LarsLangenbach/halloween-animatronic/output/manual/s5_06_complete.png

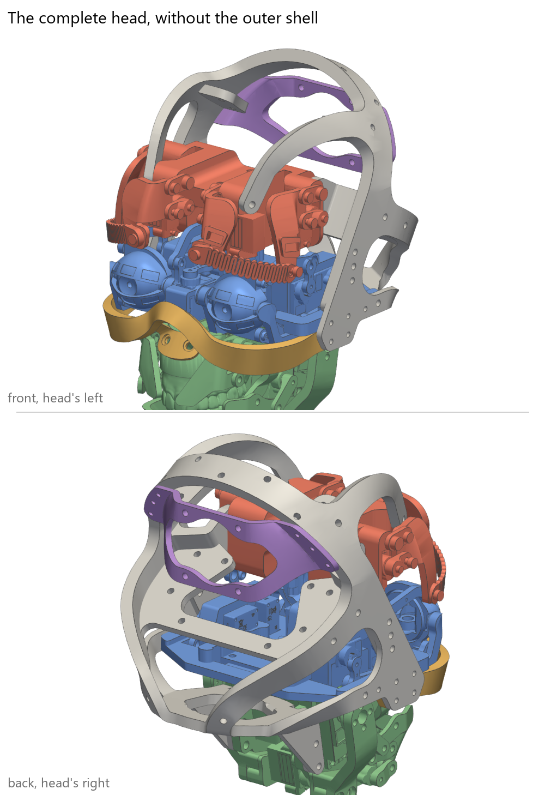
output/manual/s5_06_complete.png
