LarsLangenbach/halloween-animatronic/output/manual/s3_08_lower_teeth.png

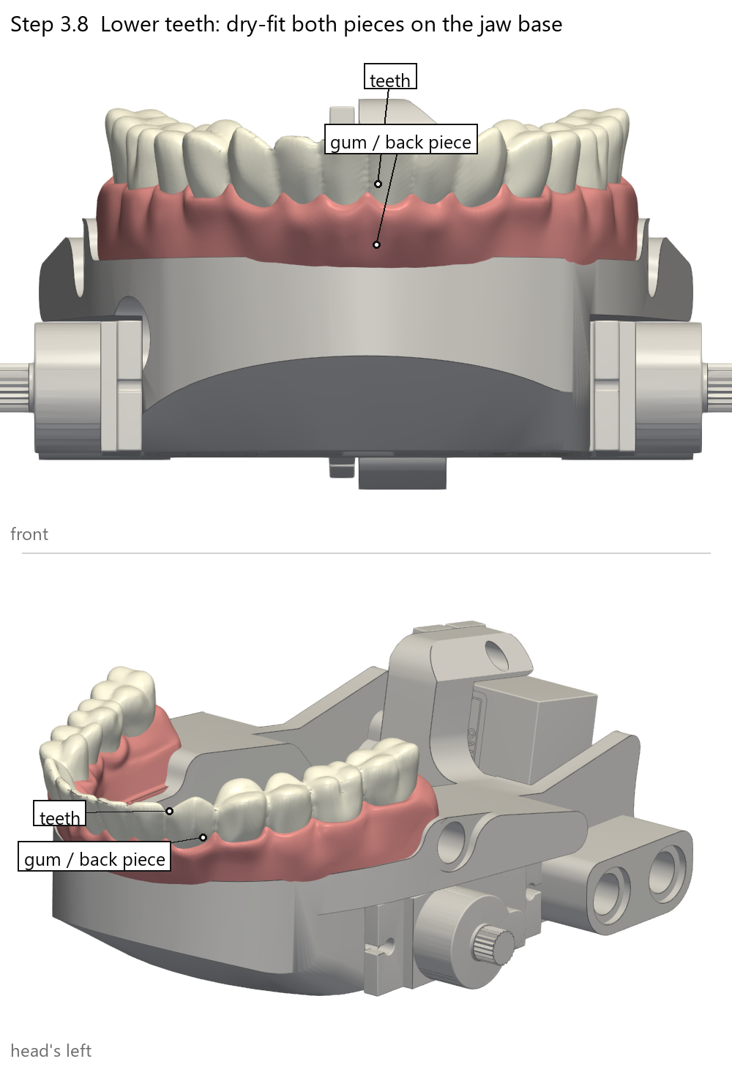
output/manual/s3_08_lower_teeth.png
