LarsLangenbach/halloween-animatronic/process_images/README.md

# Process images

The picture record of the build, oldest first. One folder per snapshot, made with `python cad/snapshot.py <label> --note "..."` after a check.
The build log ([docs/BUILD_LOG.md](../docs/BUILD_LOG.md)) links here.

- **2026-10-15_01_M1-layout-1.0x-life-size**: M1 first fit test at true life size (1.0x, average head): the eye and mouth mechanisms crash into each other (17 mm) and stick out of the skull. Re-rendered with the final check tools. ([layout.png](2026-10-15_01_M1-layout-1.0x-life-size/layout.png), 8 file(s))
- **2026-10-15_02_M1-layout-1.2x-average-head**: M1 at 1.2x with an average head shape: everything fits except the EyeMech side plates, which poke 7 mm out through the temples (see the front section). ([layout.png](2026-10-15_02_M1-layout-1.2x-average-head/layout.png), 8 file(s))
- **2026-10-15_03_M1-layout-1.2x-boxy-temples**: M1 at 1.2x with boxy, flat-sided temples: everything fits, but only 2.5 mm between the eye and mouth mechanisms, too little for any skull between them. ([layout.png](2026-10-15_03_M1-layout-1.2x-boxy-temples/layout.png), 8 file(s))
- **2026-10-15_04_M1-layout-1.2x-A2-approved**: M1 approved layout (D4 = A2): 1.2x, boxy temples, mouth 3 mm lower. 5.5 mm between the mechanisms, everything inside the head. Also the calibration coupon print check. ([layout.png](2026-10-15_04_M1-layout-1.2x-A2-approved/layout.png), 9 file(s))
- **2026-10-15_05_M1-motion-and-space**: M1 motion check: jaw opens cleanly to 35 deg (25 needed; lips open 12 to 41 mm), lids and eyes sweep clear, brow bays (purple) reserved above the eyes, cable channel (yellow) down the back of a thickened neck. Layout re-checked with the thicker neck. ([sweep.png](2026-10-15_05_M1-motion-and-space/sweep.png), 17 file(s))
- **2026-10-15_06_M1-motion-review-tongue-clash**: M1 motion after the fresh-eyes review: the check now catches a real clash: the tongue's back corner cuts up to ~2 mm into a fixed mouth servo between about 3 and 25 deg of jaw opening. Everything else on the jaw is clean to 35 deg; the servo horns now turn with the jaw; the jaw-link section shows the link turning on its bore. ([sweep.png](2026-10-15_06_M1-motion-review-tongue-clash/sweep.png), 17 file(s))
- **2026-10-15_07_M1-complete**: M1 complete: both Cogley mechanisms fit the 1.2x head at rest and through every motion (eye and lid ranges now from Cogley's firmware). The tongue/servo contact is accepted on the team's bench experience (D12). Brow bays and the cable channel are reserved. ([sweep.png](2026-10-15_07_M1-complete/sweep.png), 17 file(s))
- **2026-10-15_08_M2-brow-mechanism-v1**: M2 eyebrow v1: concept study (a whole-brow plate lifts off the skin, two snap pads on one skewed pivot track it within 0.9/1.6 mm, inner end rises 10.9 vs outer 7.6) and the first brow CAD: carrier, bracket, MG90S, 2:1 pushrod drive. Clears the EyeMech and lids through the full travel; first fully clean check (0 warnings). ([brow.png](2026-10-15_08_M2-brow-mechanism-v1/brow.png), 28 file(s))
- **2026-10-15_09_M2-brow-v1.1-stops-and-rig**: M2 eyebrow v1.1 after review: ball-stud room in the pushrod drive, hub sized to a stock M3 shoulder screw, flange inserts, adjustable hard stops on the double-arm horn (clear inside the travel, engage just past it), and the bench rig (a printed forehead fragment with a pad window and skin-clamp inserts). Check PASS, 0 warnings. ([brow.png](2026-10-15_09_M2-brow-v1.1-stops-and-rig/brow.png), 28 file(s))
- **2026-10-15_10_M3-start-true-offset-envelopes**: Accuracy fix before the skull: the skin and skull envelopes are now true offsets of the face (the first version made the skin as thin as 1.4 mm where the head leans). Every check re-run on them: layout, motion and eyebrows all still pass, the brow pivot moved about 1 mm, PASS with 0 warnings. ([brow.png](2026-10-15_10_M3-start-true-offset-envelopes/brow.png), 30 file(s))
- **2026-10-15_11_M3-skull-v0**: M3 skull v0: the printed skull the skin sits on: a 2.4 mm wall on true-offset envelopes, eye+brow and mouth openings cut square to the wall (no slivers), four printable pieces plus a shelf between the eyes and the mouth, and plates the brow brackets bolt up into. Nothing touches it at rest or in motion; PASS, 0 warnings. No joints, mounts, access panel or neck interface yet. ([skull.png](2026-10-15_11_M3-skull-v0/skull.png), 36 file(s))
- **2026-10-15_12_M3-skull-joints**: M3 skull with joints: 24 screwed tabs along the four seams (inserts in tabs behind the wall, countersunk screws flush under the skin), placed automatically clear of every mechanism, sweep, opening, the shelf and the brow plates. PASS, 0 warnings. ([skull.png](2026-10-15_12_M3-skull-joints/skull.png), 36 file(s))
- **2026-10-16_13_M3-eyemech-cradle**: M3: the EyeMech's cradle on the shelf (pads under its feet, a rear stop for eye-depth shims) and a retaining strap over the back of its base plate; shelf and strap bolt to ledges on the skull. PASS, 0 warnings. ([skull.png](2026-10-16_13_M3-eyemech-cradle/skull.png), 36 file(s))
- **2026-10-16_14_M3-neck-and-access-panel**: M3-neck-and-access-panel ([skull.png](2026-10-16_14_M3-neck-and-access-panel/skull.png), 38 file(s))
- **2026-10-16_15_M5-sculpt-base-and-service**: Sculpt base v1 (whole head, skull + 3 mm, eye sockets, grooves, base plate); service paths for the back, EyeMech and brows ([sculpt.png](2026-10-16_15_M5-sculpt-base-and-service/sculpt.png), 49 file(s))
- **2026-10-16_16_D14-cogley-head-fit**: Cogley's Robot Head a2.0.33 imported and fitted inside our head, eyes on ours ([studies_cogley_fit.png](2026-10-16_16_D14-cogley-head-fit/studies_cogley_fit.png), 57 file(s))
- **2026-10-16_17_cogley-brow-bar**: Cogley's flexible brow bar (Part 11): a pleated TPU strip, why PLA won't do ([studies_cogley_brow_bar.png](2026-10-16_17_cogley-brow-bar/studies_cogley_brow_bar.png), 58 file(s))
- **2026-10-16_18_cogley-complete-head**: Cogley's complete head with his outer shell: the new base for the face (D17) ([studies_cogley_complete.png](2026-10-16_18_cogley-complete-head/studies_cogley_complete.png), 63 file(s))
- **2026-10-16_19_cogley-eye-mount**: How the eye mechanism mounts in Cogley's frame: on the mouth's top plate, 2 screws per side through the frame into the base plate's ends, cheek bone underneath ([studies_cogley_eye_mount.png](2026-10-16_19_cogley-eye-mount/studies_cogley_eye_mount.png), 70 file(s))
- **2026-10-16_20_sculpt-base-v2**: Sculpt base v2 on Cogley's head: the 3 print files, assembled and exploded ([sculpt_files.png](2026-10-16_20_sculpt-base-v2/sculpt_files.png), 76 file(s))
- **2026-10-16_21_face-mask**: Face mask (D19): a man's face shell on the mechanism, clear of Cogley's head ([sculpt_face_mask.png](2026-10-16_21_face-mask/sculpt_face_mask.png), 88 file(s))
- **2026-10-16_22_face-mask-v2**: Face mask v2: closed eyes, natural nose and mouth, smooth edge, up onto the skull ([sculpt_face_mask.png](2026-10-16_22_face-mask-v2/sculpt_face_mask.png), 88 file(s))
- **2026-10-16_23_face-mask-v3**: Face mask v3: smooth, closed eyes, ears, mouth on Cogley's lip plates ([sculpt_face_mask.png](2026-10-16_23_face-mask-v3/sculpt_face_mask.png), 88 file(s))
- **2026-10-16_24_face-mask-v4**: Face mask v4: open eyes on the eye axes, MakeHuman lips on Cogley's lip plates ([sculpt_face_mask.png](2026-10-16_24_face-mask-v4/sculpt_face_mask.png), 88 file(s))
- **2026-10-16_25_face-mask-v5**: Face mask v5: MakeHuman's own eyes (with eyeballs) and lips, placed on the mechanism ([sculpt_face_mask.png](2026-10-16_25_face-mask-v5/sculpt_face_mask.png), 88 file(s))
- **2026-10-16_26_face-mask-v6**: Face mask v6: eyes exactly on the eye axes, real MakeHuman lips with a clean closed line, inside never crosses the skin ([skull.png](2026-10-16_26_face-mask-v6/skull.png), 62 file(s))
- **2026-10-16_27_face-mask-v7**: Face mask v7: flat lips with parting line and lip outlines; iris rings inside the eyes ([skull.png](2026-10-16_27_face-mask-v7/skull.png), 68 file(s))
- **2026-10-16_28_face-mask-v7b**: Face mask v7b: mouth area completely flat from under the nose to above the chin, with the lip lines ([skull.png](2026-10-16_28_face-mask-v7b/skull.png), 68 file(s))
- **2026-10-16_29_face-mask-v8**: Face mask v8: 2 mm shell; eyes and mouth flat with marks, nose low as a guide ([skull.png](2026-10-16_29_face-mask-v8/skull.png), 76 file(s))
- **2026-10-16_30_face-mask-v9**: Face mask v9: almond eyelids back, eye openings flat (no eyeball, no target) ([skull.png](2026-10-16_30_face-mask-v9/skull.png), 83 file(s))
- **2026-10-17_31_lips-on-printed-mask**: Where the lips really sit on the printed v9 mask: 71.2 mm below the eye line, about 6 mm above the printed groove ([views.png](2026-10-17_31_lips-on-printed-mask/views.png), 11 file(s))
- **2026-10-17_32_mask-on-cogley-head**: The printed mask (v9) see-through on Cogley's whole head, with eye centres and the true lip line ([views.png](2026-10-17_32_mask-on-cogley-head/views.png), 12 file(s))
- **2026-10-20_33_mold-base**: Mold base for the plaster mold: the clay-covered mask face up in a printed collar (ledge, lip, flared skirt), posts, flange with keys, walls; 4 pieces. Red = where a one-piece mold would lock (fill with clay or use side pieces) ([mold.png](2026-10-20_33_mold-base/mold.png), 53 file(s))
- **2026-10-20_34_mold-base-removable-walls**: Mold base v2: the walls are 4 separate L corners clipped together at ears, standing outside a rib on the plate; they come off outward before the plaster is lifted; 8 pry pockets ([mold.png](2026-10-20_34_mold-base-removable-walls/mold.png), 53 file(s))
- **2026-10-20_35_mold-pry-wedges**: Mold base v3: 8 loose pry wedges in gaps in the rib against the walls; pulled out with an M3 screw once the walls are off, they leave slots under the flange for a screwdriver ([mold.png](2026-10-20_35_mold-pry-wedges/mold.png), 54 file(s))
- **2026-10-22_36_assembly-manual**: Assembly manual pictures for Cogley's Robot Head a2.0.33: inserts per part, EyeMech servo map, mouth, brows and mounting steps, one image per step ([s3_12_mouth_servo_map.png](2026-10-22_36_assembly-manual/s3_12_mouth_servo_map.png), 28 file(s))
- **2026-10-25_37_assembly-manual-eyes-inserts**: Assembly manual: the EyeMech built step by step (2.2-2.13, from his e3.1 model), the 28 M3 inserts in the mouth and brow linkage parts (step 1.6), and the lip, corner, tongue and brow steps redrawn with them ([s2_13_eye_servo_map.png](2026-10-25_37_assembly-manual-eyes-inserts/s2_13_eye_servo_map.png), 20 file(s))
- **2026-10-25_38_eyemech-servo-joints**: How the two eye servos drive the eyes: horn screwed to the shaft, a peg turning in the horn's far hole (up/down: arch lever; left/right: part B) ([studies_eye_joint_left_right.png](2026-10-25_38_eyemech-servo-joints/studies_eye_joint_left_right.png), 2 file(s))
- **2026-10-28_39_enclosure-concept**: Enclosure concept: a printed D 340 canister round the head, base drum and top cap in quadrants, a rolled 1 mm clear sheet in slits, a 120-degree opaque back column; the real head drawn inside to scale ([studies_enclosure_concept.png](2026-10-28_39_enclosure-concept/studies_enclosure_concept.png), 2 file(s))
- **2026-10-28_40_enclosure-concept-camera**: Enclosure concept with the camera: in the top cap's front band, lens behind a D 8 hole among the vents, 10 deg down; cable round the cap ring and down the back column ([studies_enclosure_concept.png](2026-10-28_40_enclosure-concept-camera/studies_enclosure_concept.png), 2 file(s))
- **2026-10-28_41_enclosure-concept-no-lights**: Enclosure concept without lights: the LED ring is dropped, the camera stays in the cap's front band ([studies_enclosure_concept.png](2026-10-28_41_enclosure-concept-no-lights/studies_enclosure_concept.png), 2 file(s))
- **2026-10-28_42_enclosure-concept-webcam**: Enclosure concept with the Logitech 1080p webcam in a cradle against the cap's front wall, lens behind a D 12 hole, 10 deg down; USB lead down the column and out of the base ([studies_enclosure_concept.png](2026-10-28_42_enclosure-concept-webcam/studies_enclosure_concept.png), 2 file(s))
- **2026-10-28_43_enclosure-concept-power-box**: Enclosure concept, sizes fixed: D 340 x 638, 1 mm PETG sheet, the power box (bank, trigger, buck, fuses) and two boards on the floor tray, a back hatch for the bank and the leads to the laptop, the Logitech webcam in the cap ([studies_enclosure_concept.png](2026-10-28_43_enclosure-concept-power-box/studies_enclosure_concept.png), 2 file(s))
- **2026-10-28_44_enclosure-concept-speaker**: Enclosure concept with the speaker back in the base: a Dayton ND65-4 2.5 in driver in a sealed chamber behind the front slots, its 5 V amp beside it; power box, two boards, back hatch, webcam in the cap ([studies_enclosure_concept.png](2026-10-28_44_enclosure-concept-speaker/studies_enclosure_concept.png), 2 file(s))
- **2026-10-28_45_enclosure-concept-usb-speaker**: Enclosure concept: the speaker is a ready-made Anker PowerConf S330 USB speakerphone puck flat on the tray behind the front slots (no soldering); power box, two boards, back hatch, webcam in the cap ([studies_enclosure_concept.png](2026-10-28_45_enclosure-concept-usb-speaker/studies_enclosure_concept.png), 2 file(s))
- **2026-10-28_46_enclosure-concept-cheap-speakers**: Enclosure concept: the speakers are a cheap Amazon Basics USB-powered pair (3.5 mm aux), one each side behind the base's front slots; power box, two boards, back hatch, webcam in the cap ([studies_enclosure_concept.png](2026-10-28_46_enclosure-concept-cheap-speakers/studies_enclosure_concept.png), 2 file(s))
- **2026-10-28_47_enclosure-concept-sony-xb12**: Enclosure concept: the speaker is the human's Sony SRS-XB12 on its side by the back hatch (aux from the laptop); power box, two boards, webcam in the cap ([studies_enclosure_concept.png](2026-10-28_47_enclosure-concept-sony-xb12/studies_enclosure_concept.png), 2 file(s))
- **2026-10-28_48_enclosure-concept-front-grille**: Enclosure concept: the Sony SRS-XB12 moves to the front of the base, driver end at a snap-out grille panel in the front wall (also the access to its buttons) ([studies_enclosure_concept.png](2026-10-28_48_enclosure-concept-front-grille/studies_enclosure_concept.png), 2 file(s))
- **2026-10-28_49_enclosure-concept-neck-spine**: Enclosure concept with the proposed neck (Q17): a D 100 column to z 70 under the jaw's swing, then a 30 x 80 spine behind the jaw up into the frame's nape ribs; the jaw at rest and open drawn for clearance ([studies_enclosure_concept.png](2026-10-28_49_enclosure-concept-neck-spine/studies_enclosure_concept.png), 2 file(s))
- **2026-10-29_50_enclosure-v0**: Enclosure and neck modelled (M8 v0): 31 prints, the canister round the head, the neck spine behind the jaw; check PASS, the reviewer's five findings fixed ([enclosure.png](2026-10-29_50_enclosure-v0/enclosure.png), 65 file(s))
- **2026-10-29_51_enclosure-v1**: Enclosure v1 for a one-day build: eleven thin prints plus two PETG sheets; check PASS; studies_neck_mount.png shows how the head attaches (frame, spine, foot, pedestal, tray, every screw) ([enclosure.png](2026-10-29_51_enclosure-v1/enclosure.png), 72 file(s))
- **2026-10-29_52_lids-plate**: Just the eyelids: Cogley's 4 lid sets (size B file) on one plate in his print-in-place pose ([plates_cogley_lids_plate.png](2026-10-29_52_lids-plate/plates_cogley_lids_plate.png), 1 file(s))
- **2026-10-29_53_lids-keyed**: Keyed lids (D27): Cogley's lids perforated with counterbored radial holes so the brushed silicone rivets through; close-ups and the 4-set plate ([plates_cogley_lids_keyed.png](2026-10-29_53_lids-keyed/plates_cogley_lids_keyed.png), 2 file(s))
- **2026-10-29_54_lids-keyed-5mm**: Keyed lids (D27) at the 5.0 pitch after review: 21-24 holes per lid, 0.97 mm ribs between counterbores ([plates_cogley_lids_keyed.png](2026-10-29_54_lids-keyed-5mm/plates_cogley_lids_keyed.png), 2 file(s))
- **2026-10-29_52_neck-clamp**: Neck v2 (D30): the neck clamps Cogley's nape ring between a saddle, a collar in its hexagonal hole and two plates with 4 x M4; nothing drilled in his parts ([studies_neck_mount.png](2026-10-29_52_neck-clamp/studies_neck_mount.png), 72 file(s))
- **2026-10-29_53_band-printed**: The base's band printed in two halves instead of PETG (D31): pointed openings, the leads' notch, seam walls; band_print_check.png shows the halves on the bed ([enclosure.png](2026-10-29_53_band-printed/enclosure.png), 66 file(s))
- **2026-10-29_54_band-nut-slots**: Printed band after review: nut slots for the panels' upper screws, the tie under B's notch; band_print_check.png and band_nut_boss.png added ([enclosure.png](2026-10-29_54_band-nut-slots/enclosure.png), 66 file(s))
- **2026-10-30_55_enclosure-manual**: Enclosure build manual pictures, one per step: neck inserts, the head's test fit, the pedestal's hand-cut lead door and glue spots, rings, band, nut slots, panels, the bay, the clamp plates, deck, window, cap ([s6_03_complete.png](2026-10-30_55_enclosure-manual/s6_03_complete.png), 18 file(s))
- **2026-10-30_59_body-twin**: Frank's body twin (perform/, D32): the CAD head moving with the servo stream, here simulated: a surprised face (jaw part-open, lids wide, eyes up, brows raised), at rest, and from the side ([studies_twin_surprised.png](2026-10-30_59_body-twin/studies_twin_surprised.png), 3 file(s))
