LarsLangenbach/halloween-animatronic/process_images/2026-10-28_39_enclosure-concept/studies_enclosure_concept.md

# Enclosure concept numbers

- Axis: x 0, y -70 (the neck's axis, SCULPT_NECK).
- Head about the axis: front r 119, back r 117, sides r 103; crown z 351.
- Sheet D 300 inside: clear 31 at the face, 33 at the back, 47 at the ears.
- Sheet blank: 630 long x 458 tall, 1 thick (240 deg of the circle).
- Rings D 340 outside, 4 quadrants each (a quadrant's box is 170 x 170, the bed is 256).
- Base 118 tall (bay 96 clear inside), window 440, cap 80; overall 638.
- Back column: 120 deg arc, 10 thick, 2 wide x 2 tall pieces (each 170 chord x 220 tall).
- Pedestal D 130 to 110, 40 tall, under the neck (Q17) with 4 x M4 on a 50 square and a D 25 bore.
