LarsLangenbach/halloween-animatronic/process_images/2026-10-28_43_enclosure-concept-power-box/studies_enclosure_concept.md

# Enclosure concept numbers

- Axis: x 0, y -70 (the neck's axis, SCULPT_NECK).
- Head about the axis: front r 119, back r 117, sides r 103; crown z 351.
- Sheet D 300 inside: clear 31 at the face, 33 at the back, 47 at the ears.
- Sheet: 1 mm clear PETG, blank 630 long x 458 tall (240 deg of the circle).
- Rings D 340 outside, 4 quadrants each (a quadrant's box is 170 x 170, the bed is 256).
- Base 118 tall (bay 96 clear inside), window 440, cap 80; overall 638.
- Back column: 120 deg arc, 10 thick, 2 wide x 2 tall pieces (each 170 chord x 220 tall).
- Pedestal D 130 to 110, 40 tall, under the neck (Q17) with 4 x M4 on a 50 square and a D 25 bore.
- Camera: Logitech 1080p webcam (94 x 29 x 24, 78 deg) in a cradle against the cap's front wall at z 430, lens behind a D 12 hole among the vents, 10 deg down; its 1.5 m USB lead runs round the cap ring and down the back column to the base. Its two mics hear through the vent slots beside the lens, so the base needs no mic.
- Base bay: the power bank 161 x 55 x 50, the buck 85 x 60 x 28 with the trigger, fuses, WAGOs and capacitor, and 2 boards 95 x 65 x 20, all on the floor tray; a back hatch under the column's foot for the bank and the leads out. The laptop and the speaker stay outside.
