LarsLangenbach/halloween-animatronic/process_images/2026-10-15_08_M2-brow-mechanism-v1/studies_brow_concepts.md

# M2 brow concept study

Left brow, head scale 1.2. Brow line z 238.4 (26.0 above the eye line). Carrier face 1.5 behind the skin's inner surface. Travel at mid-brow (x 37): +10.0 / -5.0 along the skin. Limits: push <= 1.0, pull <= 3.0, inner/outer rise 1.5 +- 0.1 (D5).

## A: one plate across the whole brow, axis along x (reference)

| r behind the brow | worst push | worst pull | inner / outer rise |
|---|---|---|---|
| 20 | 1.8 | 6.9 | 9.9 / 6.1 |
| 30 | 1.1 | 4.7 | 10.0 / 7.4 |
| 40 | 0.8 | 3.6 | 10.0 / 8.0 |
| 50 | 0.6 | 2.9 | 9.9 / 8.4 |
| 70 | 0.4 | 2.2 | 9.9 / 8.8 |

A rigid plate 46 mm wide can't follow the face as it curves back toward the temple: it either digs into the skin or lifts off by several mm. Hence the two-pad carrier.

## P: two snap pads (|x| 22 and 52, 10 mm square) on one axis

Searched 2431 pivots (r 15..75, offset along the face -20..20, skew -24..24 deg); 3 meet every limit with the pivot inside the brow bay. Best ones:

| r | offset | skew deg | pivot (y, z above eyes) | push | pull | inner / outer rise |
|---|---|---|---|---|---|---|
| 45 | +4 | +12 | (-22.1, 21.2) | 0.90 | 1.62 | 10.9 / 7.6 |
| 45 | +4 | +15 | (-22.1, 21.2) | 0.91 | 1.65 | 11.1 / 7.4 |
| 45 | +4 | +18 | (-22.1, 21.2) | 0.92 | 1.67 | 11.3 / 7.1 |

**Pick: r 45, offset +4, skew +12 deg.** Pivot at x 27.1, y -22.1, z 233.6 (eye line + 21.2), 46.3 behind the carrier face; axis (0.978, 0.208, 0). Pads move 0.90 toward / 1.62 away from the skin; inner pad rises 10.9, outer 7.6 at full raise. Servo rotation for full travel: +12 / -6 deg (approx.).
