LarsLangenbach/halloween-animatronic/process_images/2026-10-29_52_neck-clamp/enclosure.md

# Enclosure check

- Head about the axis: widest r 118.8 at (2, 49, 98); 19.4 inside the sheet (D 276). Crown z 351.3, 88.7 under the cap.
- Sheet: 478 tall, z -40..438; blank 891 x 477 mm (a full tube, 20 overlap, 1 play in height).
- Band: 110 tall, z -140..-30; blank 928 x 109 mm (a full tube, 20 overlap, 1 play in height).

## The neck and its clamp against Cogley's head (at rest)

- neck: no overlap with his parts; 0.08 mm from the frame's nape ring (modelled gap 0.1: it sits on the ring)
- neck_clamp_L: no overlap with his parts; 0.12 mm from the frame's nape ring (modelled gap 0.1: it sits on the ring)
- neck_clamp_R: no overlap with his parts; 0.12 mm from the frame's nape ring (modelled gap 0.1: it sits on the ring)
- The clamp: the collar's top stays 0.9 under the plates, so four M4 x 12 pull the plates down onto the ring and the ring onto the saddle
- Screw (+18, -5): 35 mm clear over its head for the hex key (rear plate off)
- Screw (-18, -5): 35 mm clear over its head for the hex key (rear plate off)
- Screw (+13, -14): 30 mm clear over its head for the hex key (rear plate off)
- Screw (-13, -14): 30 mm clear over its head for the hex key (rear plate off)

## The jaw swept against the neck and its clamp plates

| angle | gap to the neck |
|---|---|
| 0 | 26.1 |
| 5 | 24.2 |
| 10 | 21.0 |
| 15 | 17.2 |
| 20 | 13.3 |
| 25 | 9.6 |
| 30 | 6.0 |
| 35 | 2.5 |

## What lives in the base and the cap

- bank: z -141..-91, out to r 134
- board_1: z -91..-71, out to r 149
- board_2: z -91..-71, out to r 149
- buck: z -141..-113, out to r 126
- speaker: z -140..-67, out to r 130
- webcam: z 410..439, y 33..57

## Pieces on the bed (in the print pose)

| part | x | y | z |
|---|---|---|---|
| enc_cap_F | 249 | 249 | 41 |
| enc_cap_B | 249 | 249 | 41 |
| enc_top_F | 246 | 246 | 12 |
| enc_top_B | 246 | 246 | 12 |
| enc_bottom_F | 246 | 246 | 12 |
| enc_bottom_B | 246 | 246 | 12 |
| enc_tray | 250 | 250 | 52 |
| enc_pedestal | 90 | 90 | 142 |
| enc_grille | 126 | 96 | 16 |
| enc_hatch | 126 | 96 | 16 |
| neck | 100 | 122 | 183 |
| neck_clamp_L | 34 | 64 | 5 |
| neck_clamp_R | 34 | 64 | 5 |

## Result

- note: the jaw clears the neck through 35 deg

Render: enclosure.png
