LarsLangenbach/halloween-animatronic/output/plates/cogley_lids_keyed.md

# Keyed lids (D27)

Cogley's four lid sets from `eyemech_e3.2_MG90s_B_cogley.3mf`, each lid perforated for the brushed silicone skin: Ø2.2 radial through-holes with a Ø3.4 × 0.7 counterbore flush with the inner face, 5.0 mm apart, only through plain 1.6 mm wall with 1.1 mm kept round each counterbore. Built by `cad/lid_keyed.py`. Result: **PASS**

| set | holes | STEP fit median / max | nearest holes | wall between counterbores | removed mm³ |
|---|---|---|---|---|---|
| LidTR (object 26) | 23 | 0.006 / 0.044 | 4.37 | 0.97 | 252 |
| LidBR (object 30) | 21 | 0.008 / 0.055 | 4.38 | 0.98 | 225 |
| LidTR (object 34) | 21 | 0.003 / 0.041 | 4.38 | 0.98 | 225 |
| LidBR (object 38) | 24 | 0.003 / 0.052 | 4.37 | 0.97 | 270 |

Plate: `cogley_lids_keyed_plate.stl` (preview `cogley_lids_keyed_plate.png`); close-ups `cogley_lids_keyed.png`.
