LarsLangenbach/halloween-animatronic/process_images/2026-10-29_51_enclosure-v1/enclosure.md

# Enclosure check

- Head about the axis: widest r 118.8 at (2, 49, 98); 19.4 inside the sheet (D 276). Crown z 351.3, 88.7 under the cap.
- Sheet: 478 tall, z -40..438; blank 891 x 477 mm (a full tube, 20 overlap, 1 play in height).
- Band: 110 tall, z -140..-30; blank 928 x 109 mm (a full tube, 20 overlap, 1 play in height).

## The neck against Cogley's head (at rest)

- No overlap with any of his parts; the spine's top sits under the frame's nape members
- Gap spine top to the frame: 1.5 mm (0 = touching or inside)

## The jaw swept against the neck

| angle | gap to the neck |
|---|---|
| 0 | 26.1 |
| 5 | 24.2 |
| 10 | 21.0 |
| 15 | 17.2 |
| 20 | 13.3 |
| 25 | 9.6 |
| 30 | 6.0 |
| 35 | 2.5 |

## What lives in the base and the cap

- bank: z -141..-91, out to r 134
- board_1: z -91..-71, out to r 149
- board_2: z -91..-71, out to r 149
- buck: z -141..-113, out to r 126
- speaker: z -140..-67, out to r 130
- webcam: z 410..439, y 33..57

## Pieces on the bed (in the print pose)

| part | x | y | z |
|---|---|---|---|
| enc_cap_F | 249 | 249 | 41 |
| enc_cap_B | 249 | 249 | 41 |
| enc_top_F | 246 | 246 | 12 |
| enc_top_B | 246 | 246 | 12 |
| enc_bottom_F | 246 | 246 | 12 |
| enc_bottom_B | 246 | 246 | 12 |
| enc_tray | 250 | 250 | 52 |
| enc_pedestal | 90 | 90 | 142 |
| enc_grille | 96 | 16 | 126 |
| enc_hatch | 96 | 16 | 126 |
| neck | 100 | 105 | 170 |

## Result

- note: the jaw clears the neck through 35 deg

Render: enclosure.png
