LarsLangenbach/halloween-animatronic/process_images/2026-10-29_50_enclosure-v0/enclosure.md

# Enclosure check

- Head about the axis: widest r 118.8 at (2, 49, 98); 31.2 inside the sheet (D 300). Crown z 351.3, 48.7 under the cap.
- Sheet: 458 tall, z -46..412; blank 644 x 458 mm (the arc plus the forks' slots, 0.5 play at each end).

## The neck against Cogley's head (at rest)

- No overlap with any of his parts; the spine's top sits under the frame's nape members
- Gap spine top to the frame: 1.5 mm (0 = touching or inside)

## The jaw swept against the neck

| angle | gap to the neck |
|---|---|
| 0 | 26.1 |
| 5 | 24.2 |
| 10 | 21.0 |
| 15 | 17.1 |
| 20 | 13.3 |
| 25 | 9.6 |
| 30 | 6.0 |
| 35 | 2.5 |

## What lives in the base and the cap

- bank: z -134..-84, out to r 125
- board_1: z -134..-114, out to r 130
- board_2: z -134..-114, out to r 130
- buck: z -134..-106, out to r 59
- speaker: z -133..-59, out to r 152
- webcam: z 418..447, y 64..88

## Pieces on the bed

| part | x | y | z |
|---|---|---|---|
| enc_base_F | 240 | 89 | 98 |
| enc_base_L | 89 | 240 | 98 |
| enc_base_B | 240 | 89 | 98 |
| enc_base_R | 89 | 240 | 98 |
| enc_ring_1 | 170 | 170 | 12 |
| enc_ring_2 | 170 | 170 | 12 |
| enc_ring_3 | 170 | 170 | 12 |
| enc_ring_4 | 170 | 170 | 12 |
| enc_tray | 250 | 250 | 52 |
| enc_deck | 239 | 239 | 8 |
| enc_pedestal | 130 | 130 | 40 |
| enc_grille | 126 | 15 | 96 |
| enc_hatch | 126 | 15 | 96 |
| enc_column_R_lower | 161 | 97 | 232 |
| enc_column_R_upper | 161 | 97 | 220 |
| enc_column_L_lower | 151 | 99 | 232 |
| enc_column_L_upper | 151 | 99 | 220 |
| enc_capring_1 | 170 | 170 | 16 |
| enc_capring_2 | 170 | 170 | 16 |
| enc_capring_3 | 170 | 170 | 16 |
| enc_capring_4 | 170 | 170 | 16 |
| enc_cap_F | 240 | 71 | 52 |
| enc_cap_L | 71 | 240 | 52 |
| enc_cap_B | 240 | 71 | 52 |
| enc_cap_R | 71 | 240 | 52 |
| enc_captop_1 | 170 | 170 | 12 |
| enc_captop_2 | 170 | 170 | 12 |
| enc_captop_3 | 170 | 170 | 12 |
| enc_captop_4 | 170 | 170 | 12 |
| enc_lid | 239 | 239 | 8 |
| neck | 100 | 105 | 170 |

## Result

- note: the jaw clears the neck through 35 deg

Render: enclosure.png
