LarsLangenbach/halloween-animatronic/process_images/2026-10-29_52_neck-clamp/sculpt.md

# Sculpt base check

- his parts coming through the base: 0; 18 open meshes checked by distance only
- thinnest skin over his parts (to the base's surface): 2.58 mm (Hex socket head cap screw M3x0.50 x 10 4 at [87.0, -62.0, 238.0]); want >= 2.1
- eye left: sphere at [37.5, 0.0, 212.4], his eyeball at [37.5, 0.0, 212.4] (0.00 off)
- eye right: sphere at [-37.5, 0.0, 212.4], his eyeball at [-37.5, 0.0, 212.4] (0.00 off)
- sculpt_upper: 181.6 x 226.1 x 165.3 mm, 4167 cm3
- sculpt_lower: 169.0 x 210.3 x 146.0 mm, 2108 cm3
- sculpt_plate: 159.0 x 174.4 x 8.0 mm, 172 cm3

Renders: sculpt.png

## Issues

none
