LarsLangenbach/halloween-animatronic/process_images/2026-10-16_25_face-mask-v5/studies_cogley_fit.md

# Cogley head a2.0.33 in our head (study, D14)

His eye centres on ours: (+-37.5, 0, 212.4). Margins in mm, positive = inside. Robot outer shell left out (our shell replaces it).

| group | parts | worst vs skull inside | worst vs skull outside | worst part |
|---|---|---|---|---|
| frame | 1 | -3.2 | -0.8 | SkullFrame 0 at [77.0, -40.0, 180.0] |
| extras | 2 | -8.2 | -5.8 | CheekBone 0 at [0.0, 30.0, 202.0] |
| eyes | 35 | -0.5 | 1.9 | LidTR 1 at [-45.0, 17.0, 207.0] |
| mouth | 44 | -3.5 | -1.1 | UpperLeftLip 0 at [-8.0, 25.0, 150.0] |
| brows | 17 | -7.6 | -5.2 | Part 14 0 at [-22.0, 28.0, 253.0] |
| hardware | 88 | -5.1 | -2.7 | Hex socket head cap screw M3x0.50 x 10 0 at [86.0, -61.0, 217.0] |

Parts standing outside the skull's inside (negative margins):

-   -8.2  extras   CheekBone 0 at [0.0, 30.0, 202.0]
-   -7.6  brows    Part 14 0 at [-22.0, 28.0, 253.0]
-   -7.6  brows    Part 11 0 at [22.0, 28.0, 253.0]
-   -5.5  brows    Part 12 0 at [-28.0, 24.0, 259.0]
-   -5.1  hardware Hex socket head cap screw M3x0.50 x 10 0 at [86.0, -61.0, 217.0]
-   -5.1  hardware Hex socket head cap screw M3x0.50 x 10 3 at [-86.0, -61.0, 217.0]
-   -4.8  hardware Hex socket head cap screw M3x0.50 x 8 7 at [80.0, -40.0, 183.0]
-   -4.8  hardware Hex socket head cap screw M3x0.50 x 8 1 at [-80.0, -40.0, 183.0]
-   -4.5  hardware Hex socket head cap screw M3x0.50 x 10 1 at [-87.0, -63.0, 226.0]
-   -4.5  hardware Hex socket head cap screw M3x0.50 x 10 2 at [87.0, -63.0, 226.0]
-   -3.5  mouth    UpperLeftLip 0 at [-8.0, 25.0, 150.0]
-   -3.5  mouth    Part 34 0 at [8.0, 25.0, 150.0]
-   -3.3  hardware Hex socket head cap screw M3x0.50 x 10 4 at [87.0, -64.0, 235.0]
-   -3.3  hardware Hex socket head cap screw M3x0.50 x 10 5 at [-87.0, -64.0, 235.0]
-   -3.2  frame    SkullFrame 0 at [77.0, -40.0, 180.0]
-   -3.1  brows    Part 8 0 at [20.0, 23.0, 256.0]
-   -3.0  hardware Hex socket head cap screw M3x0.50 x 8 2 at [-80.0, -58.0, 183.0]
-   -3.0  hardware Hex socket head cap screw M3x0.50 x 8 4 at [80.0, -58.0, 183.0]
-   -2.5  hardware Hex socket head cap screw M3x0.50 x 8 3 at [-80.0, -40.0, 195.0]
-   -2.5  hardware Hex socket head cap screw M3x0.50 x 8 5 at [80.0, -40.0, 195.0]
-   -0.7  hardware Hex socket head cap screw M3x0.50 x 8 0 at [80.0, -57.0, 195.0]
-   -0.7  hardware Hex socket head cap screw M3x0.50 x 8 6 at [-80.0, -57.0, 195.0]
-   -0.5  eyes     LidTR 1 at [-45.0, 17.0, 207.0]
-   -0.5  eyes     LidTR 0 at [45.0, 17.0, 207.0]

His mouth (TopBase) against ours: [0.0, 1.3, 13.4] mm (x, y, z). His EyeMech base plate sits 0.2 mm above his TopBase's top.

Renders: cogley_fit.png
