LarsLangenbach/halloween-animatronic/process_images/2026-10-16_19_cogley-eye-mount/sculpt.md

# Sculpt base check

- skull outside the base: at most 0.00 mm (skull_front_upper at [20.5, 23.399999618530273, 201.8000030517578])
- eye left: sphere at [37.5, 0.0, 212.4], EyeMech eyeball at [37.5, -0.0, 212.4] (0.00 off)
- eye right: sphere at [-37.5, 0.0, 212.4], EyeMech eyeball at [-37.5, -0.0, 212.4] (0.00 off)
- sculpt_upper: 183.3 x 247.9 x 168.4 mm, 5088 cm3
- sculpt_lower: 167.8 x 215.7 x 186.0 mm, 3219 cm3
- sculpt_plate: 190.0 x 174.4 x 8.0 mm, 205 cm3

Renders: sculpt.png

## Issues

none
