LarsLangenbach/halloween-animatronic/process_images/2026-10-16_20_sculpt-base-v2/layout.md

# M1 layout fit table

Margins in mm: + = inside the allowed envelope, - = sticking out; the part named is the worst one.
Envelopes: eyes and lids inside the outer skin; lip plates inside the skin's inner surface;
jaw and frame inside the skull's inner surface. Eye <-> mouth: closest approach, - = overlap.

| scale | head W x L x H | eye <-> mouth closest | eyemech eyes | eyemech lids | eyemech frame | mouth lips | mouth surfaces | mouth jaw | mouth frame |
|---|---|---|---|---|---|---|---|---|---|
| 1.00 | 156 x 210 x 297 | -9.8 (SnapEyemech_v20 / TopBase overlap 935 mm3) | +3.0 (Component74) | +0.8 (LidTR) | -11.4 (SnapEyemech_v20, 7 out) | +1.4 (Part_37) | +9.6 (Part_1) | -9.2 (Part_33, 2 out) | -4.3 (M3_Shoulder, 19 out) |
| 1.10 | 172 x 231 x 327 | -2.9 (SnapEyemech_v20 / TopBase overlap 24 mm3) | +6.6 (Component74) | +5.0 (LidTR) | -5.0 (SnapEyemech_v20, 5 out) | +2.3 (UpperLeftLip) | +9.6 (Part_1) | -2.5 (Part_33, 2 out) | -1.7 (M3_Shoulder, 4 out) |
| 1.20 | 187 x 252 x 356 | +5.5 (Base / TopBase) | +10.0 (Component74) | +8.5 (LidTR) | +1.2 (SnapEyemech_v20) | +2.4 (UpperLeftLip) | +9.6 (Part_1) | +3.2 (Part_33) | +0.7 (Part_29) |
| 1.30 | 203 x 273 x 386 | +12.5 (Base / TopBase) | +13.2 (Component74) | +11.6 (LidTR) | +6.5 (Base) | +2.5 (Part_34) | +9.7 (Part_1) | +8.2 (JawLink) | +2.1 (Part_29) |

## Parts outside their envelope at scale 1.2

none

Renders: layout.png (and layout_1..6.png)
