LarsLangenbach/halloween-animatronic/process_images/2026-10-16_24_face-mask-v4/brow.md

# M2 eyebrow mechanism check

Head scale 1.2. Carrier travel -6.9..+13.8 deg (+-3 overtravel checked), mid-brow -5.0/+10.0 mm. Gaps in mm, overlaps in mm3.

## At rest

| part | closest EyeMech part | inside skull | notes |
|---|---|---|---|
| bracket_L | 4.1 | +9.2 |  |
| servo_L | 16.2 | +5.5 |  |
| carrier_L | 6.6 | +1.2 |  |
| bracket_R | 3.9 | +9.4 |  |
| servo_R | 16.2 | +5.8 |  |
| carrier_R | 6.4 | +1.1 |  |

## Through the travel

| carrier deg | servo deg | transmission deg | carrier gap to EyeMech | to lid/eye sweep | to own bracket | to own servo | horn / pushrod gap | pad push / pull |
|---|---|---|---|---|---|---|---|---|
| -9.9 (over) | -20.1 | 81 | 6.4 | 4.2 | 2.8 | 19.5 | 1.3 | +0.02 / 1.52 |
| -6.6 | -13.2 | 84 | 6.5 | 4.7 | 2.8 | 19.5 | 1.3 | +0.07 / 1.00 |
| -3.2 | -6.5 | 87 | 6.4 | 4.7 | 2.8 | 19.6 | 1.3 | +0.06 / 0.47 |
| +0.1 | +0.2 | 90 | 6.4 | 4.7 | 2.8 | 19.6 | 1.5 | +0.02 / 0.00 |
| +3.4 | +6.9 | 86 | 6.3 | 4.7 | 2.8 | 19.5 | 1.3 | +0.42 / 0.15 |
| +6.8 | +13.7 | 83 | 6.0 | 4.7 | 2.8 | 19.1 | 1.2 | +0.71 / 0.49 |
| +10.1 | +20.6 | 79 | 5.5 | 4.7 | 2.8 | 18.7 | 1.2 | +0.86 / 0.99 |
| +13.5 | +27.8 | 76 | 5.0 | 4.7 | 2.8 | 18.2 | 1.4 | +0.85 / 1.65 |
| +16.8 (over) | +35.4 | 71 | 4.5 | 4.7 | 2.8 | 17.4 | 1.2 | +0.70 / 2.44 |

Hard stops (set 0.5 past each end): the horn stays >= 0.29 from them inside the travel; the lower stop engages within 3 deg past the travel; the raise stop engages within 3 deg past the travel.
Bench rig: the moving parts stay >= 1.4 from it over the travel; the bracket overlaps it by -0.0 mm3 (its flange sits on the rig's ceiling).

Servo turns -13.9..+28.5 deg for the full brow travel (2:1 four-bar); worst transmission angle 76 deg (90 is ideal). Pads move 0.86 toward / 1.65 away from the skin.

Left and right carriers are 33.7 apart at rest.

Renders: brow.png (and brow_1..6.png)

## Issues

none
