LarsLangenbach/halloween-animatronic/research_notes/Face engine plan research/servo_limits_and_power.md

# Servo limits and power: protecting the head while getting the most out of it

2026-10-30. A companion to `animation_state_machines.md`. It covers how to find each servo's real limits, where those limits get enforced so nothing can overstep them, and how to stay inside the power budget without making Frank timid. Power figures come from the Head Power Wiring page (claude.ai, 2026-10-26); servo figures come from `docs/BOM.md` and the two board programs.

## The short version

- **Three things can get hurt.**
  - The servos: one pushing against a stop draws its stall current non-stop, heats up and strips or burns out.
  - The printed parts and the skin: a servo is stronger than a lid hinge.
  - The power chain: too many servos starting at once pulls the bus voltage down. The power bank can cut out and servos go weak or twitch.
- **Measure, don't guess.** One session with the bench supply (it shows current and can limit it), the slider windows and a phone in slow motion gives every servo's real end stops, its useful range, its speed under the skin and its holding current. Those numbers go into one file.
- **Enforce the numbers in four places**, so one bug can't break anything:
  1. printed stops;
  2. the board programs: hard caps per servo that no laptop command can get past, plus a speed limit;
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
