LarsLangenbach/halloween-animatronic/output/plates/plates_preview_2.png

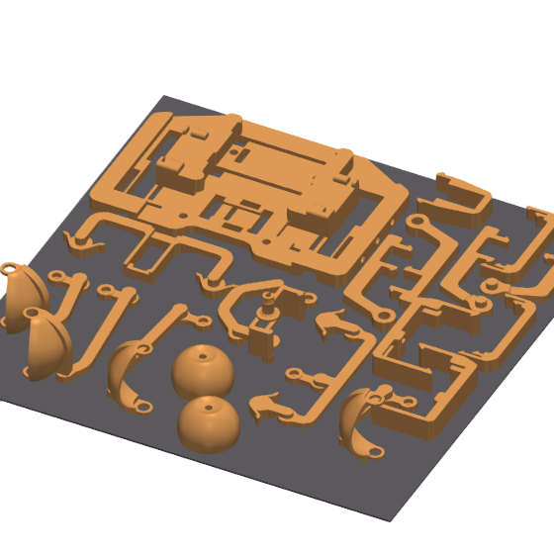
output/plates/plates_preview_2.png
