LarsLangenbach/halloween-animatronic/docs/BOM.md

# Bill of materials

Bought parts and hardware for what is designed so far. Status: `[have]` on hand, `[buy]` to order, `[confirm]` to check what you have. The quantities cover one head. Sizes marked ASSUMPTION are in `cad/params.py`; caliper what you buy and update them.

## Electronics and actuators

| Item | Qty | For | Status | Notes |
|---|---|---|---|---|
| MG90S micro servo (metal gear), with its horns | 19 + 2 spare | mouth 9 (incl. tongue), EyeMech 6, Cogley's brows 4 (D15) | [buy] | Genuine TowerPro: see *SG90 or MG90S* below for spotting fakes. Caliper one when they arrive (`MG90_*` in params.py came from Adafruit's MG90D model, 31.3 tab span; TowerPro says 32.1). |
| SG90 micro servo (plastic gear) | 3 | bench tests only | [have] | Not for the head: see below. |
| M3 heat-set insert (M3 × 4) + M3 × 8 socket head screw | 4 + 4 | the eye mechanism's base plate to Cogley's skull frame, 2 per side (ASSEMBLY.md) | [confirm] | The plate's end holes are Ø4–4.5 × 6 deep. Check the insert against them first. |
| TPU filament, about 95A | 1 spool (the bars take a few grams) | Cogley's flexible brow bars (Part 11, Part 14) | [buy] | Not PLA (PLAN Q18). On the P2S, feed it from the external spool, not the AMS, and use Bambu's TPU 95A preset. |
| MG996R servo | 2 | jaw | [confirm] | |
| Will Cogley mouth PCB (Raspberry Pi Pico, 12 servo outputs GP4–GP15, XT60 power in) | 2 | #1: the mouth (jaw 2, lips 8, tongue; 11 of 12 outputs). #2: the eyes (6) and the brows (4) (10 of 12) | [confirm: 2 on hand?] | Cogley runs the eyes and the brows on two separate Eyes/Brow/Neck boards. One mouth board can do both, with one combined program (PLAN D18). |

### SG90 or MG90S

They are not the same servo with a different shaft. Both have the same footprint and about the same spline (Ø4.9). The differences are inside and below the tabs:

| | SG90 | MG90S |
|---|---|---|
| Gears | plastic (POM) | metal (aluminium) |
| Output shaft | plastic, the horn screw self-taps into it | metal, tapped for a machine screw |
| Bearing | bushing | ball bearing |
| Body (L × W) | 22.7 × 12.2 | 22.8 × 12.2–12.4 |
| Tab to tab | 32.3 | 32.1–32.5 |
| Bottom to tab underside | 15.9–17 | 18.5 (about 1.5 deeper) |
| Bottom to spline top | 30.3–30.7 | 32.5 |
| Stall torque, 4.8 V | 1.8 kg·cm | 1.8 kg·cm (2.2 at 6 V) |
| Speed, 4.8 V | 0.10–0.12 s/60° | 0.10 s/60° |
| Stall current (measured) | 360 mA | 700 mA |
| Weight | 9 g | 13.4 g |

**What this means for the head:**
- The rated torque is the same. The difference is durability: the skin loads the gears all the time, and the mouth and brows run into hard stops. Plastic gears strip under that; metal gears don't. Use MG90S everywhere in the head.
- The 3 SG90s are fine for bench tests, but 3 is far short of the 19 the head needs.
- **Horns don't swap reliably.** Sources split between 20 and 21 teeth for both servos, and the horn screws differ. The printed ε3.2 eye set has horns for the MG90S.
- **Pockets:** an MG90S pocket takes an SG90 in plan, but the SG90 sits about 1.5 mm higher. An SG90 pocket is too shallow for an MG90S unless its bottom is open. Cogley's own head runs its eyes on SG90s with its own eye parts. Our printed set is the MG90S version.
- **Power:** an MG90S stalls at about twice the current of an SG90. Size the supply for it; Cogley uses 5 V 10 A.

**Fakes.** "MG90S" units with plastic gears are sold openly. Warning signs:
- a price under about US$4.50
- photos that hide the label
- a weight near 9 g instead of 13.4 g
- no tapped metal shaft
- a copper-coloured washer under the shaft

Weigh one and check the shaft before installing a batch.

Sources: TowerPro's SG90 and MG90S pages, Aus Electronics' measured SG90 drawing (TA0132), servodatabase.com, Electronicos Caldas' MG90S sheet, ProtoSupplies (measured currents), newscrewdriver.com (horn fit), vorpalrobotics.com (spotting clones). Collected 2026-10-16; the URLs are in the build log.

## Eyebrow mechanism (M2), both brows

| Item | Qty | Where | Status | Notes |
|---|---|---|---|---|
| M3 shoulder screw, ISO 7379, Ø4 × 10 shoulder | 2 | the carrier's pivot | [buy] | DATASHEET size. The head is assumed Ø8 × 4: caliper it (`SHOULDER_HEAD`). |
| M3 heat-set insert, short (M3 × 4) | 6 | bracket cheek 1 + flange 2, per brow | [confirm] | Hole Ø4.0 until the coupon says otherwise |
| M3 × 8 socket head screw | 4 | bracket flange to the skull (or the bench rig), from above | [confirm] | |
| M3 × 8 set screw (grub screw) | 4 | hard stops, 2 per brow | [buy] | Self-tapped into the printed ledge; set with a 1.5 mm hex key from above |
| M2 ball link | 4 | pushrods, 2 per brow | [buy] | RC-car type; ball about 3.5 above its mounting face (`BALL_STUD_H`, ASSUMPTION) |
| M2 threaded rod | 2 × ~20 mm | pushrods | [buy] | Ball-to-ball length 30; the links' thread sets the brow's neutral position |
| M2 × 6 self-tapping screw | 4 | servo tabs | [have] | Supplied with the MG90S |

## Bench rig (M2)

| Item | Qty | Notes |
|---|---|---|
| M3 heat-set insert (M3 × 4) | 6 | Clamp-strip holes above and below the window, for the skin sample (M4) |
| M3 × 8 socket head screw | 2 | Bracket flange to the rig's ceiling |

## Skull (M3, v0 joints)

| Item | Qty | Notes |
|---|---|---|
| M3 × 8 countersunk screw (ISO 10642) | 23 | seam joints, from outside; heads flush under the skin |
| M3 heat-set insert (M3 × 4) | 23 + 6 + 6 + 4 | seam tabs (installed from the tab's outer face before assembly), 4 shelf ledges, 2 strap ledges, 6 in the neck plate's collar, 4 in the access panel's lip |
| M3 × 8 socket head screw | 6 | shelf to its 4 ledges, strap to its 2 ledges |
| M3 × 6 countersunk screw (ISO 10642) | 6 + 4 | neck plate (6, through the wall into its collar) and access panel (4); an M3 × 8 would bottom out in their insert holes |
| M4 bolt | 4 | neck plate to the stand, on a 50 mm square. Length set by the stand (ASSUMPTION) |

## Sculpt base (M5)

| Item | Qty | Notes |
|---|---|---|
| Ø6 × 24 dowel (wood or steel) | 4 | joins the two head pieces at the split, glued |
| M4 heat-set insert (M4 × 8) | 4 | in the neck's underside. Hole Ø5.6 is an ASSUMPTION: check it against the inserts you have |
| M4 × 12 socket head screw | 4 | plate to the neck, from below (heads in counterbores). Not longer: an M4 × 16 bottoms out in the insert holes before the plate is clamped |
| Wood screw, Ø4–4.5 | 4 | plate to a board or turntable |
| Sulfur-free oil-based clay | as needed | e.g. Monster Clay. Sulfur stops platinum-cure silicone from curing (Q15) |
| PLA | about 0.8 kg | upper ~410 g, lower ~310 g, plate ~95 g (estimate) |

## Plaster mold of the clay face (M5, mold base)

How to use them: [PLASTER_MOLD.md](PLASTER_MOLD.md).

| Item | Qty | Notes |
|---|---|---|
| Ultracal 30 (or Hydrocal; plaster of Paris at a pinch) | 10 kg | the shell takes about 3 L mixed, about 4 kg of Ultracal; the rest covers waste and a spare batch. Mix 38 water : 100 plaster by weight |
| Burlap (jute hessian) | about 1 m² | cut into 5 × 15 cm strips and 10 × 10 cm squares before mixing |
| Release for the printed base | 1 tub or bottle | petroleum jelly thinned with mineral oil, Murphy's oil soap, or paste wax |
| Hot glue sticks | a few | seal the base's seams from below and outside |
| M3 × 20 bolts and nuts, or zip ties (or 4 medium binder clips, one per joint) | 8 | hold the four wall corners together at their ears, two per joint |
| M3 screw, any length over 10 mm | 1 | turned into each pry wedge's end to pull it out |
| Brass shim stock (or drink-can aluminium) | about 30 pieces of 2 × 4 cm | only for the three-piece mold |
| Dust mask, nitrile gloves, flexible buckets, chip brushes, kitchen scale | | Ultracal contains crystalline silica: mask on while mixing |
| PLA | about 1 kg | the 4 base pieces and 4 wall corners (about 1.8 L of model in all; trust the slicer) |

## Silicone skin (M4 pads, M6 face cast)

The skin silicone is **Smooth-On Dragon Skin FX-Pro** (PLAN D21, chosen 2026-10-15), brushed on in layers. Clay: Monster Clay. How to get the mold ready: [PLASTER_MOLD.md](PLASTER_MOLD.md), *Getting the mold ready for the silicone*.

| Item | Qty | Status | Notes |
|---|---|---|---|
| Smooth-On Dragon Skin FX-Pro (Trial, 2 lb) | 1 or 2 units [confirm] | [have] | Shore 2A platinum silicone. Mix 1A:1B by weight or volume; pot life 12 min, demold 40 min at 23 °C; keep it at or above 18 °C (65 °F) while it cures. [confirm] there is enough for the snap pads and a face cast or two. |
| Smooth-On Ease Release 200 spray | 1 can | [have] | The release Smooth-On recommends for this silicone; goes on after the sealer. |
| Mold sealer: acrylic spray (e.g. Krylon Crystal Clear), or petroleum jelly thinned with mineral spirits, or Smooth-On SuperSeal | 1 | [buy] | Seals the plaster mold. Only on a fully dry mold. **Not shellac**: Smooth-On says its alcohol makes silicone bond to the mold. The two Bulls Eye shellac cans ordered (Amazon 10/22, Home Depot 10/24) are not for the mold. |
| Smooth-On THI-VEX | 1 oz | [buy] ordered | Thickens it for brush-on layers that stay put on the mold's walls. |
| Smooth-On Silc Pig pigments | 1 set | [buy] ordered | Colour mixed into the silicone. |
| Smooth-On Slacker | optional | [buy] if needed | Makes the cured skin softer and more flesh-like; only if the bench tests show the servos struggling (PLAN R11). Use the same mix for the M4 pads. |
| Smooth-On Sil-Poxy | 0.5 oz | [buy] in cart | Bonds cured silicone to cured silicone (re-attaching a pad). |
| Sulfur-free clay; no latex | | | Sulfur clay and latex both stop platinum silicone from curing. |

## Skin attachment (M4, not designed yet)

| Item | Qty | Notes |
|---|---|---|
| 7 mm sew-on snap, both halves | 4 for the brows (+ the lips, M4) | Which product (Q8)? Caliper both halves before M4 starts. |

## Enclosure (M8, v1 of 2026-10-29; PLAN D23–D26, D30, D31)

The power box and the boards in the base are in the Head Power Wiring doc (claude.ai, 2026-10-26); this lists what the enclosure adds.

| Item | Qty | Status | Notes |
|---|---|---|---|
| Clear PETG sheet, 1 mm (0.040 in), 1000 × 500 mm | 1 | [buy] | the window (892 × 477, a full tube, the back see-through). Not acrylic: it cracks at this bend. The base's band is printed now (D31), so the second sheet is gone. |
| Black spray paint for plastic | 1 can | [optional] | the printed band, only if it is not printed in black or dark grey |
| M3 × 8 socket head screws + M3 nuts | 28 + 30 | [buy] | band to the bottom rims 4 (the rims' holes at the front and back are behind the openings), band seams 4, ring seam walls 4, cap seam 4, panels 8 (all with nuts; nuts also for the six below); the bottom rings' ears 4 (self-tapping into the tray's bosses, no nut). The pedestal's four flange screws are not used: they sit under its solid top plate, out of reach (2026-10-30); it is glued instead |
| Hot glue or super glue gel | a little | [confirm] | the pedestal's foot to the tray's four radial ribs (ASSEMBLY step 5); or weld it with the soldering iron and a piece of PLA filament |
| 3 mm hex driver, 150 mm shaft (or a 3 mm bit on an extension) | 1 | [confirm] | the neck's four M4 × 12 up through the pedestal's top plate, 138 mm in from its open end |
| M3 × 6 socket head screws | 6 | [buy] | band to the deck's rims, nuts inside. An M3 × 8 there reaches right through the window sheet's place (tip at r 137.9, the sheet at 138.2–139.2) |
| 2.5 mm L hex key | 1 | [confirm] | the band's seam screws: the band's inside is 33 mm from them, too close for a straight driver |
| M4 heat-set insert (M4 × 8) + M4 × 12 socket head bolt | 8 + 8 | [confirm] | 4 in the neck's foot (to the pedestal's top plate) and 4 in the top of the neck's collar (the two clamp plates onto Cogley's frame, D30). The same insert and bolt for both, set with the soldering iron in printed holes; nothing is drilled. Not longer than 12: an M4 × 16 bottoms out in the collar's holes |
| Sony SRS-XB12 | 1 | [have] | in its saddles at the front, aux from the laptop, charged from the bank's USB-A port |
| Logitech 1080p webcam | 1 | [have] | taped under the cap's top, looking out through the window |
| Rubber feet, 20 mm | 4 | [buy] | under the tray |
| Clear tape, foam tape | | [confirm] | the window's overlap; board 1 on the bank; the webcam |
| Standoffs, 25 mm (M3 or nylon) | 4 | [confirm] | board 2 over board 1 (side by side on the bank, their back corners would poke through the band). ASSUMPTION until the boards are measured |
| PLA | about 1.2 kg | [confirm] | 15 prints, about 1010 cm³ of model with thin walls (the band halves about 100 g each): trust the slicer |
