LarsLangenbach/halloween-animatronic/Halloween_Animatronic_Budget.xlsx

Sheet: Budget
Halloween Animatronic — budget
Halloween 2026 build. Totals update from the Purchases tab.
Budget cap ($) |  | ← enter your total budget
Spent: ordered + arrived ($) | $323.66
Still to buy, priced so far ($) | $91.53
Projected total ($) | $415.19
Left in budget ($)
Rows still missing a price | 24
Items still to buy | 16
By category
Category | Spent ($) | To buy ($) | Total ($) | Unpriced rows
Servos | $0.00 | $0.00 | $0.00 | 2
Electronics | $0.00 | $0.00 | $0.00 | 3
Power | $0.00 | $0.00 | $0.00 | 2
Audio | $0.00 | $0.00 | $0.00 | 2
Hardware | $0.00 | $50.69 | $50.69 | 3
Silicone & skin | $58.53 | $30.98 | $89.51 | 4
Mold-making | $63.91 | $0.00 | $63.91 | 1
Sculpting | $0.00 | $0.00 | $0.00 | 1
Finishing | $129.99 | $0.00 | $129.99 | 3
Enclosure | $0.00 | $0.00 | $0.00 | 1
Tools & workshop | $71.23 | $9.86 | $81.09 | 2
Total | $323.66 | $91.53 | $415.19 | 24
How to use: in Purchases, fill the blue cells (Qty, Unit price, Shipping & tax, Link) and set Status. Example row: Qty 2, Unit price 18.99, Shipping & tax 2.47 → Total 40.45.
Rows marked "To buy" are shaded amber; "Arrived" rows are shaded green. Prices are blank until you send the links.

Sheet: Purchases
Halloween Animatronic — purchases
Blue cells are inputs: fill in Unit price, Shipping & tax and Link for each row. Total is calculated. Add new rows inside the table (above row 80).
Category | Item | Qty | Unit price ($) | Shipping & tax ($) | Total ($) | Status | Arrives | Store | Link | Tracker task | Notes
Silicone & skin | Nylon mesh fabric (black) | 1 |  |  |  | Ordered | Thu Oct 15 | Amazon |  | P2: nylon mesh & fabric | Snap-pad reinforcement.
Electronics | Raspberry Pi Pico | 2 |  |  |  | Ordered | Thu Oct 15 | Amazon |  | P2: two Pico H
Hardware | Screw and nut assortment kit | 1 |  |  |  | Ordered | Thu Oct 15 | Amazon |  | P2: screws, bolts, washers, inserts | Check it covers M2/M3/M4. Shoulder bolts are probably separate.
Tools & workshop | Clamp-arm ring light desk lamp | 1 |  |  |  | Ordered | Thu Oct 15 | Amazon
Hardware | Brass heat-set insert assortment | 1 |  |  |  | Ordered | Thu Oct 15 | Amazon |  | P2: screws, bolts, washers, inserts
Silicone & skin | Nylon webbing strap (black) | 1 |  |  |  | Ordered | Thu Oct 15 | Amazon |  | P2: nylon mesh & fabric | Stronger fabric tab for snap Test B.
Finishing | EOVEA shaggy faux fur fabric (grey) | 1 |  |  |  | Ordered |  | Amazon |  | P11: hair (after Halloween) | Arrival date not in the screenshot.
Electronics | Raspberry Pi Pico board with headers (listing 1) | 1 |  |  |  | Ordered | Sat Oct 17 | Amazon
Electronics | Raspberry Pi Pico board with headers (listing 2) | 1 |  |  |  | Ordered | Sat Oct 17 | Amazon
Finishing | Smooth-On Silc Pig pigment set | 1 |  |  |  | Ordered | Sat Oct 17 | Amazon |  | P2: silicone pigments
Servos | MG90S micro servo pack | 2 |  |  |  | Ordered | Sat Oct 17 | Amazon |  | P2: receive & inspect servos | Qty = 2 packs. Put the pack price in Unit price.
Servos | MG996R servo 4-pack | 1 |  |  |  | Ordered | Sat Oct 17 | Amazon |  | P2: receive & inspect servos
Mold-making | Ultracal 30 gypsum cement | 1 |  |  |  | Ordered | Sat Oct 17 | Amazon |  | P2: gypsum mold material | Needed by Oct 23.
Hardware | 7 mm sew-on snaps | 1 |  |  |  | Ordered |  |  |  | P2/P6: sew-on snaps | Ticked as ordered in the tracker; not in the screenshots.
Silicone & skin | Ecoflex 00-30 (or PlatSil Gel-OO30): NOT BUYING | 1 |  |  |  |  |  |  |  | P2: silicone | Replaced by Dragon Skin FX-Pro (row 30), the project's skin silicone from 10/24 (PLAN D21). Status left blank so it drops out of the totals.
Silicone & skin | Mold release, sealer and silicone thickener | 1 |  |  |  | To buy |  |  |  | P2: thickener, sealer, release | Mostly covered: Ease Release 200 (row 31), Cab-O-Sil (37), THI-VEX (40). Still to buy: a SAFE mold sealer (acrylic spray e.g. Krylon Crystal Clear, or petroleum jelly). Not shellac.
Tools & workshop | Mixing cups, sticks, brushes, scale, gloves | 1 |  |  |  | To buy |  |  |  | P2: mixing & mold tools | Needed Sat Oct 17.
Sculpting | Monster Clay, 6 lb | 1 |  |  |  | Arrived |  |  |  | P2: sculpting clay | Bought Oct 15 (Michaels); price not recorded. The face is sculpted in it.
Power | 20 V to 5–6 V buck converter for servos | 1 |  |  |  | To buy |  |  |  | P13: servo regulator | Order by Oct 17. Size from measured current.
Power | Fuse holder, fuses, barrel input jack, switch, wire | 1 |  |  |  | To buy |  |  |  | P13: input connector, fused distribution | Match the ASUS barrel size.
Finishing | Eyeballs (ready-made, or print and paint) | 2 |  |  |  | To buy |  |  |  | P2: eyeballs | About 32 mm diameter to fit EyeMech.
Enclosure | Clear jar, cloche or acrylic cylinder | 1 |  |  |  | To buy |  |  |  | P14: transparent enclosure | Size once head dimensions are set.
Audio | USB microphone | 1 |  |  |  | To buy |  |  |  | P12: microphone
Audio | Speaker and small amplifier | 1 |  |  |  | To buy |  |  |  | P12: speaker & amp
Mold-making | Rigid Wrap plaster bandage w/ header, 8 in | 1 | $11.51 | $0.81 | $12.32 | Arrived | Wed Oct 21 | Blick (Savannah) |  | P8: mold sections | Receipt 10/21, ticket 610. Price after Blick discount; tax is its share of the $4.28.
Silicone & skin | Smooth-On Dragon Skin FX-Pro | 1 | $35.09 | $2.46 | $37.55 | Arrived | Wed Oct 21 | Blick (Savannah) |  | P2: silicone | Receipt 10/21. THE skin silicone for the project (PLAN D21, 10/24): snap coupons and face casts. Replaces the Ecoflex 00-30 row (19).
Mold-making | Smooth-On Ease Release 200 spray, 12 oz | 1 | $14.39 | $1.01 | $15.40 | Arrived | Wed Oct 21 | Blick (Savannah) |  | P2: thickener, sealer, release | Receipt 10/21.
Tools & workshop | Pro Grade 1 in chip brushes, 24-pack | 1 | $11.99 |  | $11.99 | Ordered | Fri Oct 23 | Amazon |  | P2: mixing & mold tools | Cart price, before tax.
Tools & workshop | Pro Grade 3/8 in acid brushes, 36-count | 1 | $6.49 |  | $6.49 | Ordered | Fri Oct 23 | Amazon |  | P2: mixing & mold tools | Cart price, before tax.
Tools & workshop | MAXUS 500 g x 0.01 g pocket scale | 1 | $8.98 |  | $8.98 | Ordered | Fri Oct 23 | Amazon |  | P2: mixing & mold tools | Cart price, before tax.
Mold-making | Zinsser Bulls Eye shellac spray, 12 oz | 1 | $14.96 |  | $14.96 | Ordered | Sat Oct 24 | Amazon |  | P8: seal mold | DO NOT USE ON THE MOLD: Smooth-On says shellac makes silicone bond (10/24). Delayed to Mon 10/26; cancel or return.
Tools & workshop | 3M Aura 9205+ N95 respirator, 3-pack | 1 | $9.97 |  | $9.97 | Ordered | Fri Oct 23 | Amazon |  | P8: mold sections | For mixing Ultracal (silica). Cart price, before tax.
Silicone & skin | Cab-O-Sil fumed silica thickener, 1 qt | 1 | $12.99 |  | $12.99 | Ordered | Fri Oct 23 | Amazon |  | P2: thickener, sealer, release | Cart price, before tax.
Tools & workshop | MedPride nitrile gloves, medium, 100 | 1 | $9.99 |  | $9.99 | Ordered | Fri Oct 23 | Amazon |  | P2: mixing & mold tools | Cart price, before tax.
Finishing | Master Airbrush Cool Runner II airbrush kit | 1 | $129.99 |  | $129.99 | Ordered | Fri Oct 23 | Amazon |  | P11: skin painting | Cart price, before tax.
Silicone & skin | Smooth-On THI-VEX silicone thickener, 1 oz | 1 | $7.99 |  | $7.99 | Ordered | Mon Oct 26 | Amazon |  | P2: thickener, sealer, release | Cart price, before tax.
Tools & workshop | #11 scalpel handle + 20 blades | 1 | $6.89 |  | $6.89 | Ordered | Fri Oct 23 | Amazon |  | P9: trim flashing | Cart price, before tax.
Hardware | OVERTURE TPU 95A filament, 1.75 mm, 1 kg, black | 1 | $23.99 |  | $23.99 | To buy | Sat Oct 24 | Amazon | https://www.amazon.com/dp/B07VDP2S3P | Brow bars (PLAN Q18) | In Amazon cart Oct 23, not ordered yet. Cart price, before tax. External spool on the P2S, not the AMS.
Hardware | Sew-on snaps 5/7/8 mm, silver brass, 72 sets | 2 | $8.90 |  | $17.80 | To buy | Sun Oct 25 | Amazon | https://www.amazon.com/dp/B0DFX6XR74 | P2/P6: sew-on snaps | In Amazon cart Oct 23, not ordered yet. Cart price, before tax. 7 mm default, 8 mm step-up. Showed Sat with qty 1.
Hardware | Sew-on snaps 10 mm, silver brass, 36 sets | 1 | $8.90 |  | $8.90 | To buy | Sun Oct 25 | Amazon | https://www.amazon.com/dp/B0DFX5GZKF | P2/P6: sew-on snaps | In Amazon cart Oct 23, not ordered yet. Cart price, before tax. Chin and fixed skin points.
Silicone & skin | Mandala Crafts bonded nylon thread, Tex 70, cream | 1 | $10.99 |  | $10.99 | To buy | Sat Oct 24 | Amazon | https://www.amazon.com/dp/B00JU6OO8O | P2: nylon mesh & fabric | In Amazon cart Oct 23, not ordered yet. Cart price, before tax. Sewing snaps to the pads.
Tools & workshop | Etekcity digital luggage scale | 1 | $9.86 |  | $9.86 | To buy | Sun Oct 25 | Amazon | https://www.amazon.com/dp/B082LYC2TN |  | In Amazon cart Oct 23, not ordered yet. Cart price, before tax. Snap pull-off and pad tear-out tests.
Silicone & skin | Smooth-On Sil-Poxy silicone adhesive, 0.5 oz | 1 | $19.99 |  | $19.99 | To buy | Sat Oct 24 | Amazon | https://www.amazon.com/dp/B00NGZHGFI |  | In Amazon cart Oct 23, not ordered yet. Cart price, before tax. Re-bonding a pad to cured skin.
Mold-making | Zinsser Bulls Eye clear shellac spray, 12 oz | 1 | $15.79 | $5.44 | $21.23 | Ordered | Sat Oct 24 | Home Depot (DoorDash) |  | P8: seal mold | DO NOT USE ON THE MOLD: Smooth-On says shellac makes silicone bond (10/24). Return if possible. DoorDash order 10/24 3:27 PM, $38.15 total; shipping & tax is this item's share of $9.77.
Tools & workshop | HDX 9 x 12 ft clear plastic drop cloths, 6-pack | 1 | $12.59 | $4.33 | $16.92 | Ordered | Sat Oct 24 | Home Depot (DoorDash) |  | P2: mixing & mold tools | DoorDash order 10/24 3:27 PM, \$38.15 total. Shipping & tax is this item's share of \$9.77 (delivery \$0.49, service \$5.85, tax \$2.43, tip \$1.00).

Sheet: Lists
Categories | Edit this list to add categories; the Purchases dropdown and Budget table use it.
Servos
Electronics
Power
Audio
Hardware
Silicone & skin
Mold-making
Sculpting
Finishing
Enclosure
Tools & workshop
