LarsLangenbach/halloween-animatronic/(list of files, cad)

Other CAD files:
inputs/reference/mouth/MouthAssembly.step
inputs/reference/head_a2.0.33/printing/reference_assembly.obj
inputs/components/adafruit_1143_micro_servo.step
inputs/reference/eyemech/EyeMech_e3.1.step
inputs/reference/head_a2.0.33/printing/BambuPrintfile.3mf
inputs/reference/makehuman/base.obj
output/plates/neck_plate.stl
output/print/enc_band_F.stl
output/print/tonight/enc_top_B.stl
inputs/reference/head_a2.0.33/printing/AllComponents.stl
output/plates/cogley_lids_keyed_plate.stl
output/print/neck_clamp_L.stl
output/print/tonight/enc_bottom_B.stl
output/plates/cogley_lids_plate.stl
output/print/enc_grille.stl
output/print/tonight/enclosure_small_plate.stl
output/plates/enclosure_small_plate.stl
output/print/neck.stl
output/print/tonight/enc_tray.stl
output/plates/mold_plate_top_L.stl
output/print/neck_clamp_R.stl
output/print/tonight/enc_cap_F.stl
output/plates/cogley_brow_bars_tpu_plate.stl
output/print/enc_hatch.stl
output/print/tonight/enc_top_F.stl
output/plates/eyemech_e3.2_MG90s_B_cogley.3mf
output/print/enc_band_B.stl
output/print/tonight/enc_bottom_F.stl
output/plates/cogley_brow_bar_R.stl
output/print/enc_cap_B.stl
output/print/tonight/enc_cap_B.stl
output/plates/eyemech_e3.2_servo_sizing_plate_cogley.3mf
output/print/enc_top_B.stl
output/plates/eyemech_servo_sizing_plate.stl
output/print/enc_tray.stl
output/plates/mold_plate_chin_L.stl
output/print/enc_pedestal.stl
output/plates/cogley_brow_bar_L.stl
output/print/enc_cap_F.stl
output/plates/mold_plate_chin_R.stl
output/print/enc_bottom_F.stl
output/plates/eyemech_B_horn_parts_plate.stl
output/print/enc_bottom_B.stl
output/plates/cogley_eyeball_smooth.stl
output/print/enc_top_F.stl
output/plates/mold_plate_top_R.stl
output/print/mold_base_chin_R.stl
output/plates/eyemech_e3.2_MG90s_A_cogley.3mf
output/print/mold_wall_chin_R.stl
output/plates/eyemech_e3.2_MG90s_A_plate.stl
output/print/mold_base_top_R.stl
output/plates/eyebrows_plate.stl
output/print/mold_base_top_L.stl
output/print/mold_wall_chin_L.stl
output/print/mold_base_chin_L.stl
output/print/mold_pry_wedge.stl
output/print/mold_wall_top_L.stl
output/print/mold_wall_top_R.stl
output/print/face_mask.stl
output/print/sculpt_upper.stl
output/print/sculpt_plate.stl
output/print/sculpt_lower.stl
output/print/skull_front_upper.stl
output/print/skull_back_lower.stl
output/print/skull_back_upper.stl
output/print/skull_eye_strap.stl
output/print/skull_shelf.stl
output/print/skull_access_panel.stl
output/print/skull_front_lower.stl
output/print/skull_neck_plate.stl
output/print/brow_carrier_L.stl
output/print/brow_carrier_R.stl
output/print/brow_bracket_R.stl
output/print/test_coupon.stl
output/print/brow_bracket_L.stl
output/print/brow_rig.stl
output/stl/brow_bracket_L.stl
output/stl/brow_bracket_R.stl
output/stl/brow_carrier_L.stl
output/stl/brow_carrier_R.stl
output/stl/brow_rig.stl
output/stl/enc_band_B.stl
output/stl/enc_band_F.stl
output/stl/enc_bottom_B.stl
output/stl/enc_bottom_F.stl
output/stl/enc_cap_B.stl
output/stl/enc_cap_F.stl
output/stl/enc_grille.stl
output/stl/enc_hatch.stl
output/stl/enc_pedestal.stl
output/stl/enc_top_B.stl
output/stl/enc_top_F.stl
output/stl/enc_tray.stl
output/stl/face_mask.stl
output/stl/mold_base_chin_L.stl
output/stl/mold_base_chin_R.stl
output/stl/mold_base_top_L.stl
output/stl/mold_base_top_R.stl
output/stl/mold_pry_wedge.stl
output/stl/mold_wall_chin_L.stl
output/stl/mold_wall_chin_R.stl
output/stl/mold_wall_top_L.stl
output/stl/mold_wall_top_R.stl
output/stl/neck.stl
output/stl/neck_clamp_L.stl
output/stl/neck_clamp_R.stl
output/stl/sculpt_lower.stl
output/stl/sculpt_plate.stl
output/stl/sculpt_upper.stl
output/stl/skull_access_panel.stl
output/stl/skull_back_lower.stl
output/stl/skull_back_upper.stl
output/stl/skull_eye_strap.stl
output/stl/skull_front_lower.stl
output/stl/skull_front_upper.stl
output/stl/skull_neck_plate.stl
output/stl/skull_shelf.stl
output/stl/test_coupon.stl
