LarsLangenbach/halloween-animatronic/process_images/2026-10-29_53_band-printed/skull.md

# M3 skull check

Head scale 1.2. Gaps in mm, overlaps in mm3.

## At rest

| piece | closest module part | closest brow part | overlaps |
|---|---|---|---|
| skull_front_upper | 1.2 (eyemech SnapEyemech_v20) | 1.5 (carrier_R) | none |
| skull_front_lower | 1.5 (eyemech Base) | inf () | none |
| skull_back_upper | 1.9 (eyemech SnapEyemech_v20) | 28.5 (bracket_R) | none |
| skull_back_lower | 1.9 (mouth Part_33) | inf () | none |
| skull_shelf | 1.0 (mouth TopBase) | inf () | none |
| skull_eye_strap | 0.4 (eyemech SnapEyemech_v20) | inf () | none |
| skull_neck_plate | inf () | inf () | none |
| skull_access_panel | inf () | inf () | none |

## Moving parts

| sweep | closest skull piece | gap | points inside a piece |
|---|---|---|---|
| jaw 0..25 deg | skull_back_lower | 1.9 | 0 |
| lids | skull_front_upper | 2.5 | 0 |
| eyes | skull_front_upper | 5.8 | 0 |
| brow carriers (with overtravel) | skull_front_upper | 1.4 | 0 |

Renders: skull.png (and skull_1..6.png)

## Issues

none
