LarsLangenbach/halloween-animatronic/output/manual/enclosure/s1_01_lead_door.png

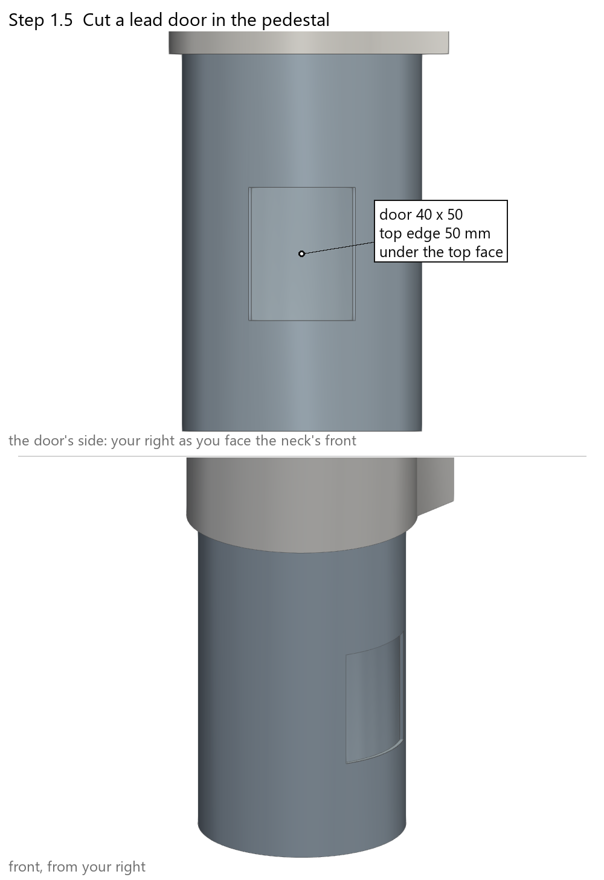
output/manual/enclosure/s1_01_lead_door.png
