LarsLangenbach/halloween-animatronic/output/manual/enclosure/s1_02_foot_inserts.png

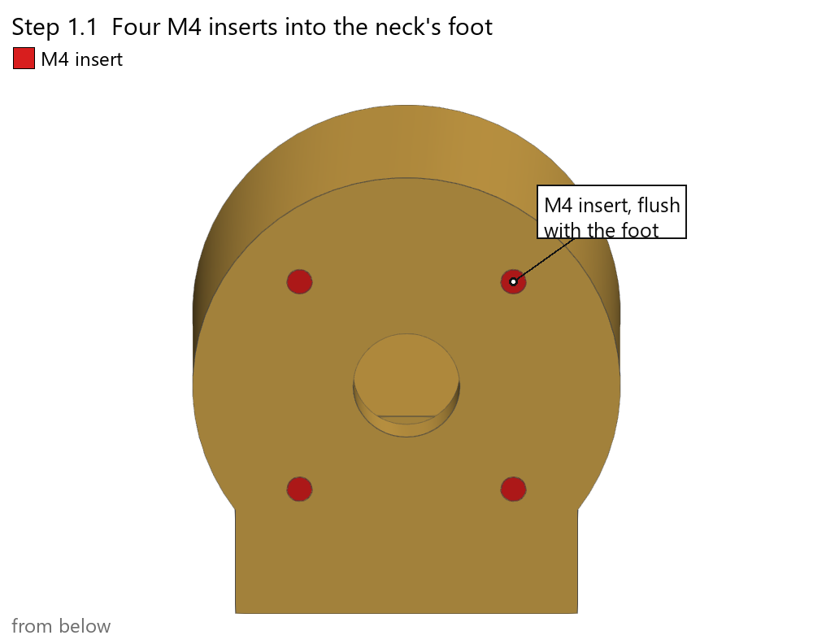
output/manual/enclosure/s1_02_foot_inserts.png
