LarsLangenbach/halloween-animatronic/output/manual/enclosure/s1_03_collar_inserts.png

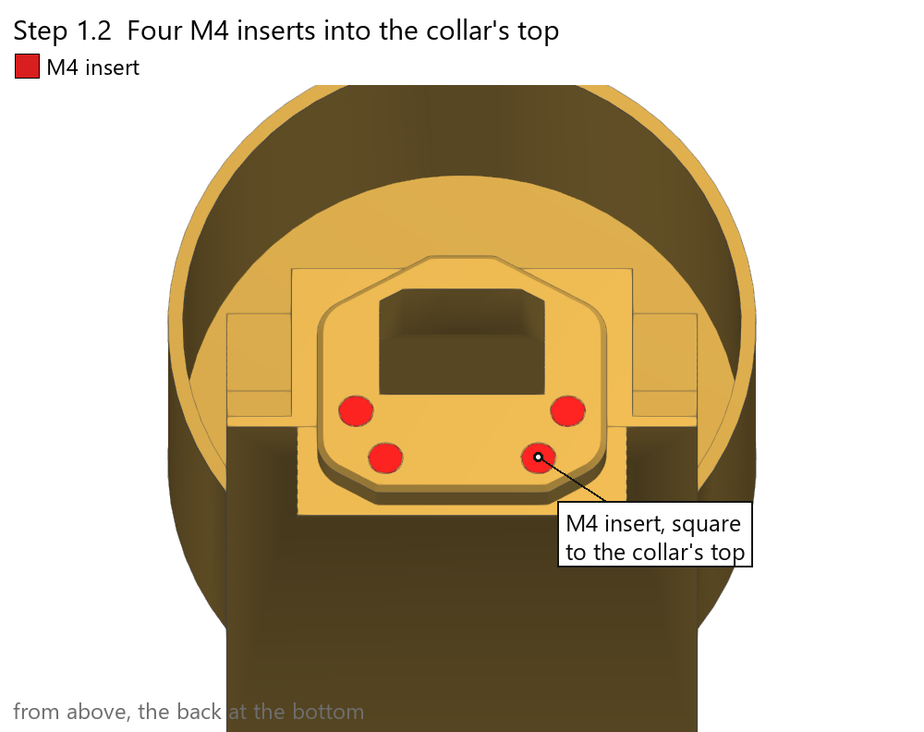
output/manual/enclosure/s1_03_collar_inserts.png
