LarsLangenbach/halloween-animatronic/output/manual/enclosure/s1_04_neck_on_pedestal.png

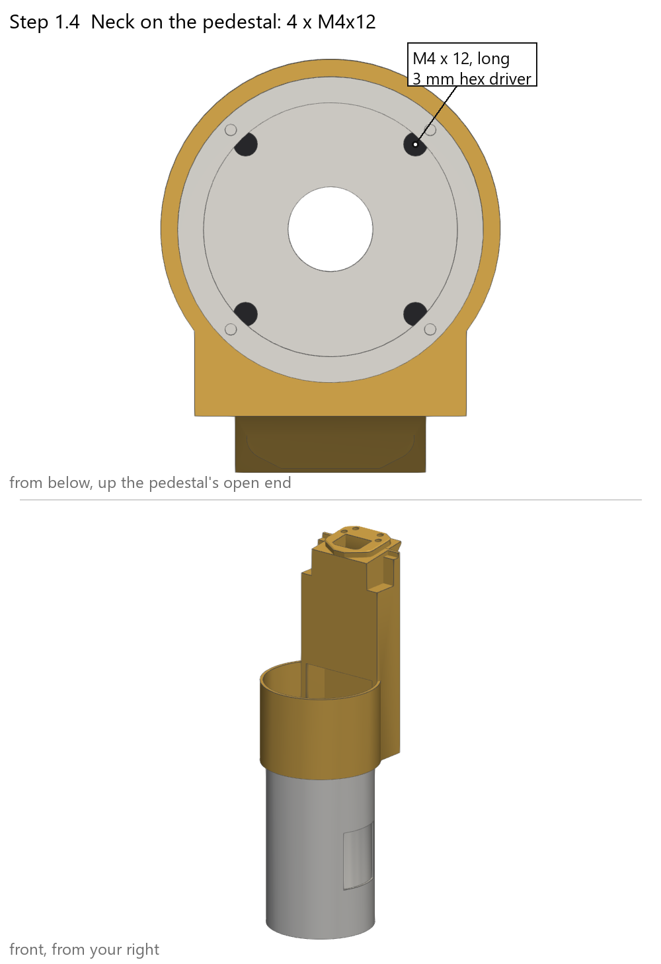
output/manual/enclosure/s1_04_neck_on_pedestal.png
