LarsLangenbach/halloween-animatronic/output/manual/enclosure/s2_01_feet.png

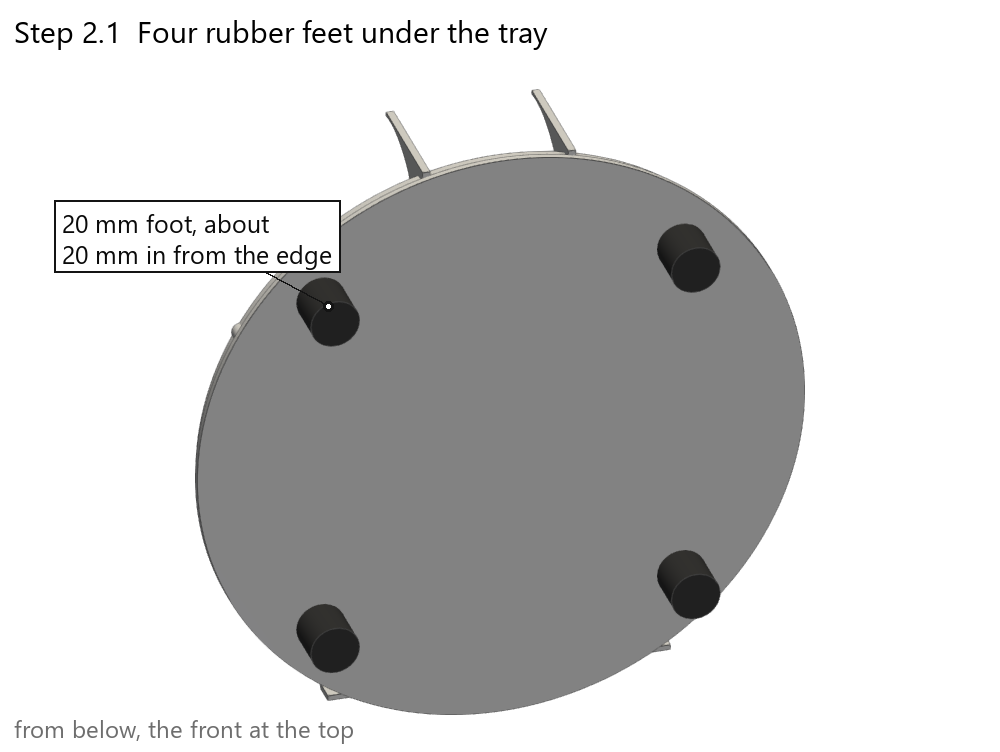
output/manual/enclosure/s2_01_feet.png
