LarsLangenbach/halloween-animatronic/output/manual/enclosure/s2_02_pedestal_on_tray.png

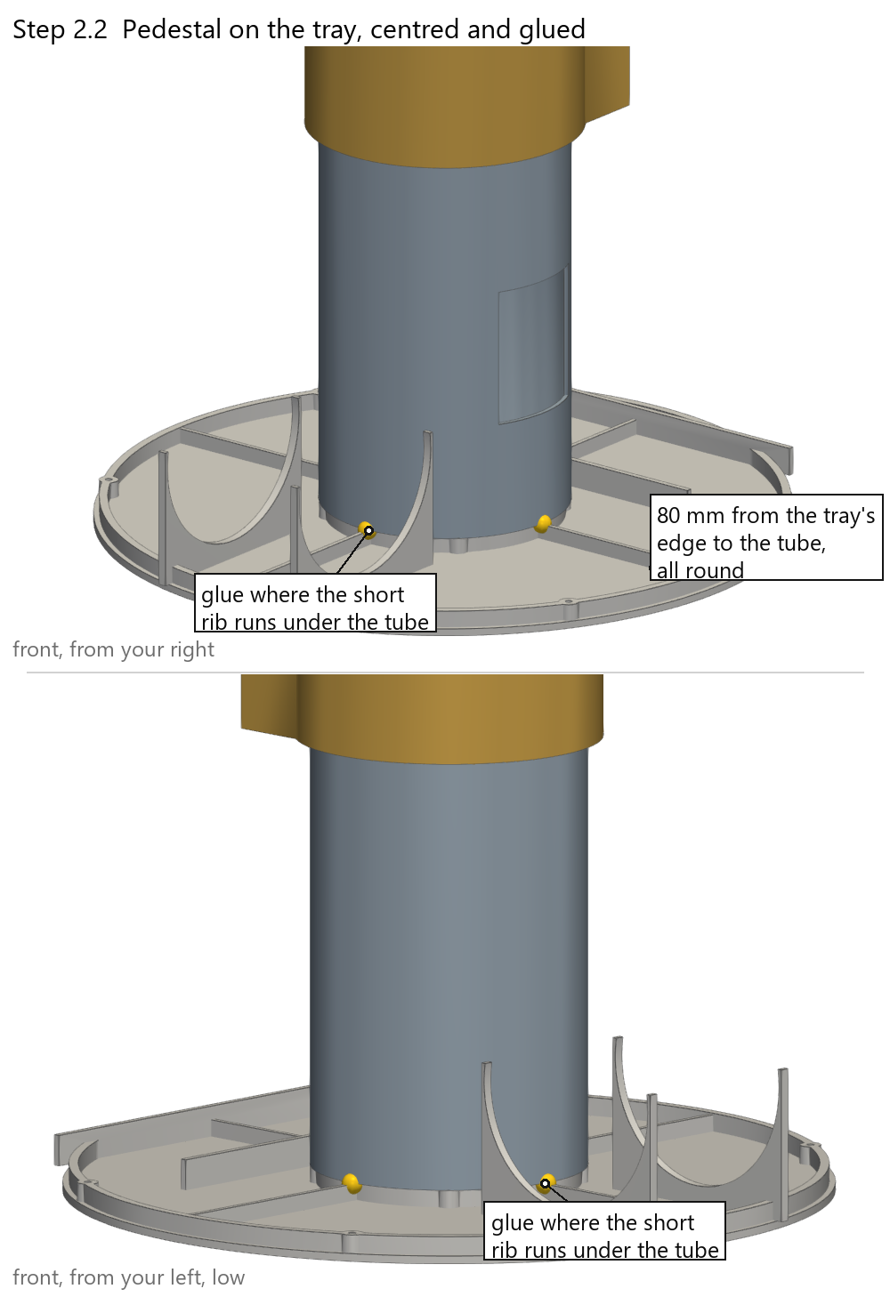
output/manual/enclosure/s2_02_pedestal_on_tray.png
