LarsLangenbach/halloween-animatronic/output/manual/enclosure/s2_03_bottom_rings.png

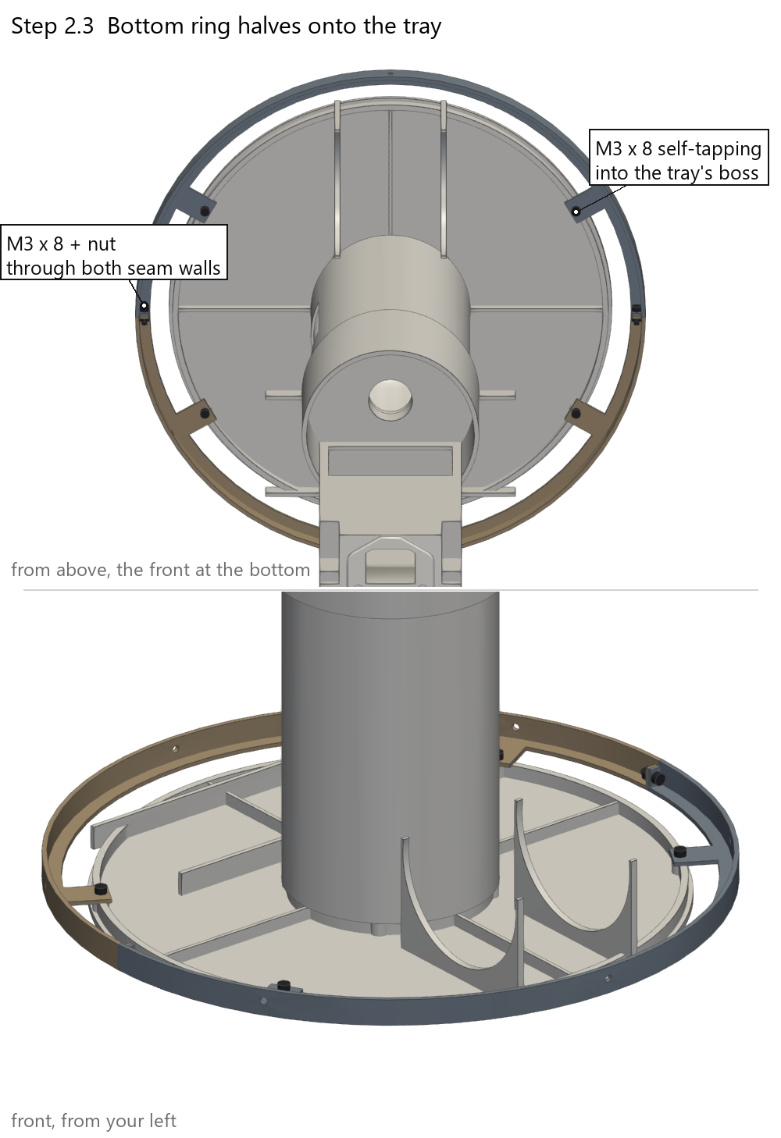
output/manual/enclosure/s2_03_bottom_rings.png
