LarsLangenbach/halloween-animatronic/output/manual/enclosure/s2_04_band.png

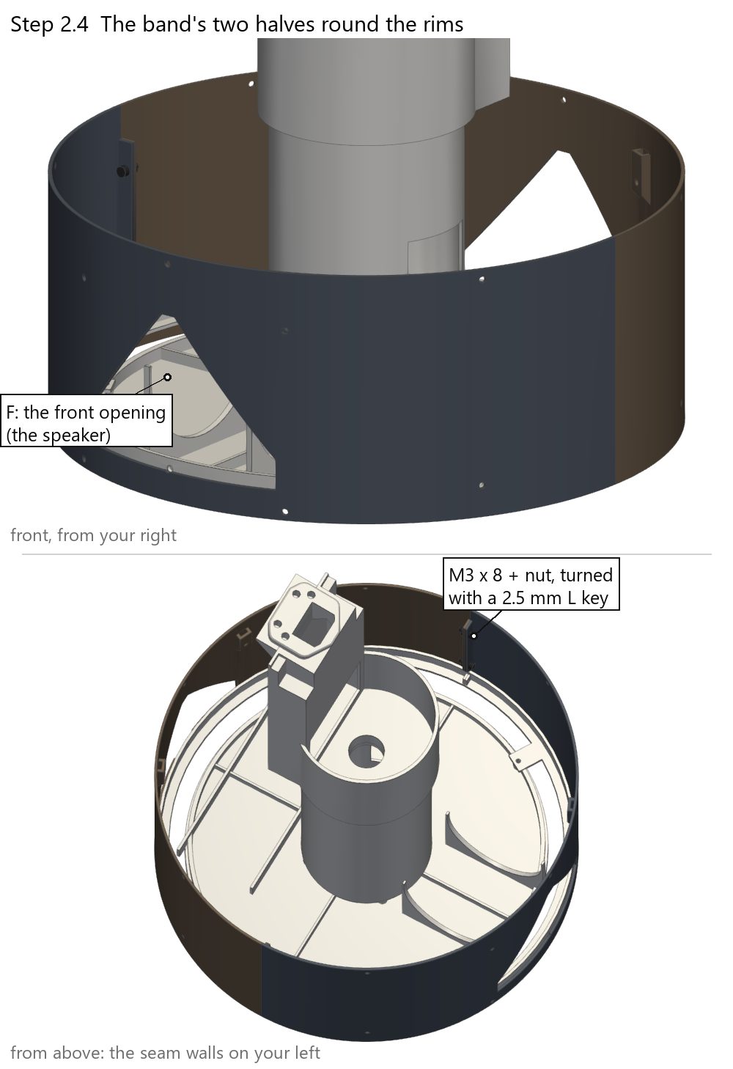
output/manual/enclosure/s2_04_band.png
