LarsLangenbach/halloween-animatronic/output/manual/enclosure/s2_05_band_screws.png

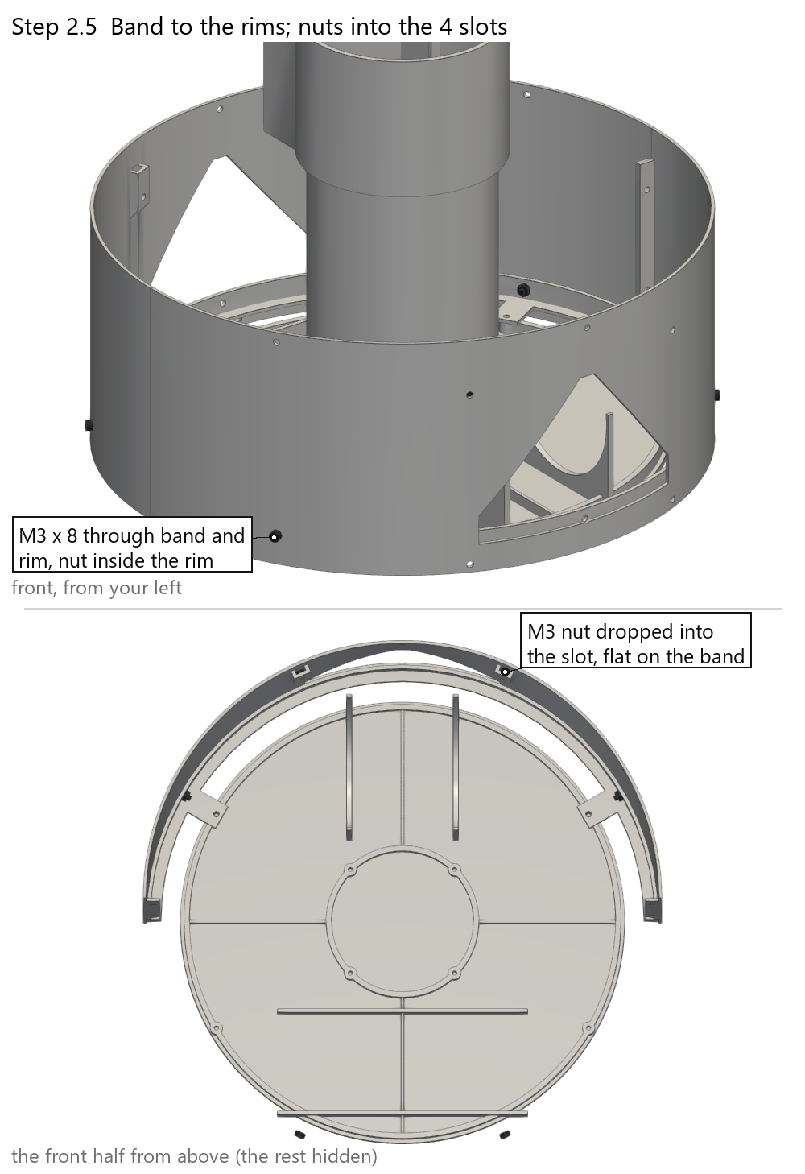
output/manual/enclosure/s2_05_band_screws.png
