LarsLangenbach/halloween-animatronic/output/manual/enclosure/s2_06_grille.png

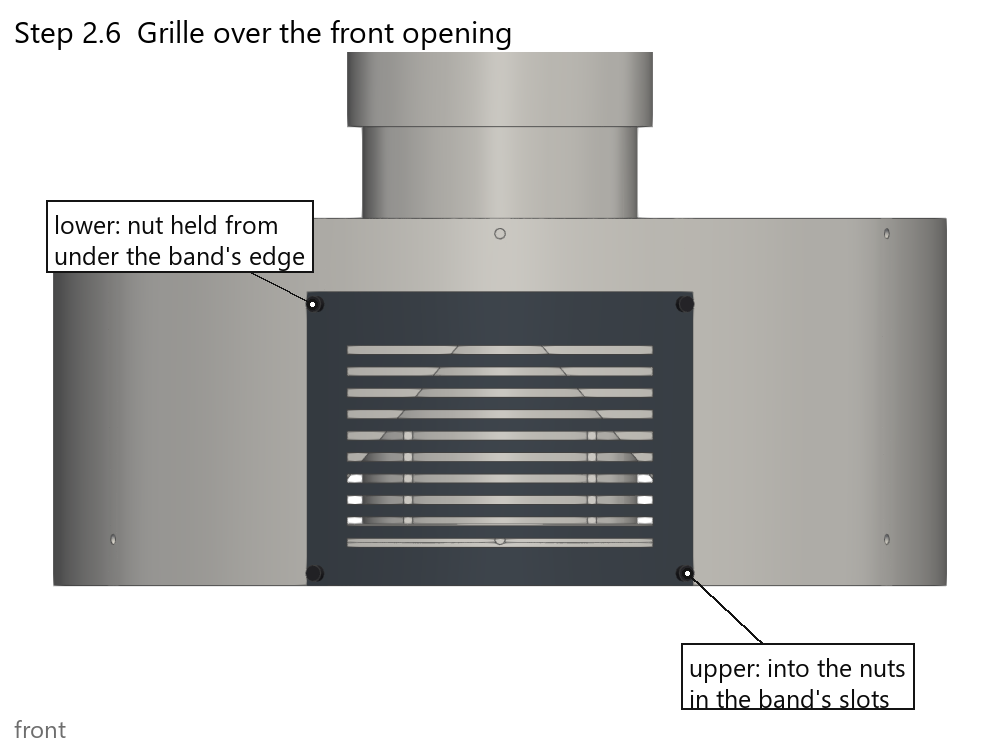
output/manual/enclosure/s2_06_grille.png
