LarsLangenbach/halloween-animatronic/output/manual/enclosure/s3_01_bay.png

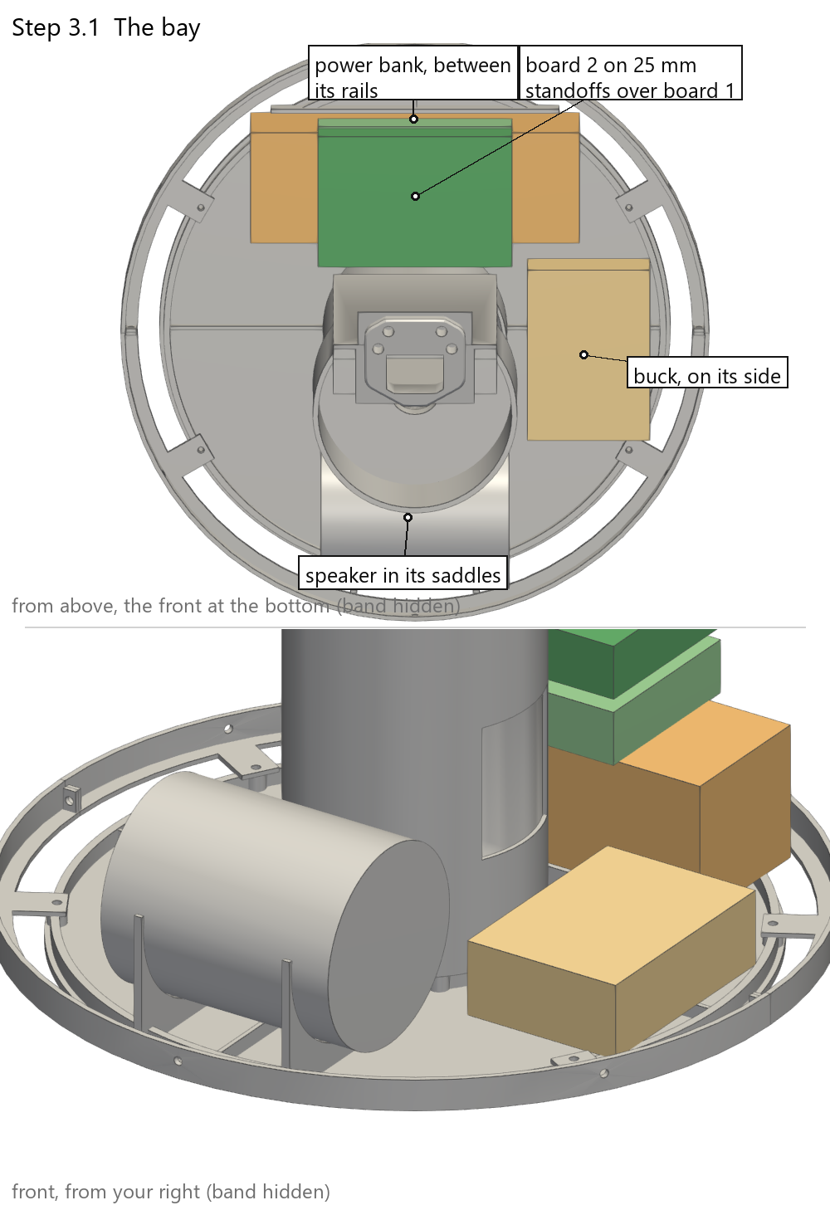
output/manual/enclosure/s3_01_bay.png
