LarsLangenbach/halloween-animatronic/output/manual/enclosure/s4_01_head_on_neck.png

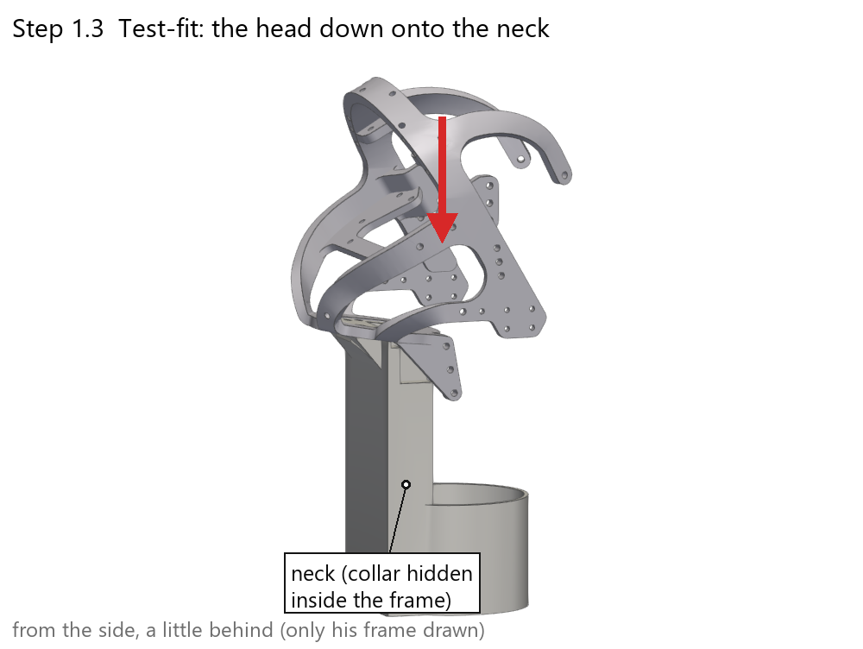
output/manual/enclosure/s4_01_head_on_neck.png
