LarsLangenbach/halloween-animatronic/output/manual/enclosure/s4_02_clamp_plates.png

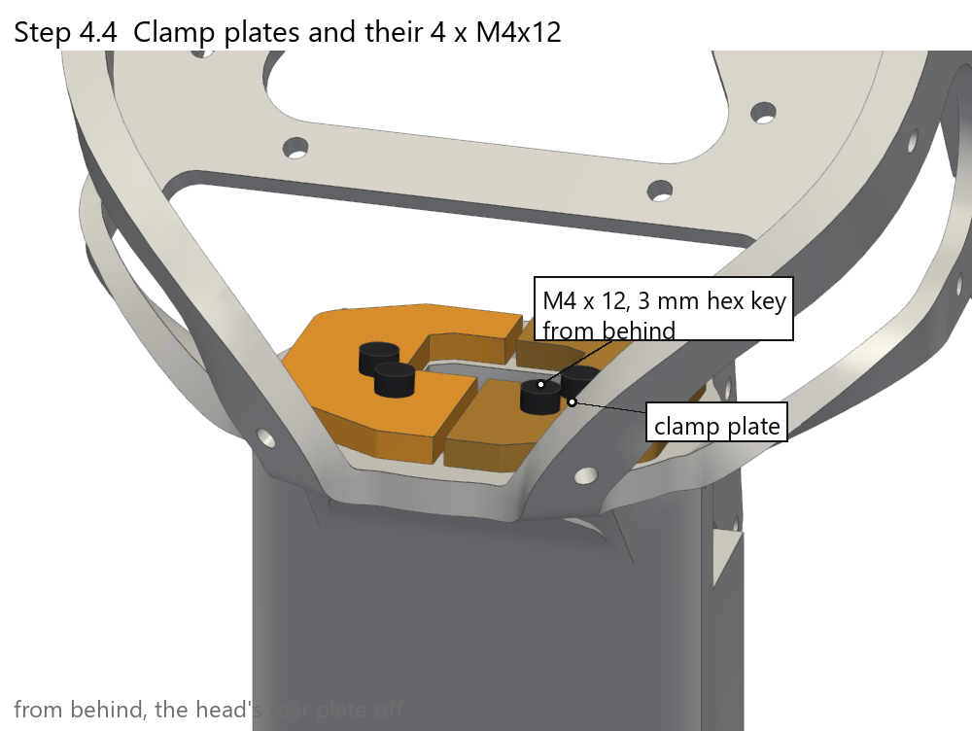
output/manual/enclosure/s4_02_clamp_plates.png
