LarsLangenbach/halloween-animatronic/output/manual/enclosure/s5_01_deck.png

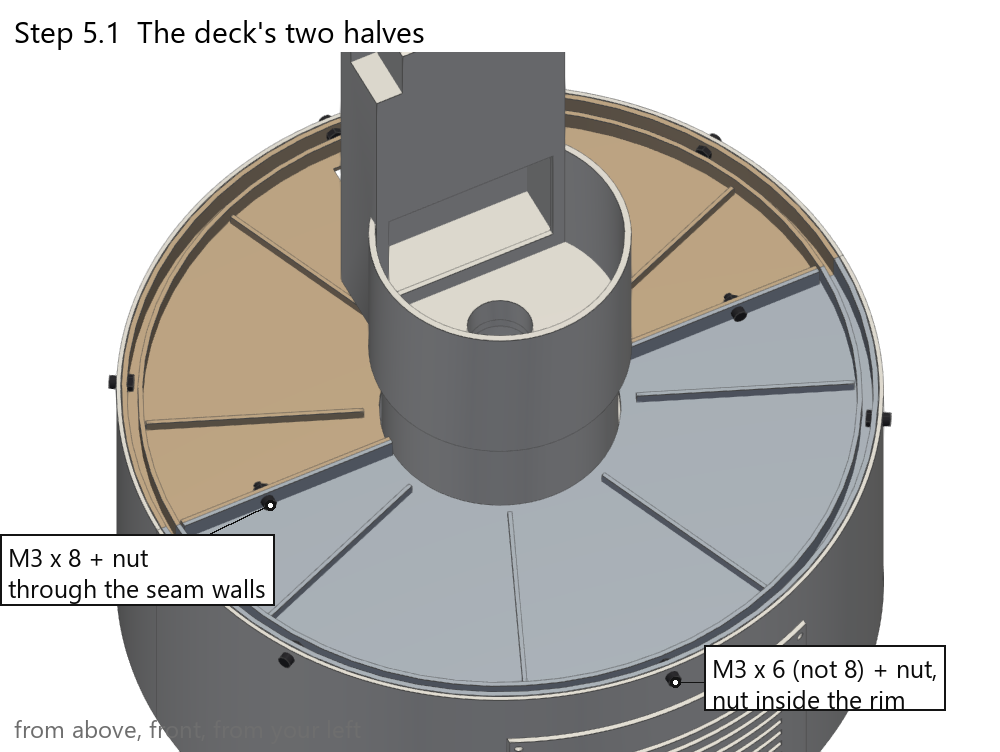
output/manual/enclosure/s5_01_deck.png
