LarsLangenbach/halloween-animatronic/output/manual/enclosure/s6_01_window.png

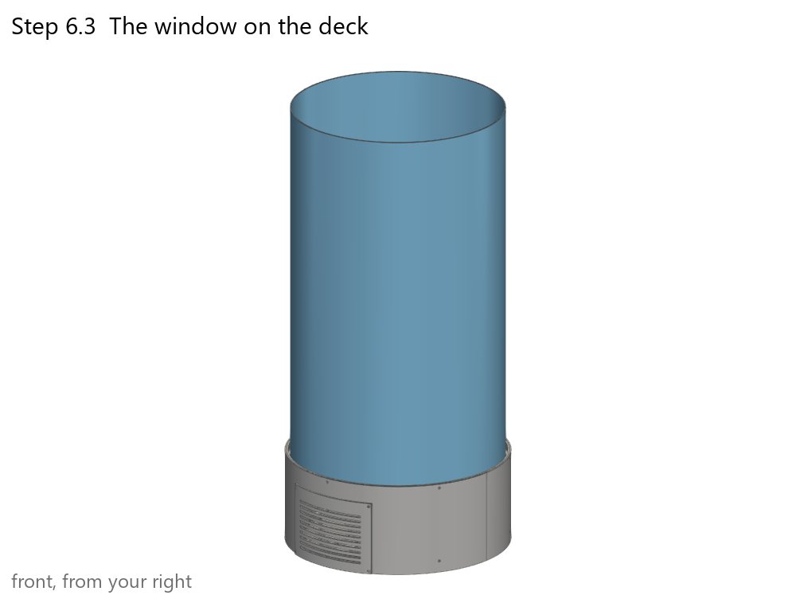
output/manual/enclosure/s6_01_window.png
