LarsLangenbach/halloween-animatronic/output/manual/enclosure/s6_02_cap.png

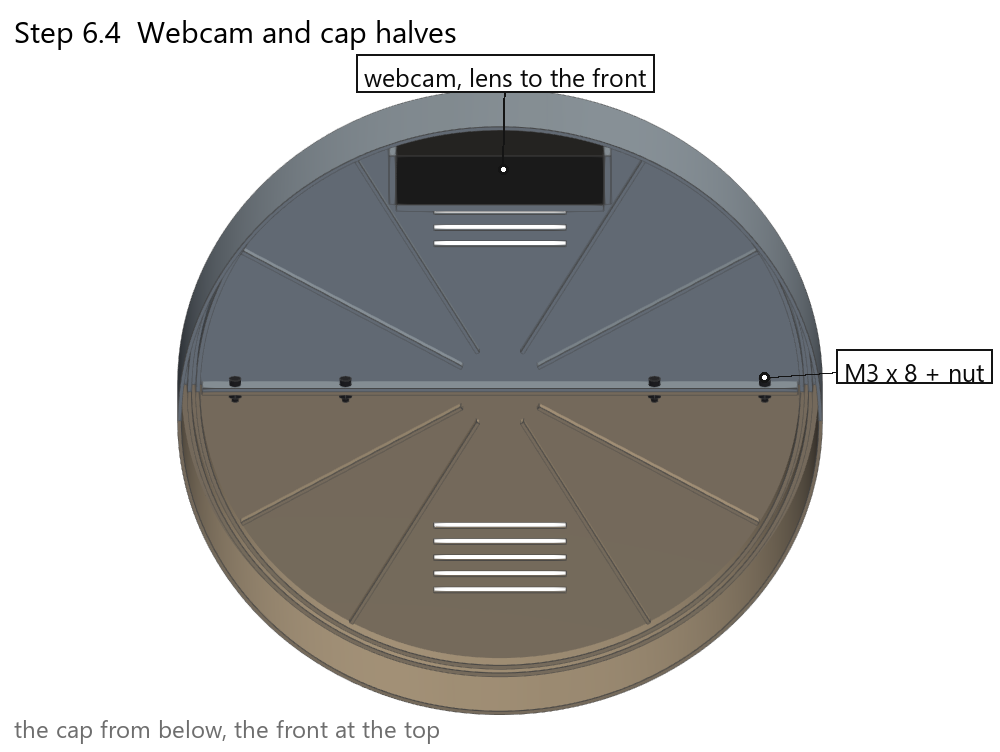
output/manual/enclosure/s6_02_cap.png
