LarsLangenbach/halloween-animatronic/output/manual/enclosure/s6_03_complete.png

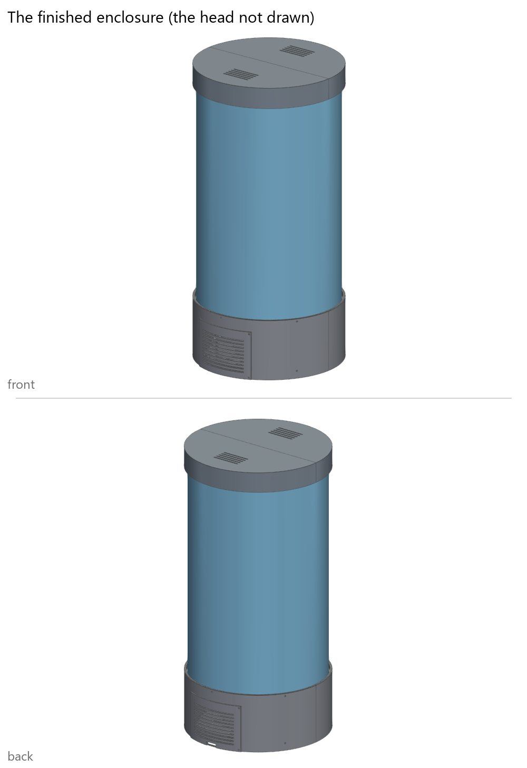
output/manual/enclosure/s6_03_complete.png
