LarsLangenbach/halloween-animatronic/output/manual/s1_01_top_plate.png

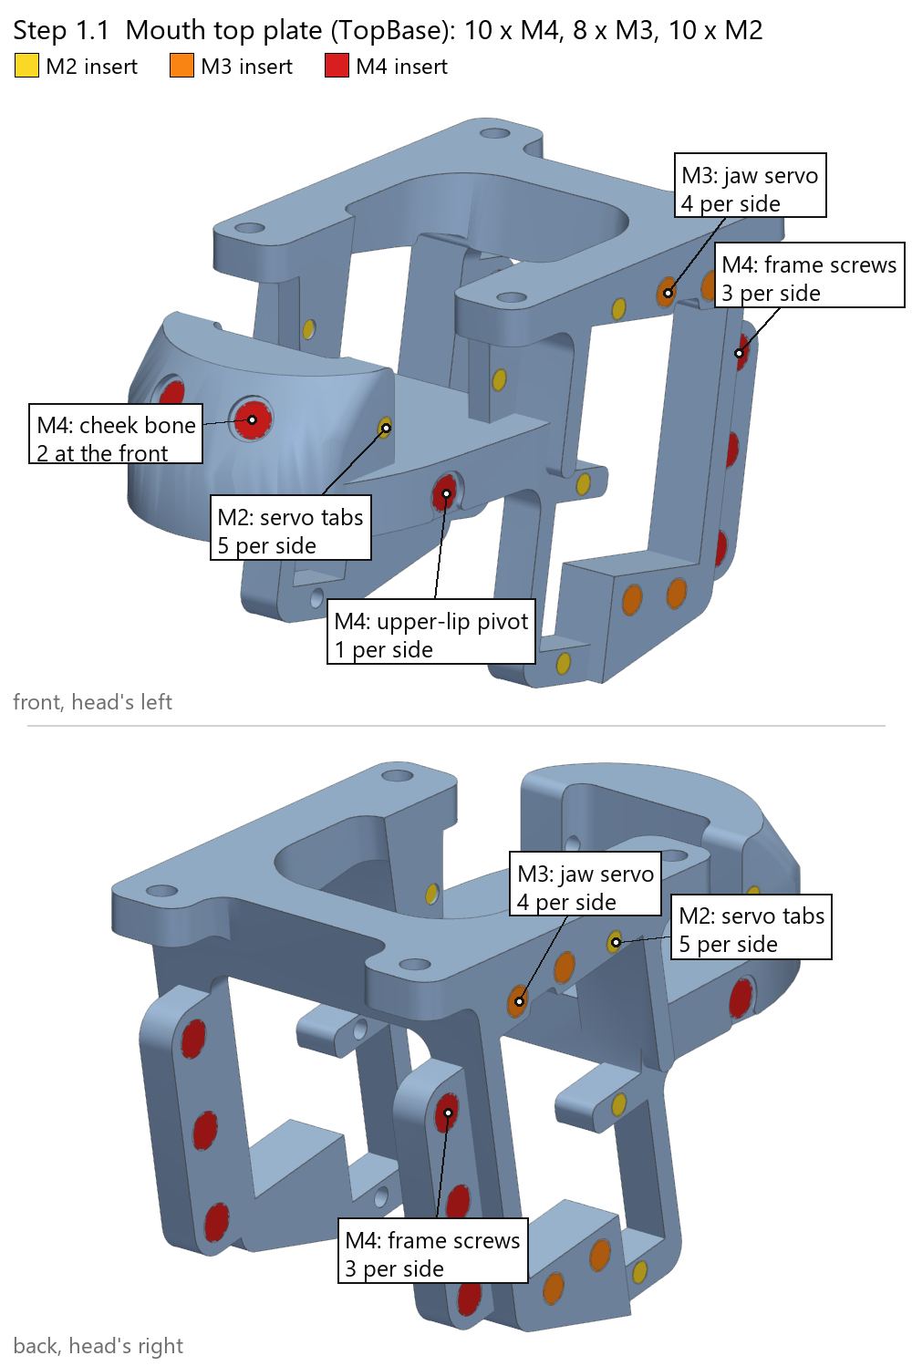
output/manual/s1_01_top_plate.png
