LarsLangenbach/halloween-animatronic/output/manual/s1_02_jaw_base.png

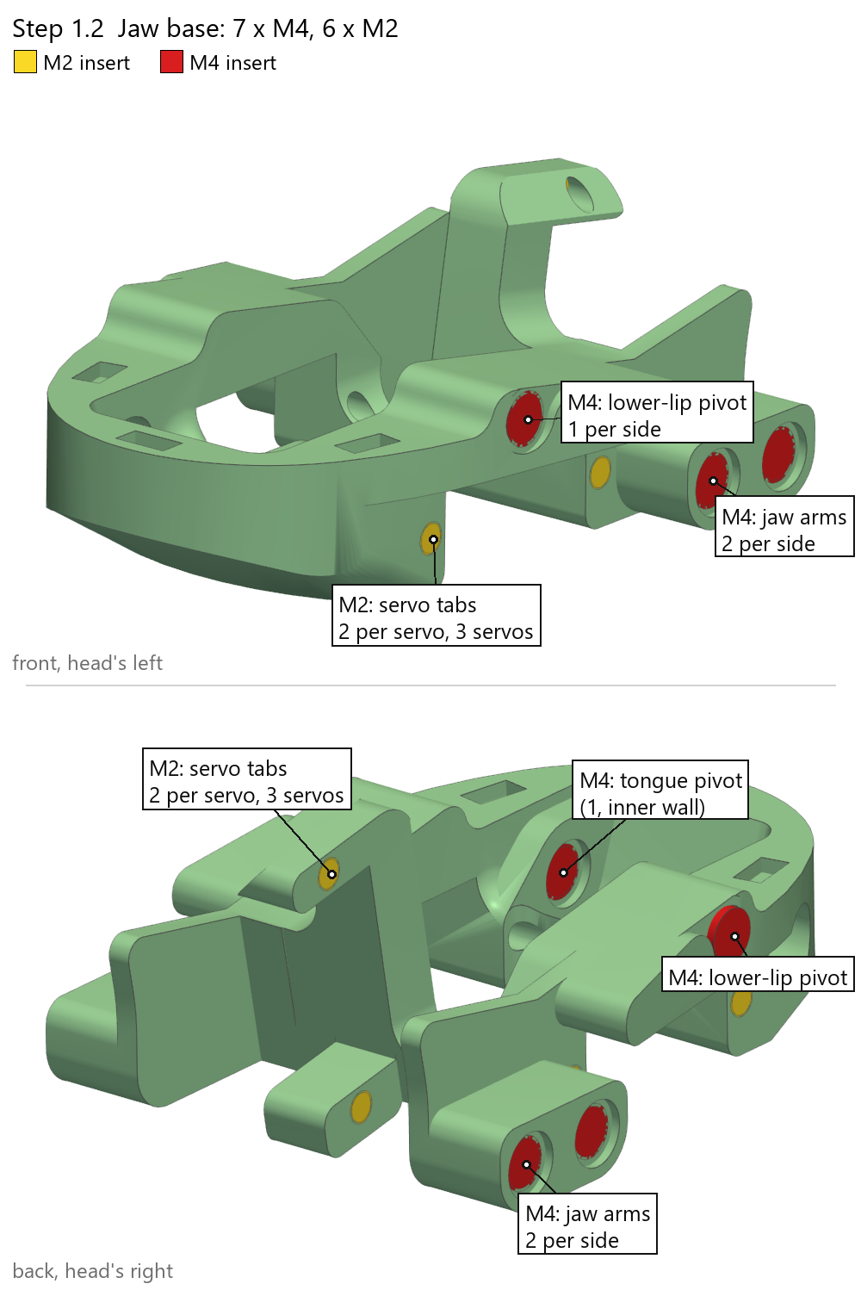
output/manual/s1_02_jaw_base.png
