LarsLangenbach/halloween-animatronic/output/manual/s1_03_cheek_bone.png

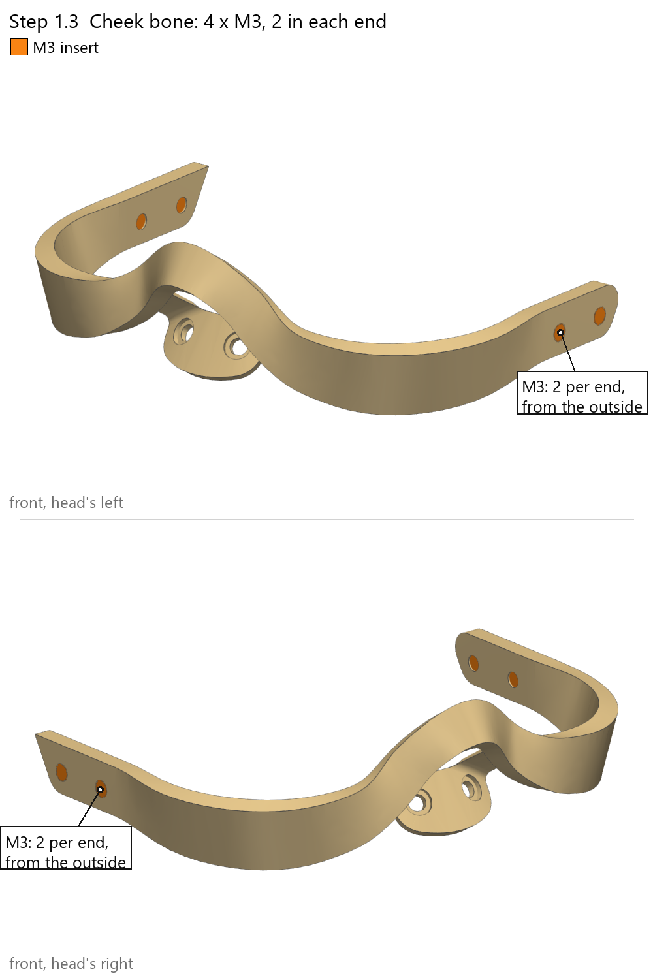
output/manual/s1_03_cheek_bone.png
