LarsLangenbach/halloween-animatronic/output/manual/s1_04_eye_base.png

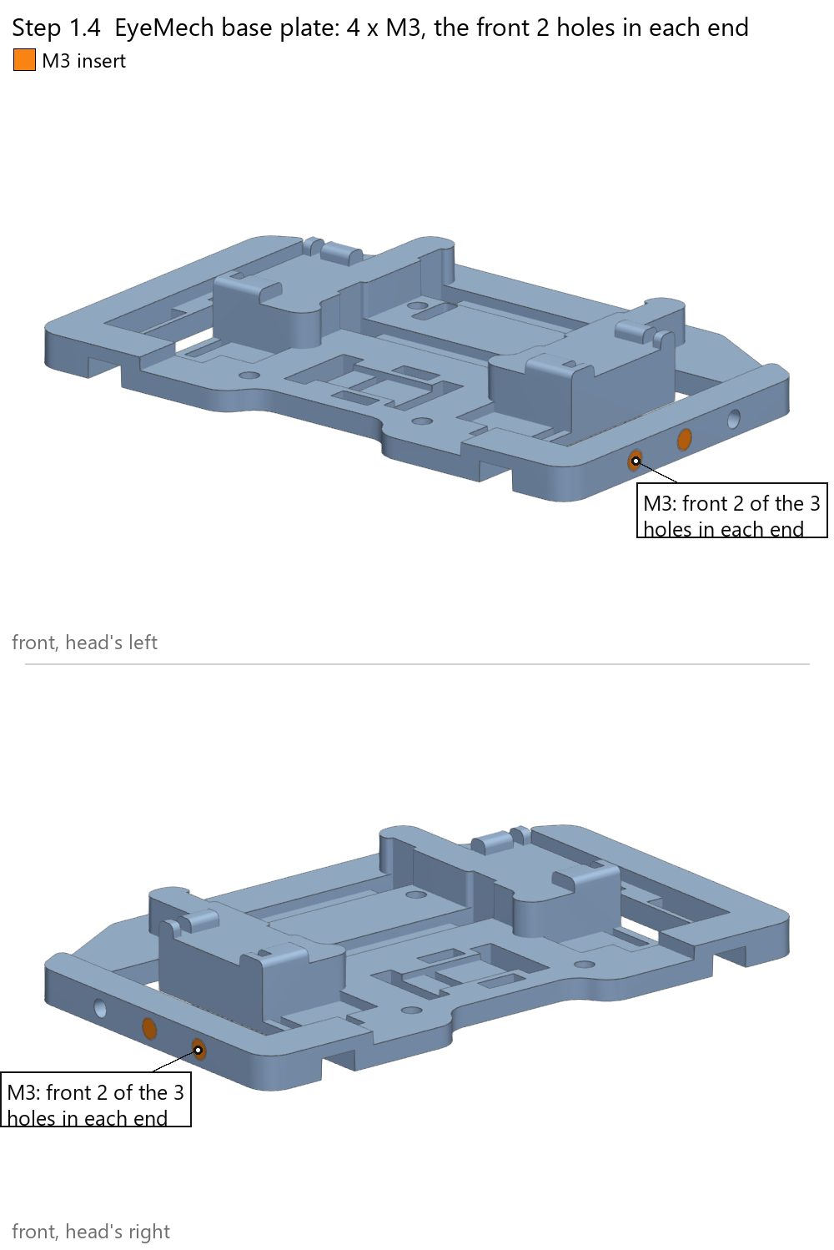
output/manual/s1_04_eye_base.png
