LarsLangenbach/halloween-animatronic/output/manual/s1_05_brow_body.png

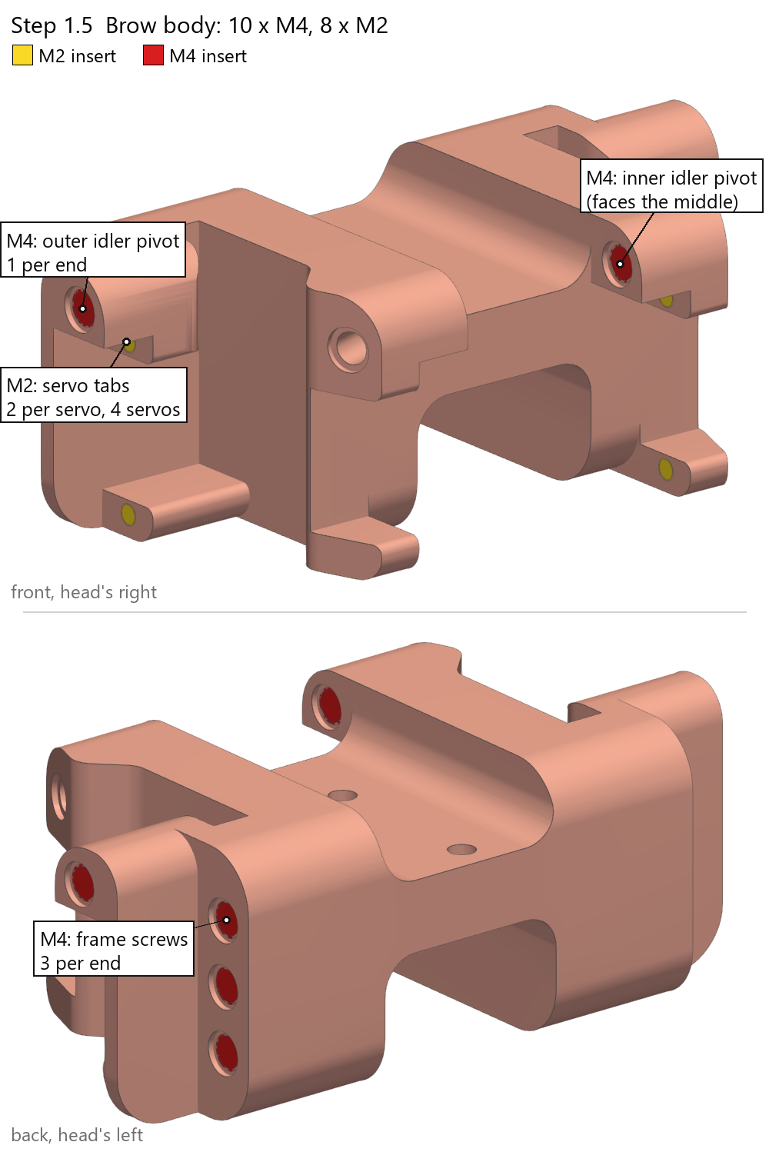
output/manual/s1_05_brow_body.png
