LarsLangenbach/halloween-animatronic/output/manual/s1_06_linkage_brows.png

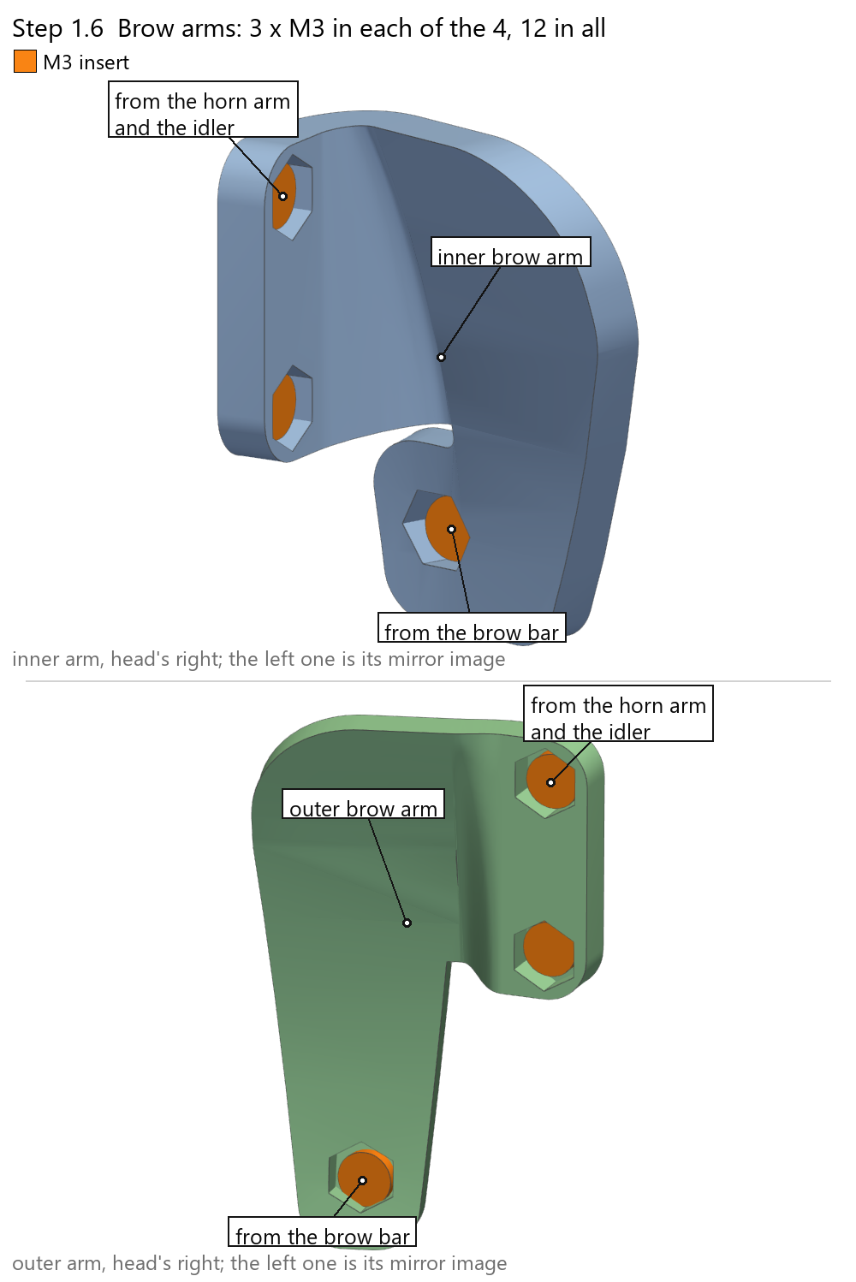
output/manual/s1_06_linkage_brows.png
