LarsLangenbach/halloween-animatronic/output/manual/s1_06_linkage_mouth.png

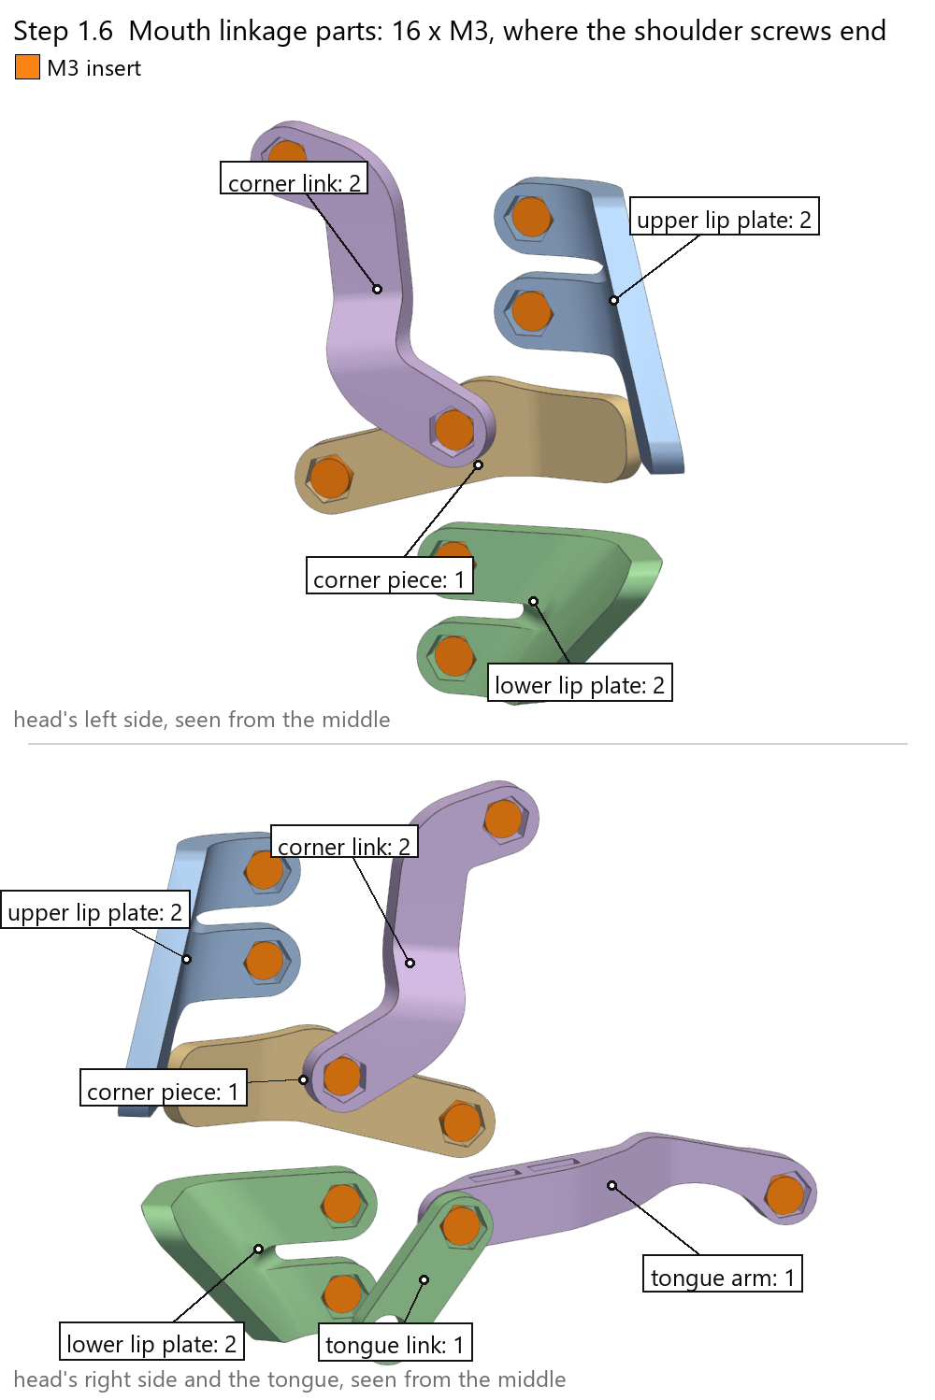
output/manual/s1_06_linkage_mouth.png
