LarsLangenbach/halloween-animatronic/output/manual/s2_02_x_axis_a.png

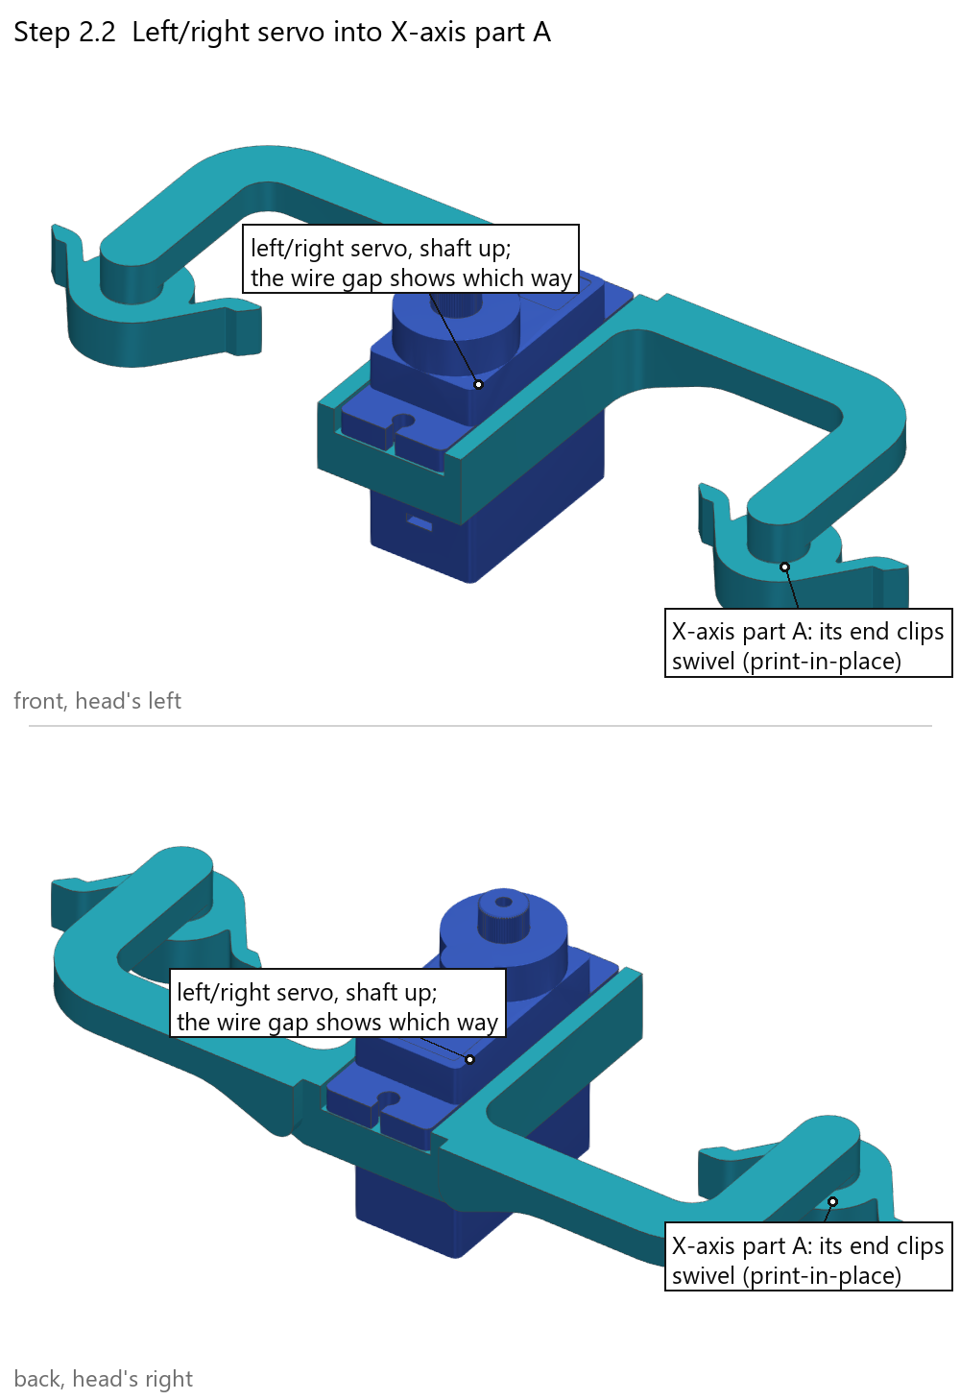
output/manual/s2_02_x_axis_a.png
