LarsLangenbach/halloween-animatronic/output/manual/s2_03_y_axis.png

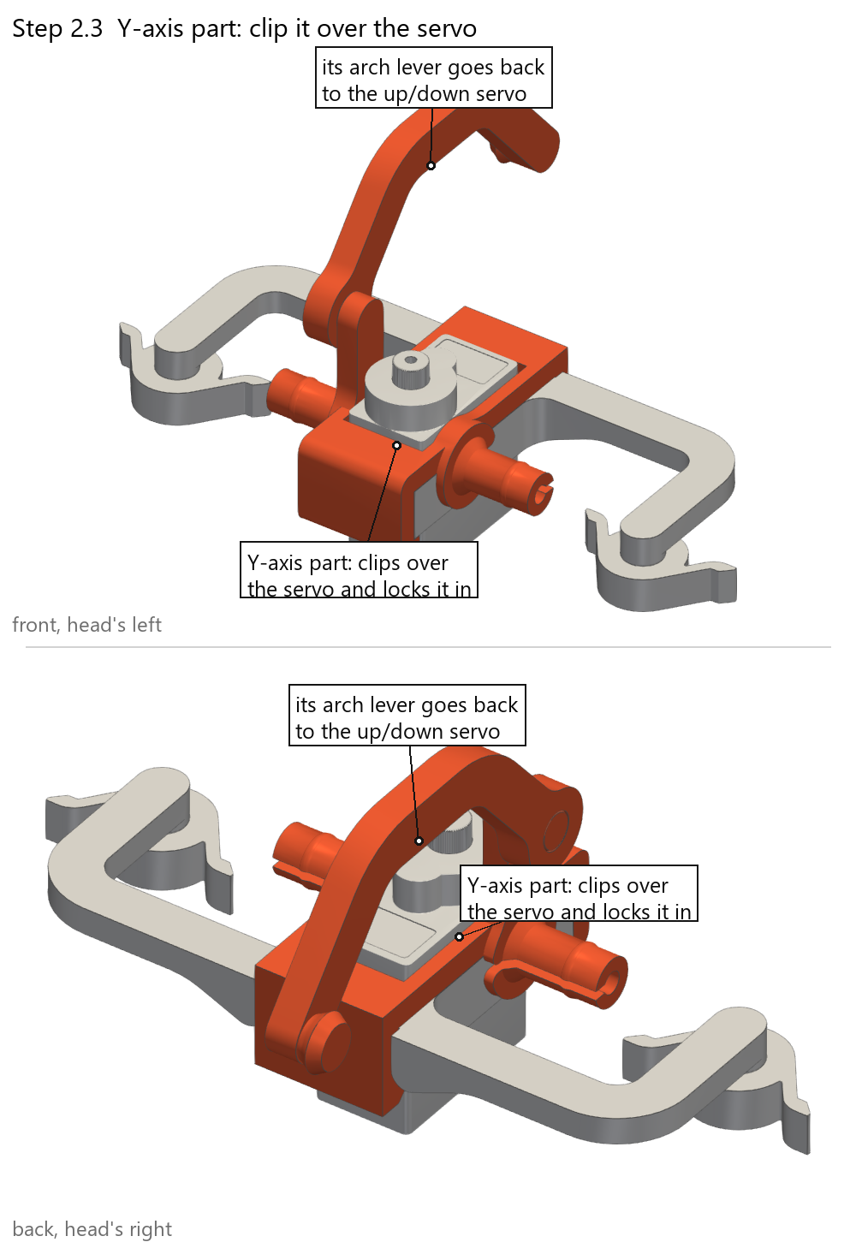
output/manual/s2_03_y_axis.png
