LarsLangenbach/halloween-animatronic/output/manual/s2_04_pivot_holders.png

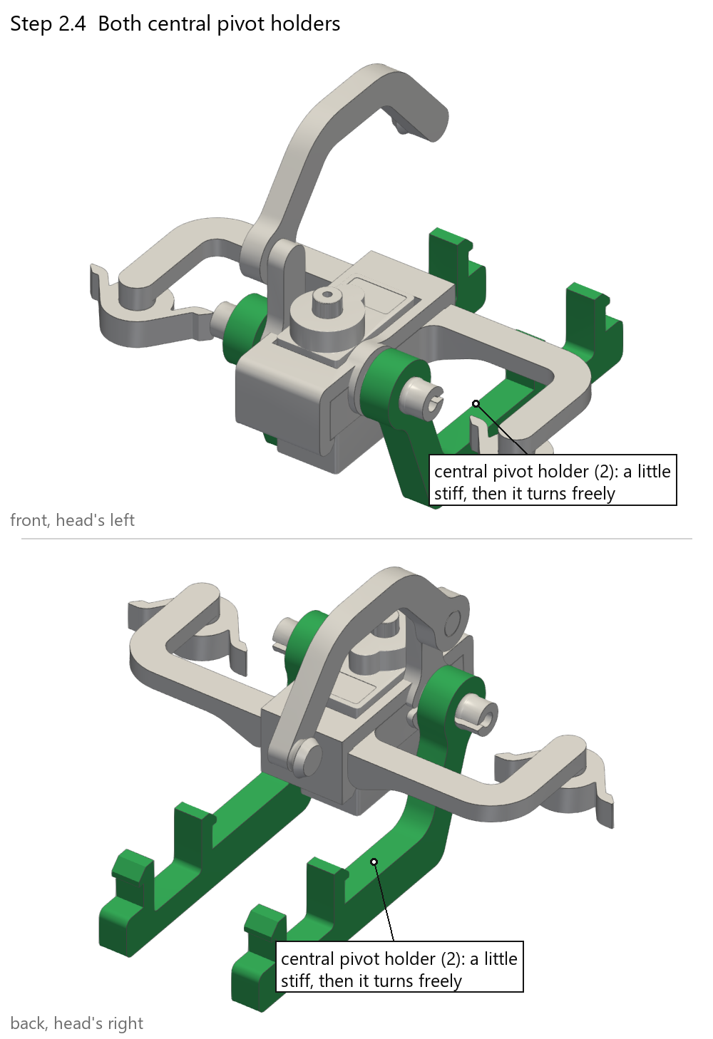
output/manual/s2_04_pivot_holders.png
