LarsLangenbach/halloween-animatronic/output/manual/s2_05_x_axis_b.png

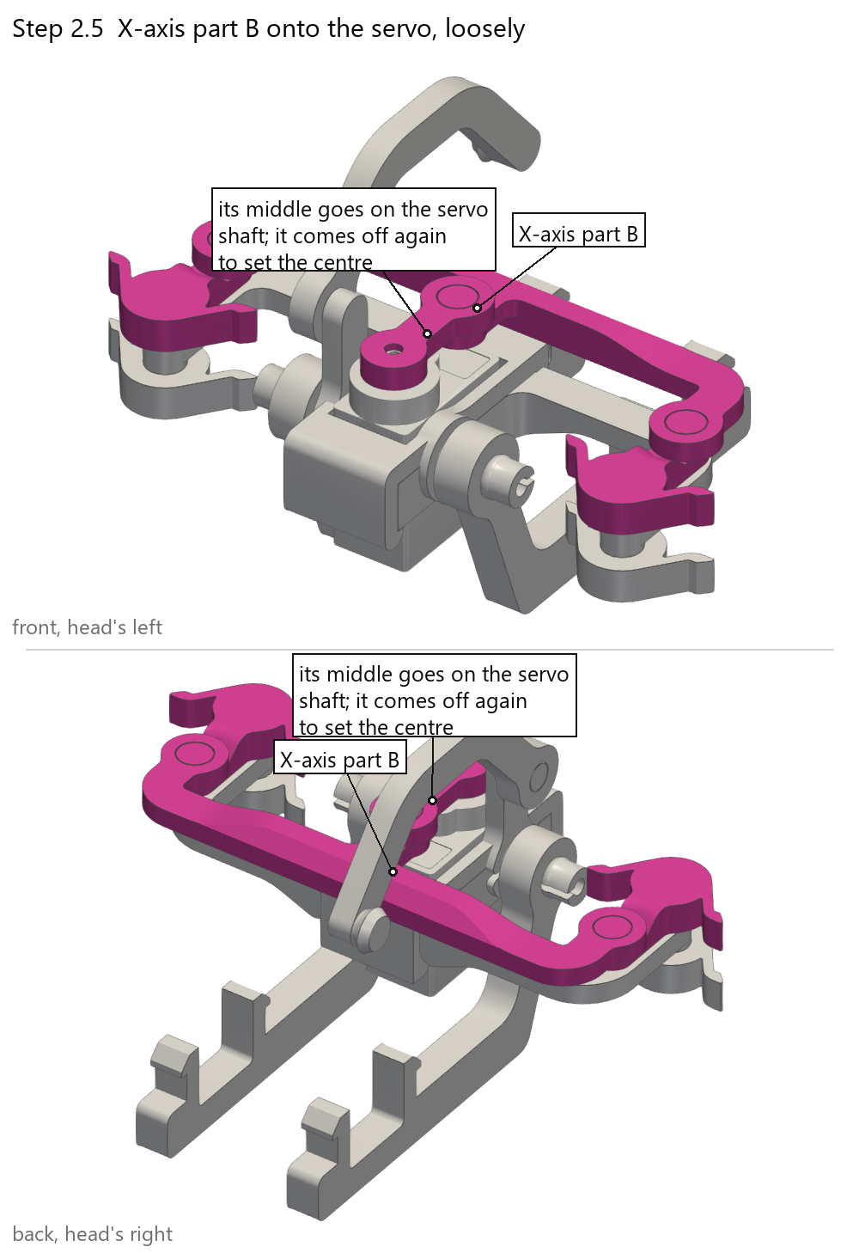
output/manual/s2_05_x_axis_b.png
