LarsLangenbach/halloween-animatronic/output/manual/s2_06_into_base.png

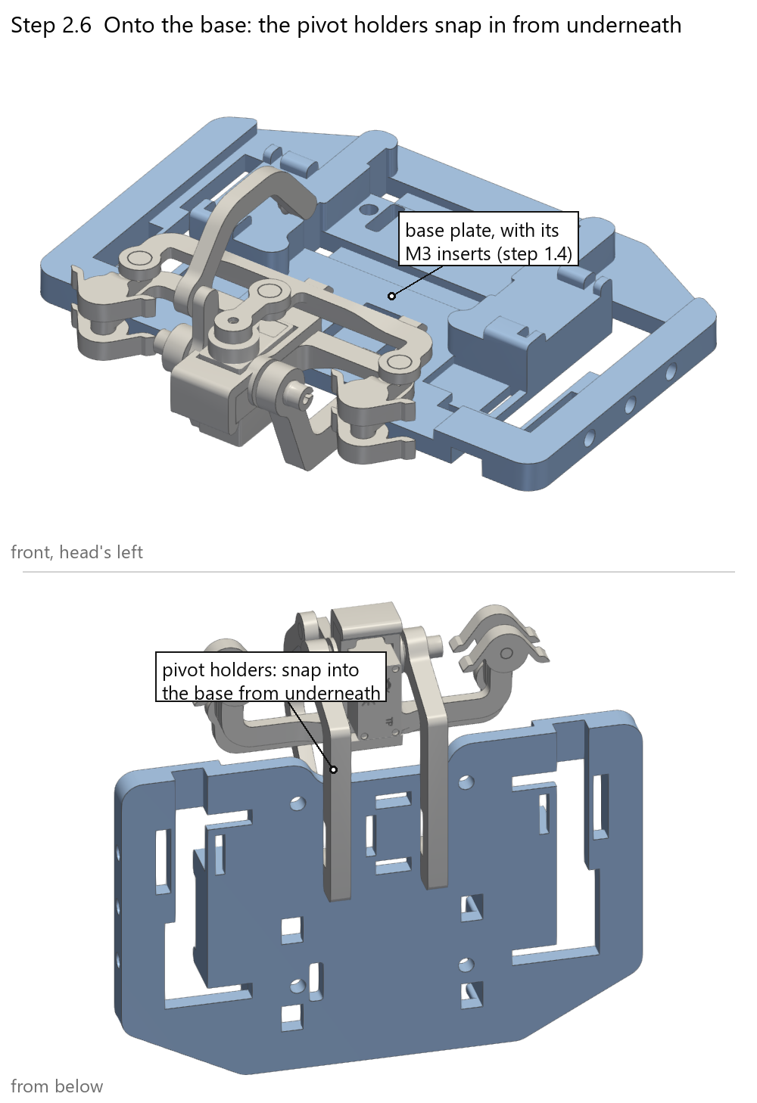
output/manual/s2_06_into_base.png
