LarsLangenbach/halloween-animatronic/output/manual/s2_07_eyes.png

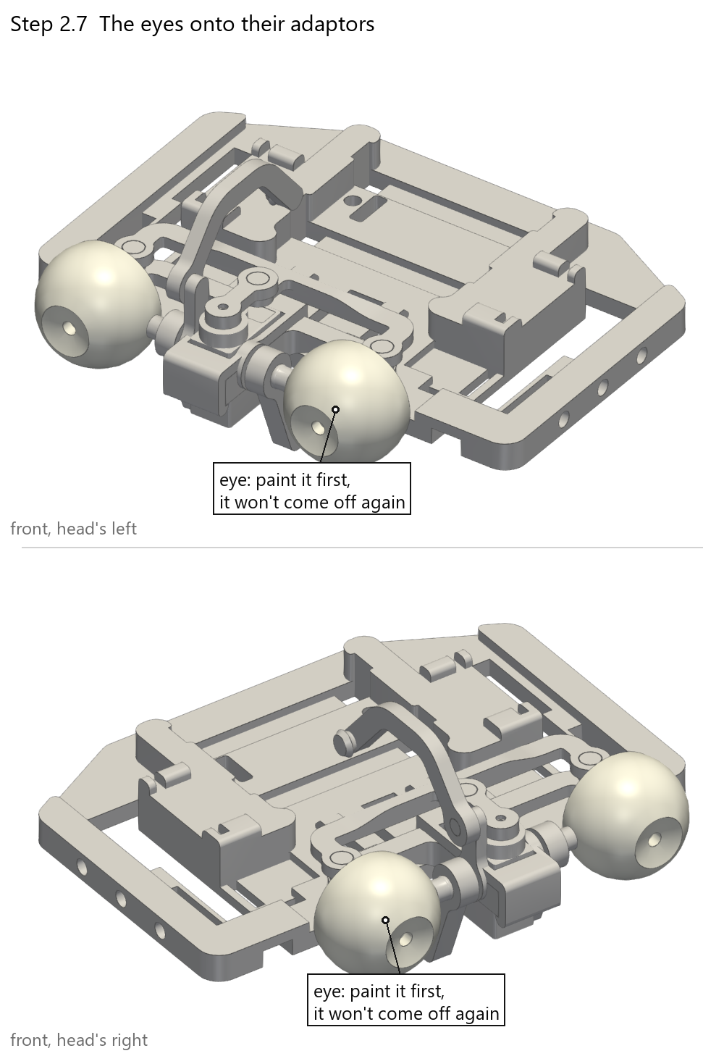
output/manual/s2_07_eyes.png
