LarsLangenbach/halloween-animatronic/output/manual/s2_08_lids.png

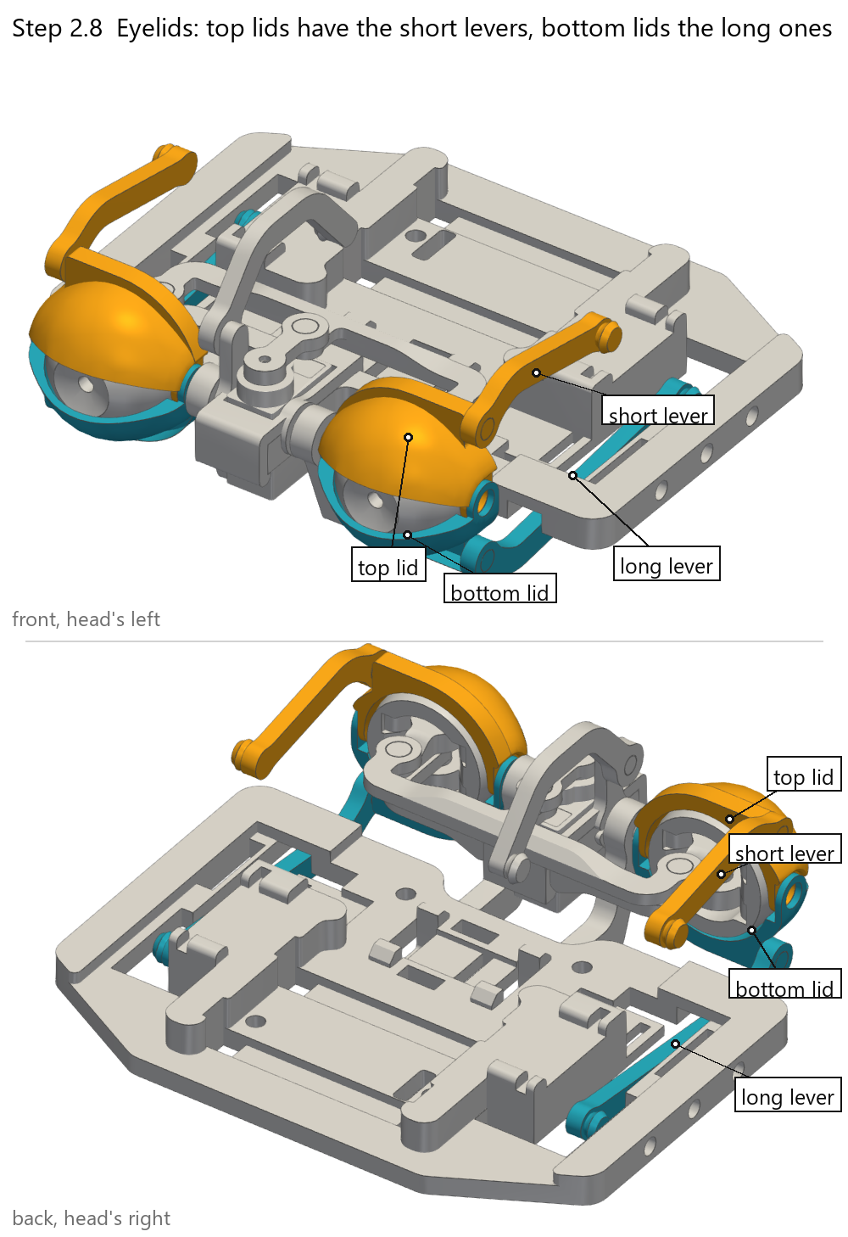
output/manual/s2_08_lids.png
