LarsLangenbach/halloween-animatronic/output/manual/s2_09_outer_pivots.png

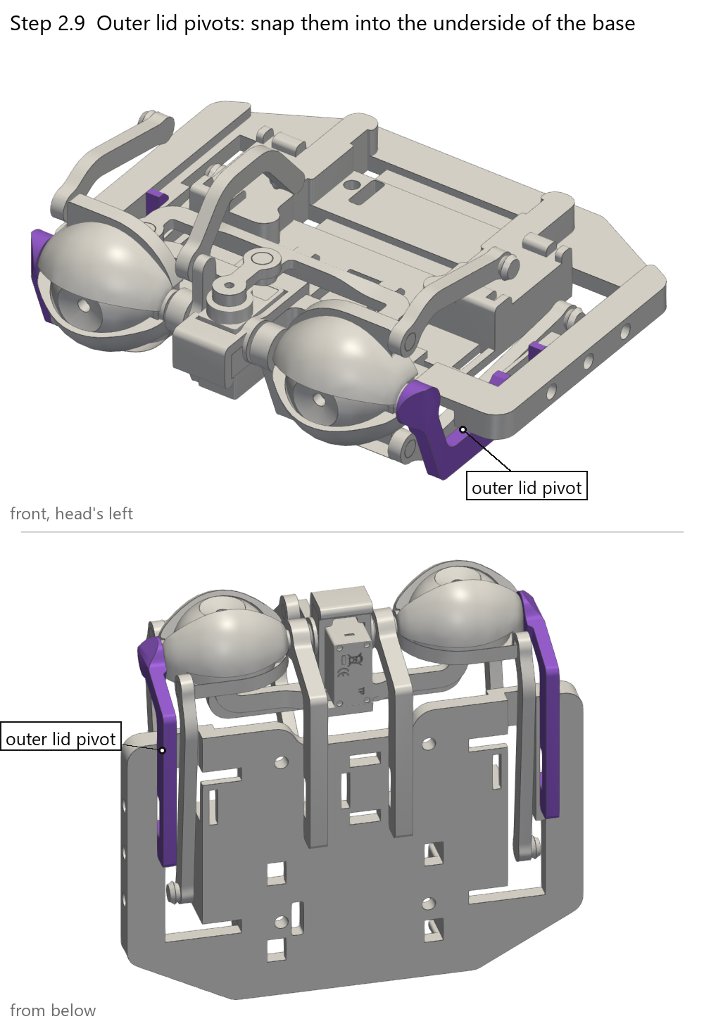
output/manual/s2_09_outer_pivots.png
