LarsLangenbach/halloween-animatronic/output/manual/s2_10_servos.png

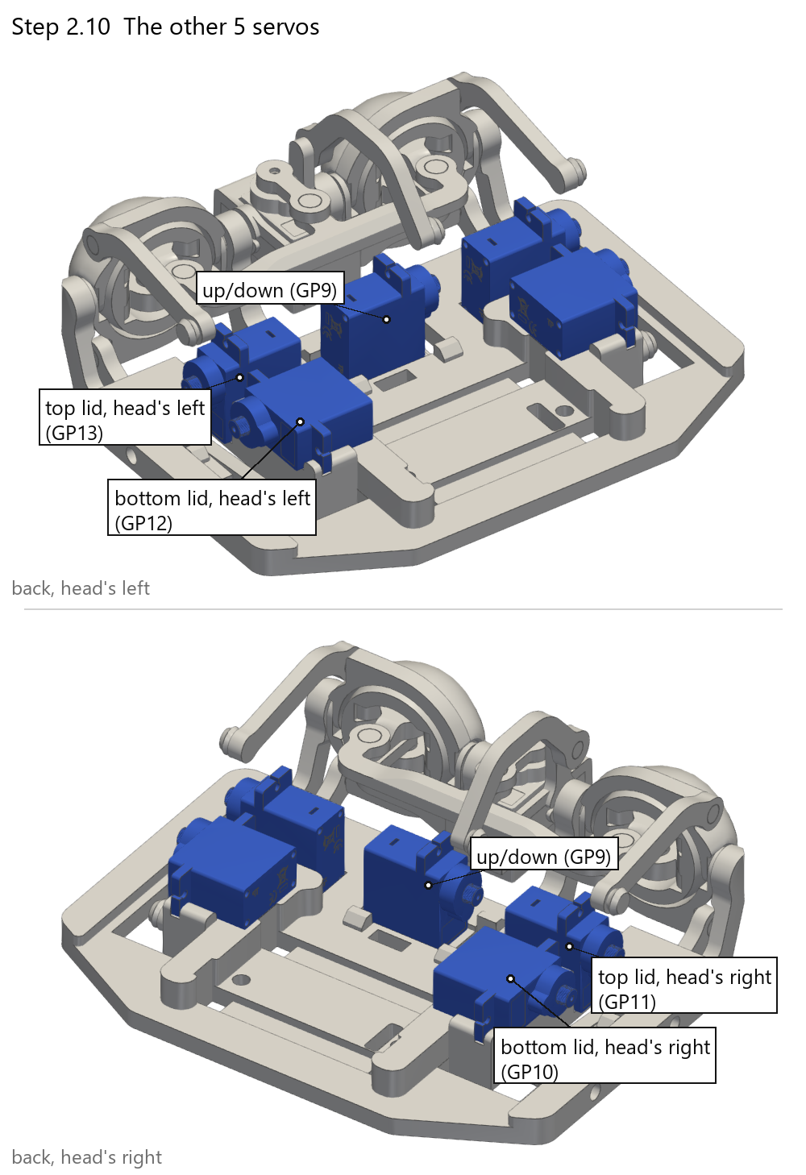
output/manual/s2_10_servos.png
