LarsLangenbach/halloween-animatronic/output/manual/s2_12_horns.png

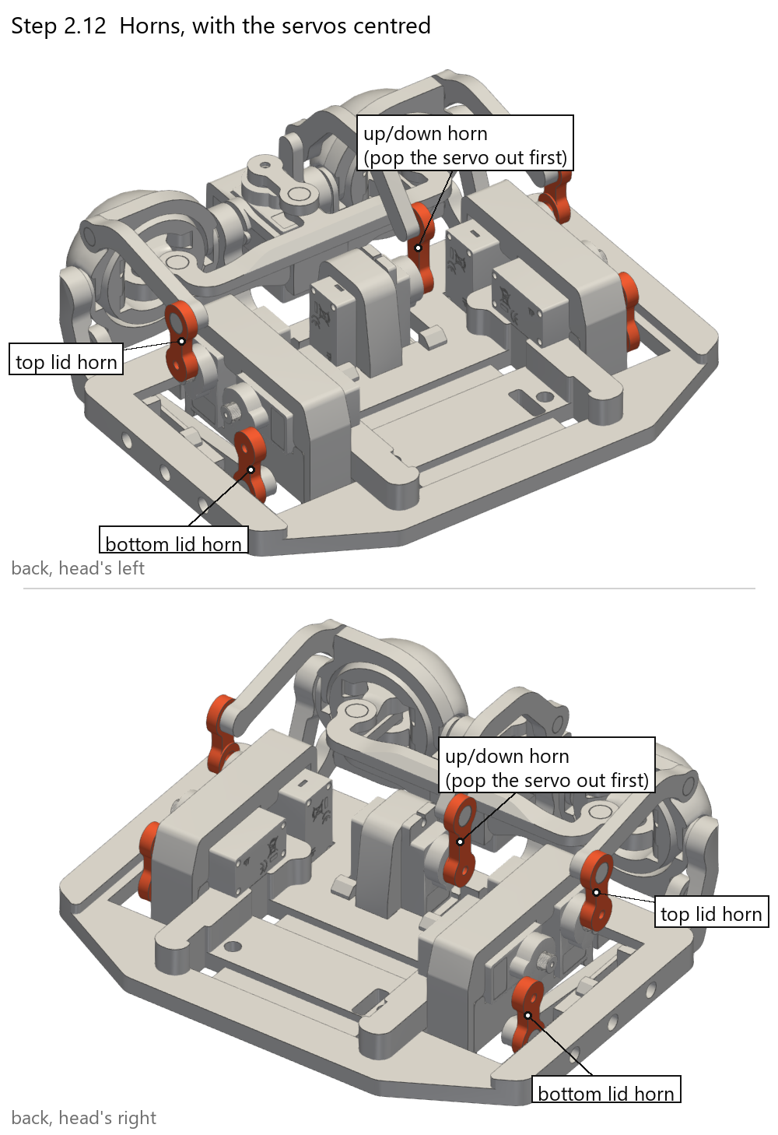
output/manual/s2_12_horns.png
