LarsLangenbach/halloween-animatronic/output/manual/s3_01_jaw_servos.png

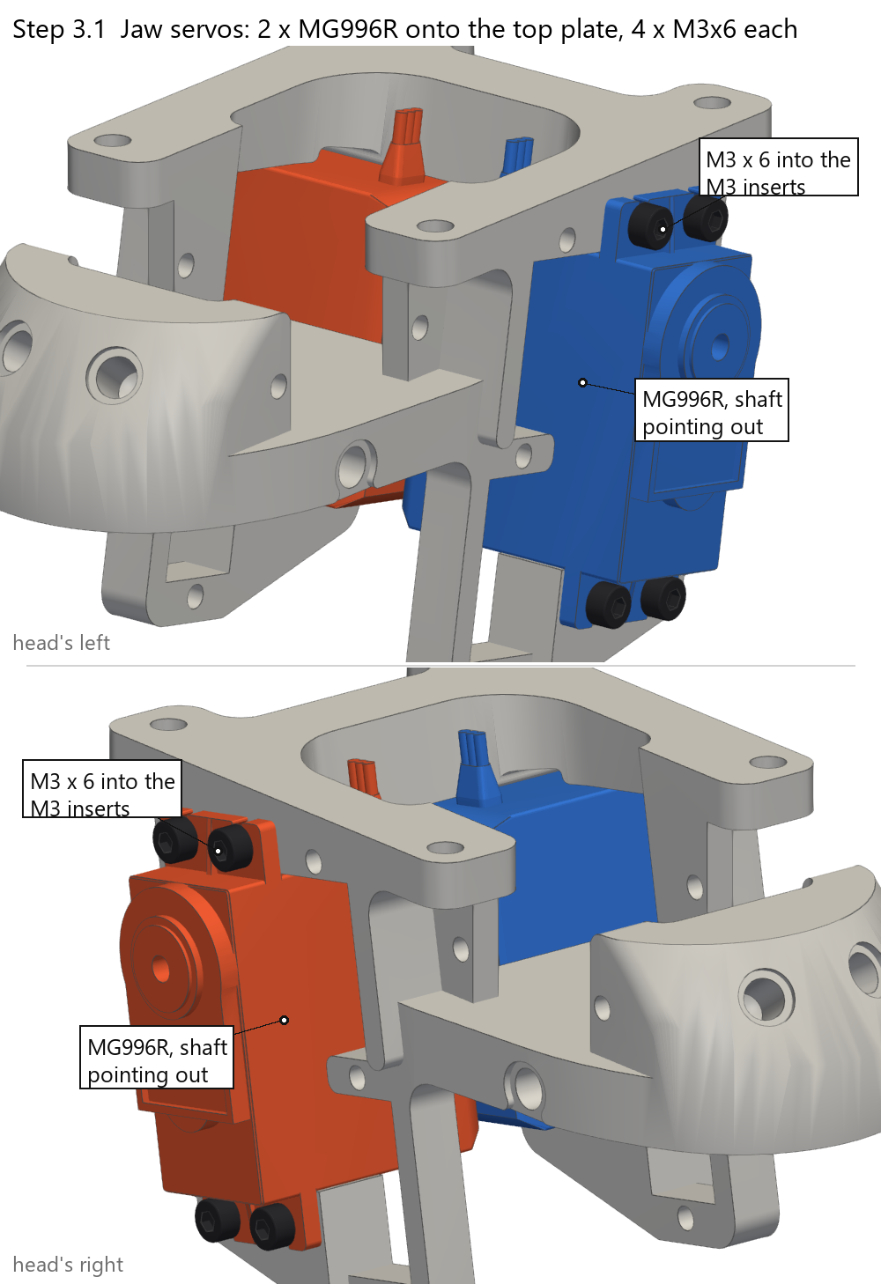
output/manual/s3_01_jaw_servos.png
