LarsLangenbach/halloween-animatronic/output/manual/s3_02_upper_lip_servos.png

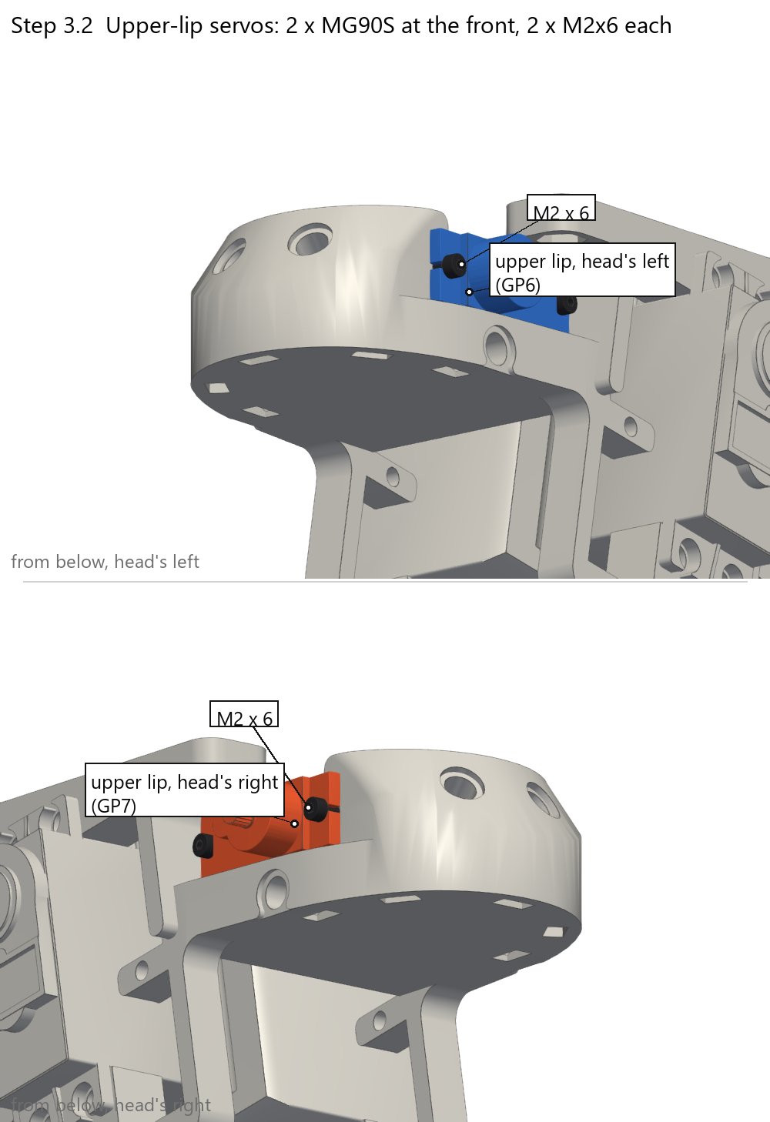
output/manual/s3_02_upper_lip_servos.png
