LarsLangenbach/halloween-animatronic/output/manual/s3_03_corner_servos.png

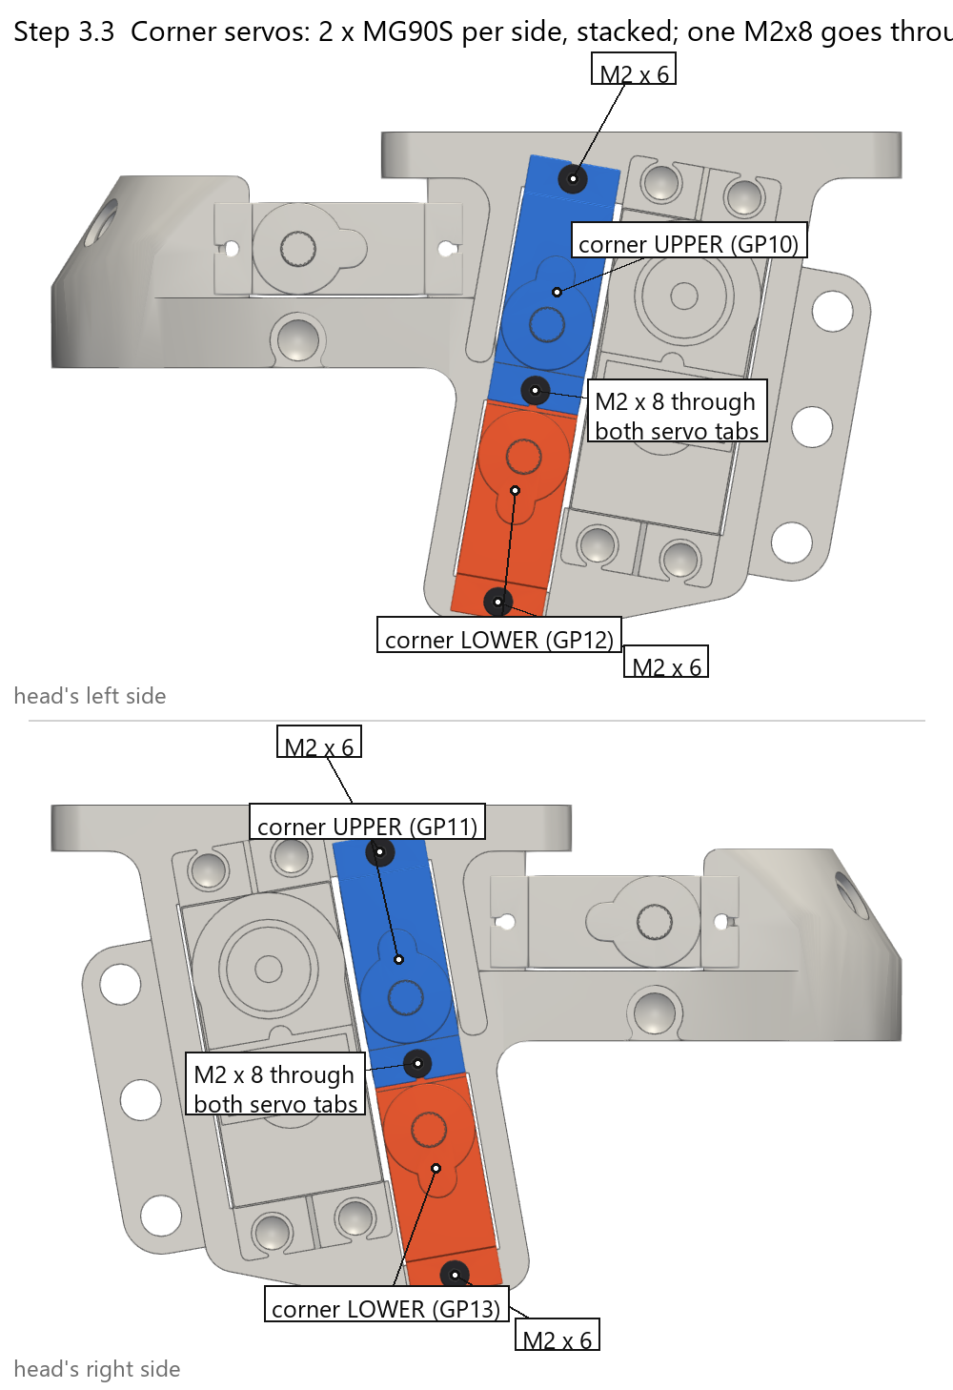
output/manual/s3_03_corner_servos.png
