LarsLangenbach/halloween-animatronic/output/manual/s3_04_upper_teeth.png

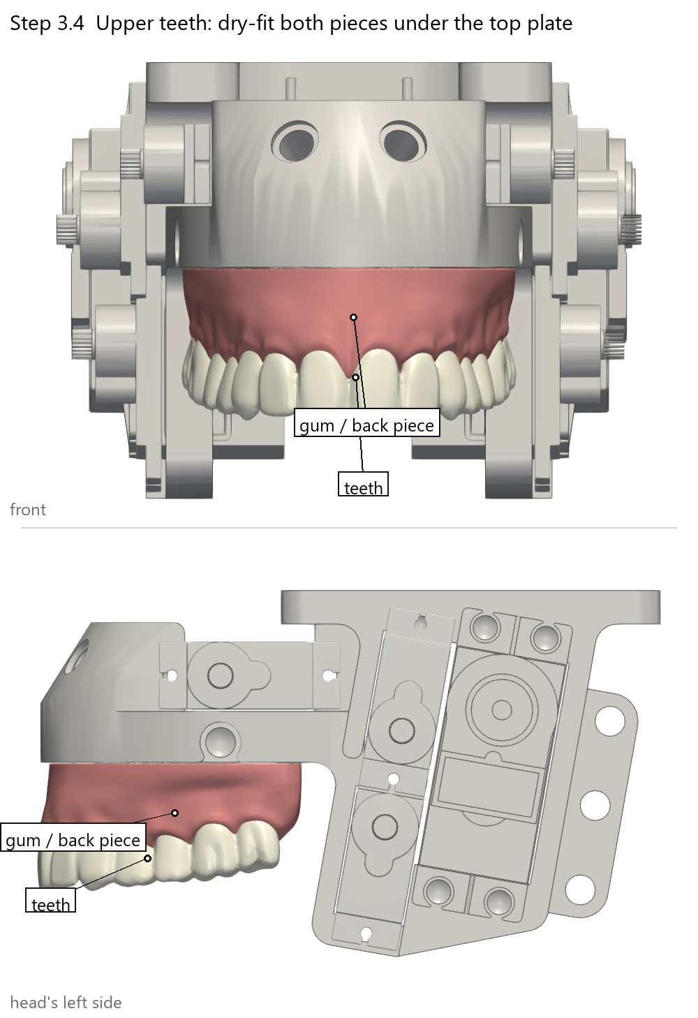
output/manual/s3_04_upper_teeth.png
