LarsLangenbach/halloween-animatronic/output/manual/s3_05_upper_lip.png

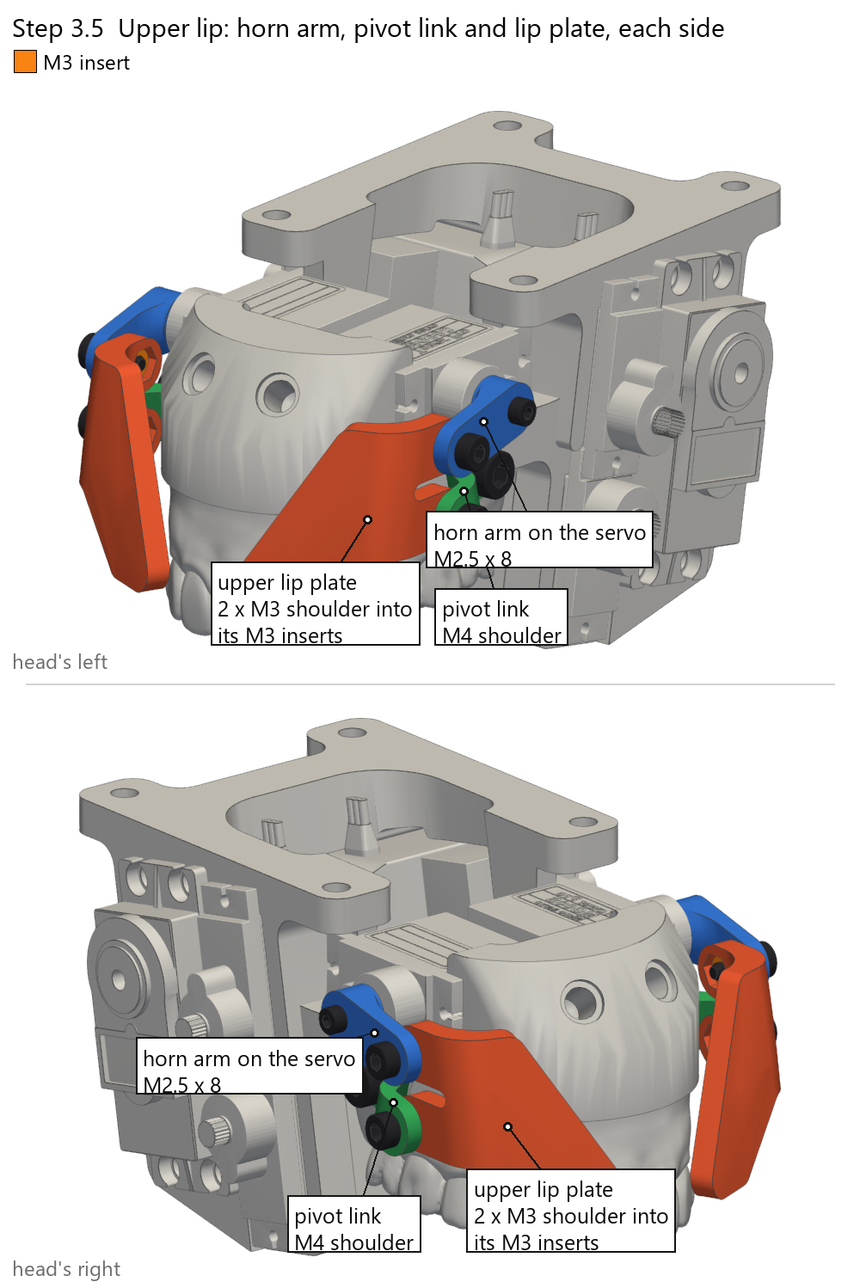
output/manual/s3_05_upper_lip.png
