LarsLangenbach/halloween-animatronic/output/manual/s3_06_corners.png

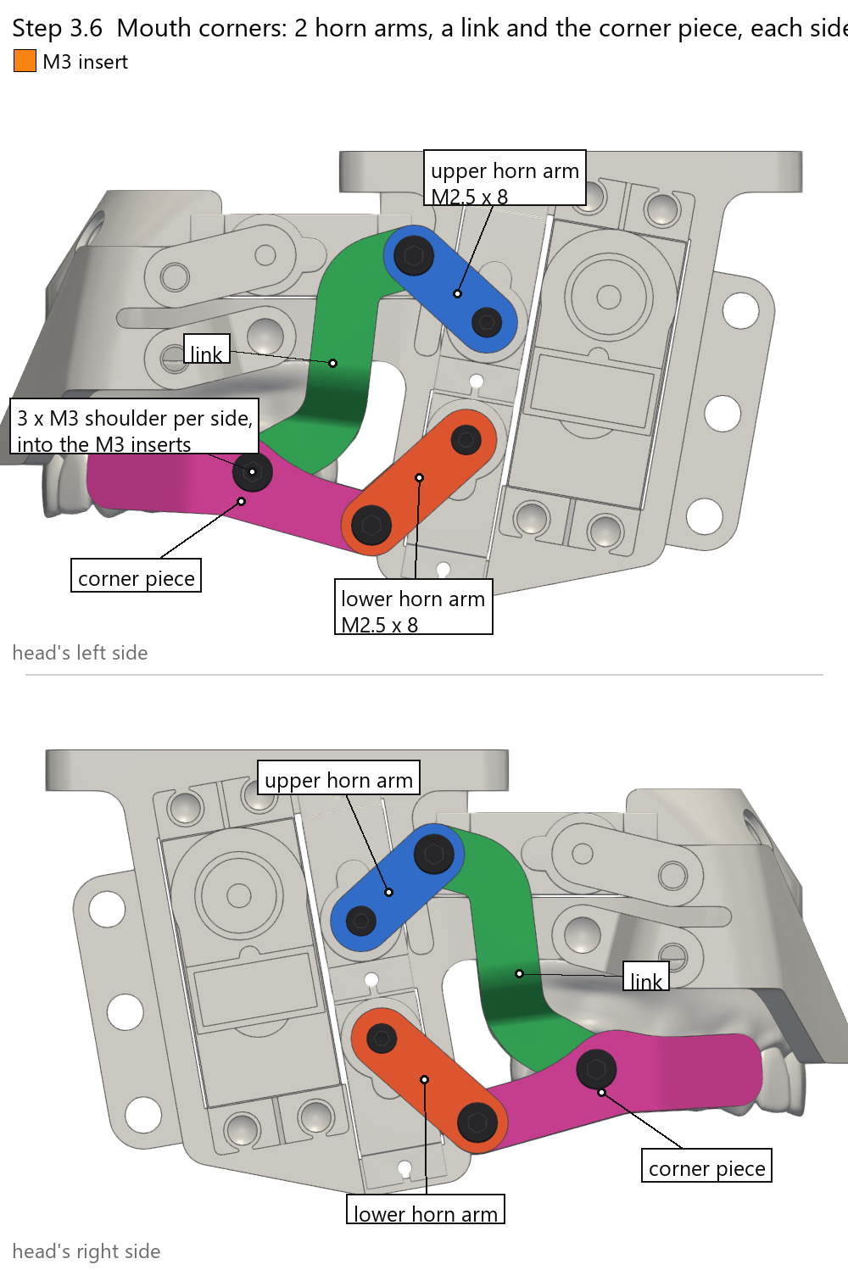
output/manual/s3_06_corners.png
