LarsLangenbach/halloween-animatronic/output/manual/s3_07_jaw_base_servos.png

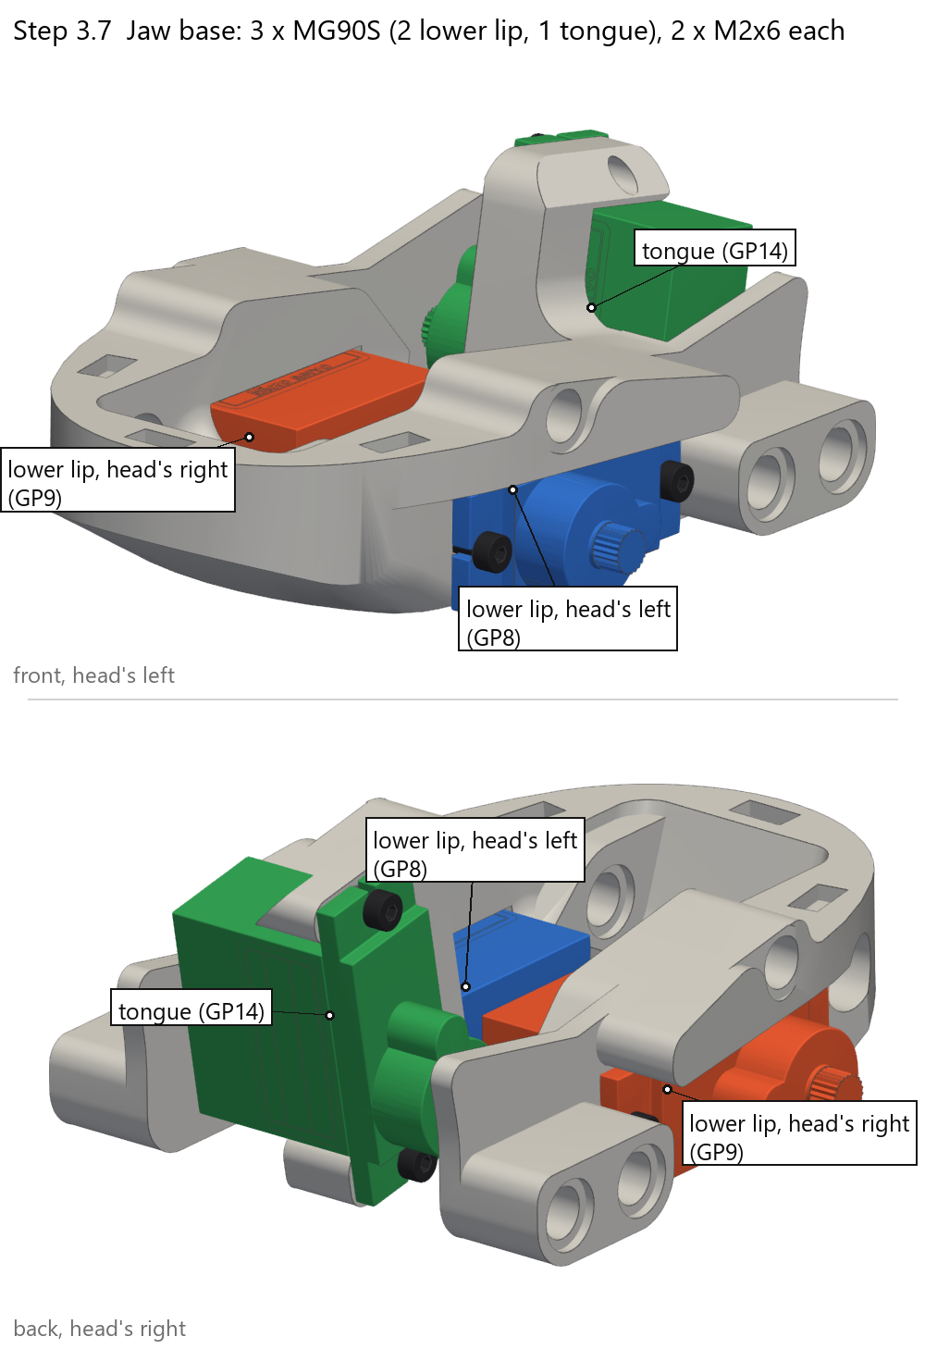
output/manual/s3_07_jaw_base_servos.png
