LarsLangenbach/halloween-animatronic/output/manual/s3_09_lower_lip.png

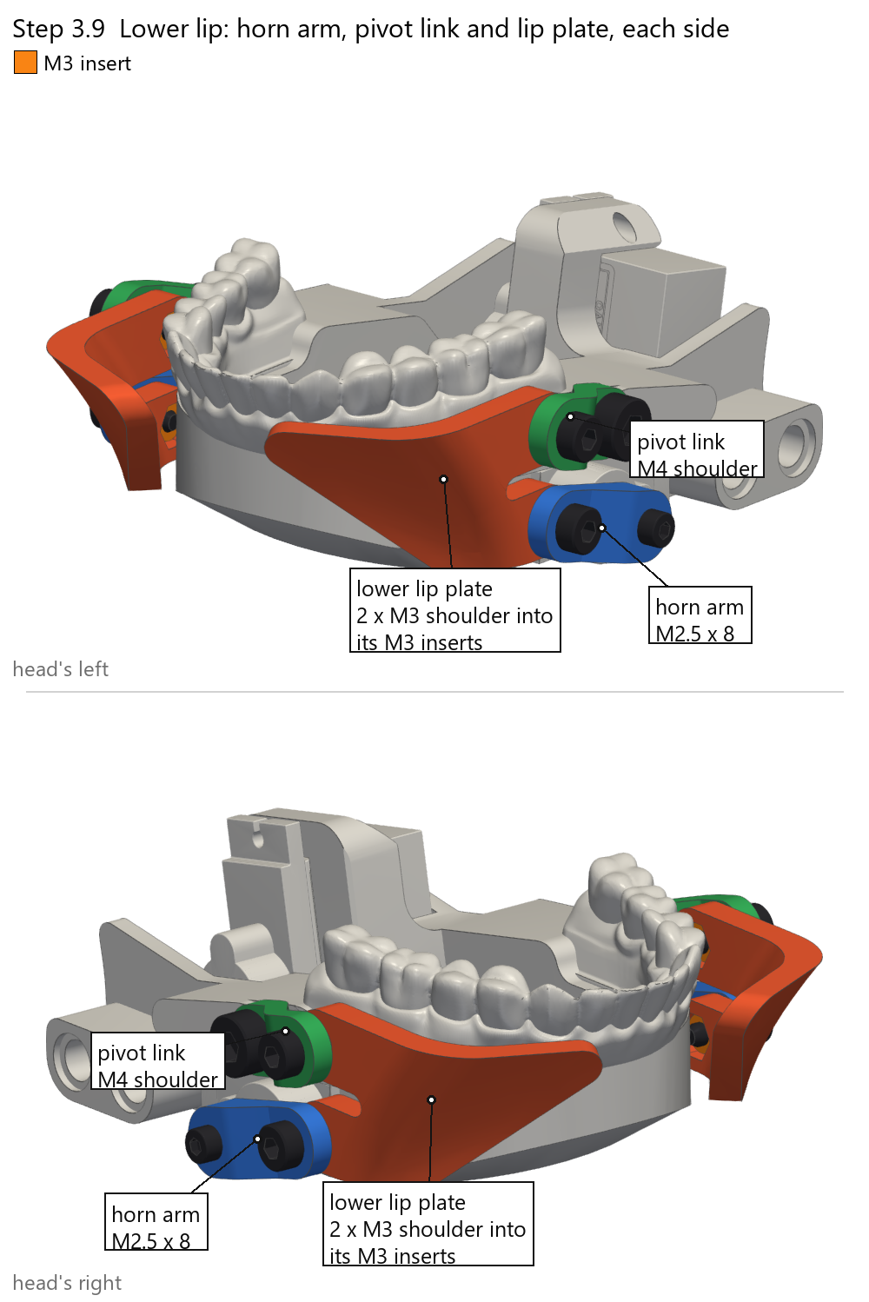
output/manual/s3_09_lower_lip.png
