LarsLangenbach/halloween-animatronic/output/manual/s3_10_tongue.png

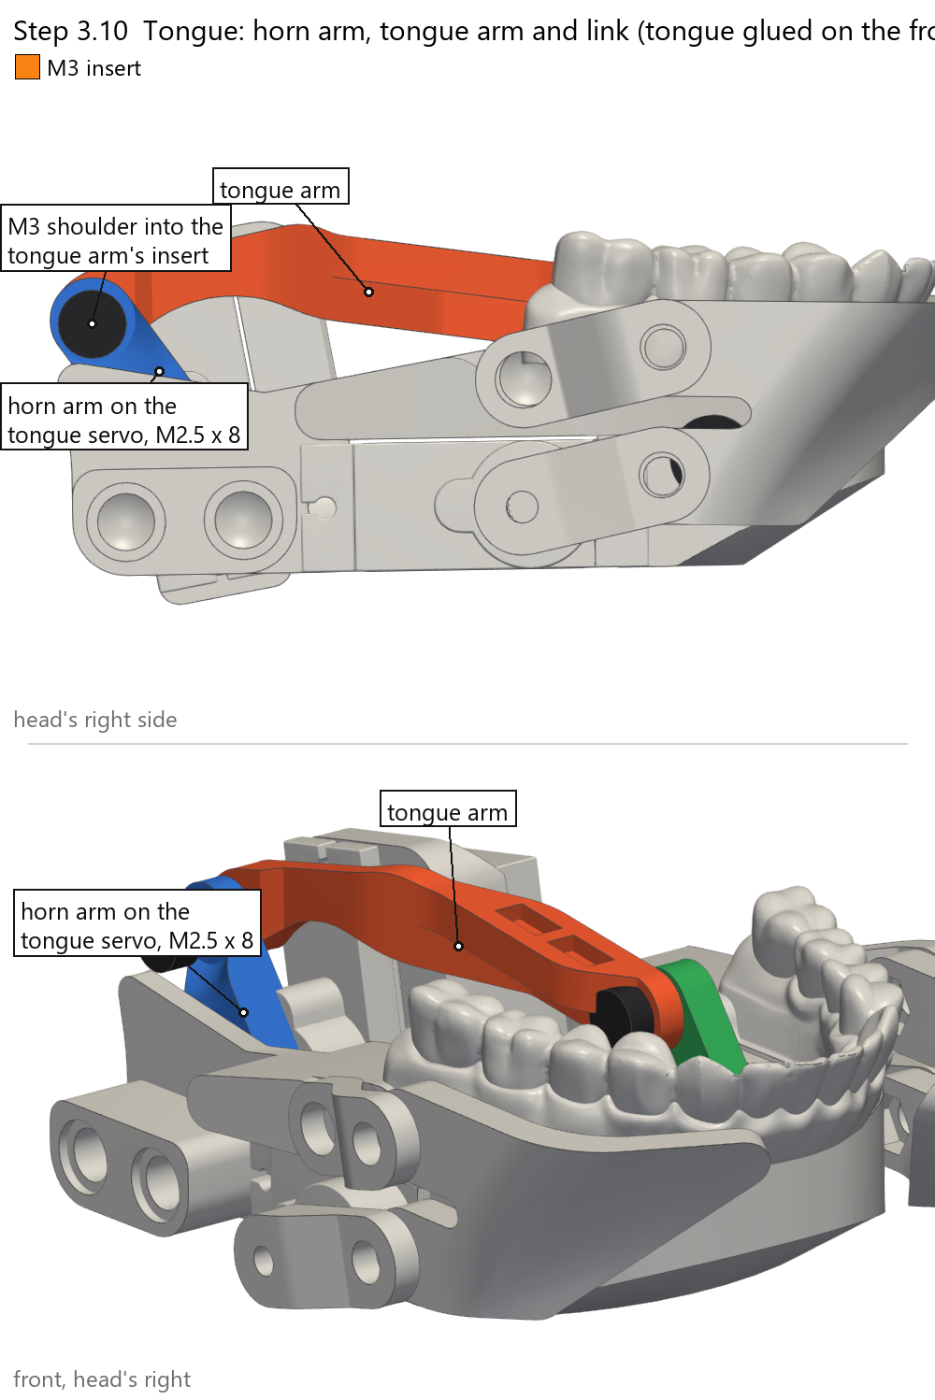
output/manual/s3_10_tongue.png
