LarsLangenbach/halloween-animatronic/output/manual/s3_11_jaw.png

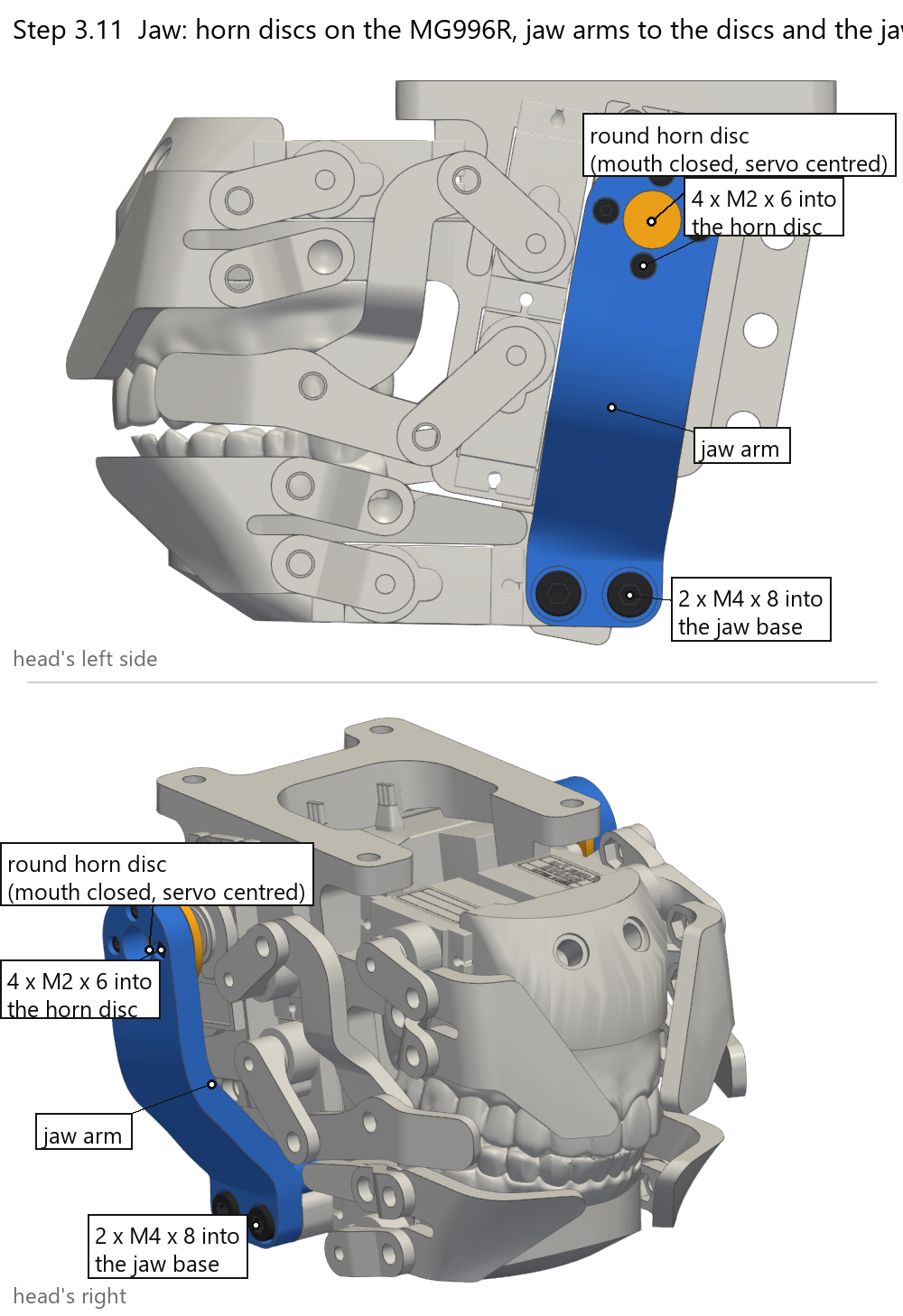
output/manual/s3_11_jaw.png
