LarsLangenbach/halloween-animatronic/output/manual/s3_12_mouth_servo_map.png

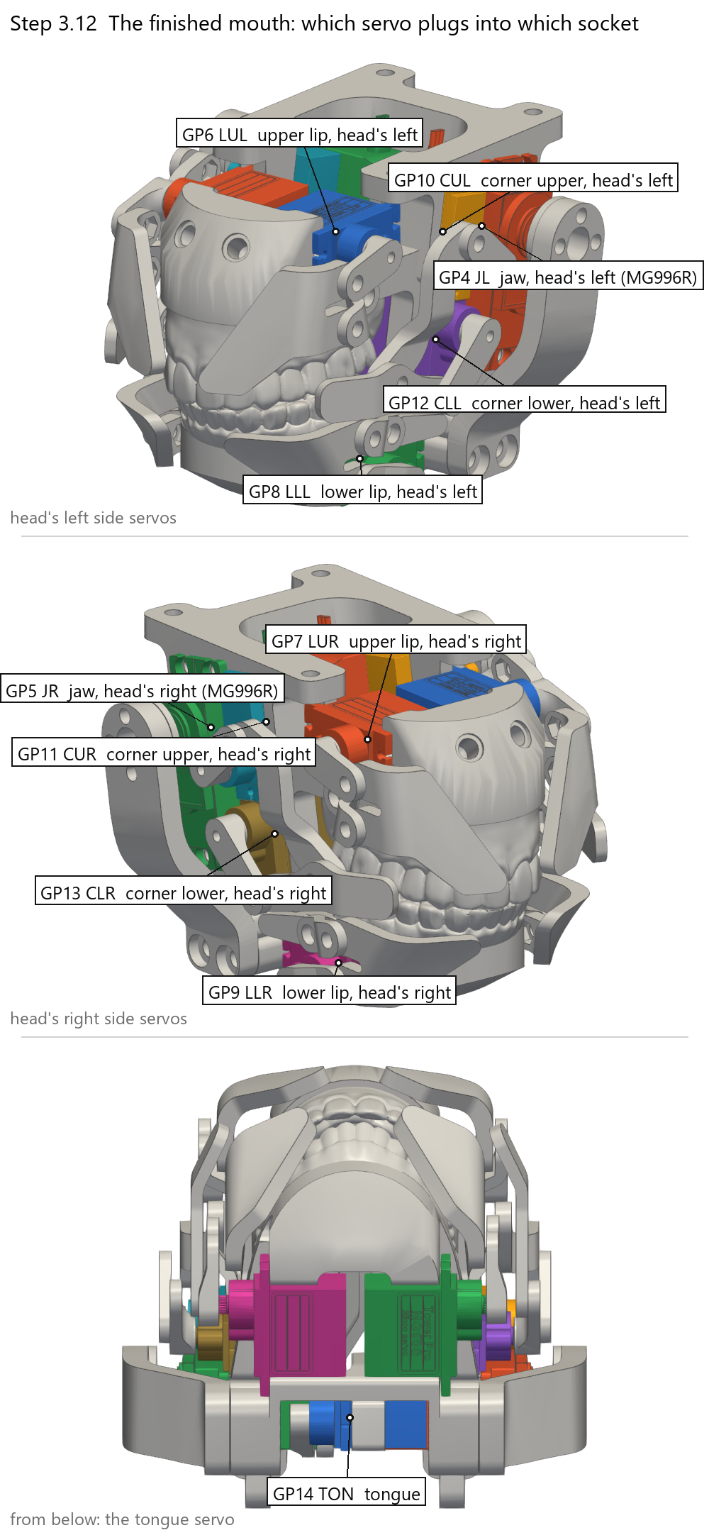
output/manual/s3_12_mouth_servo_map.png
