LarsLangenbach/halloween-animatronic/output/manual/s4_01_brow_servos.png

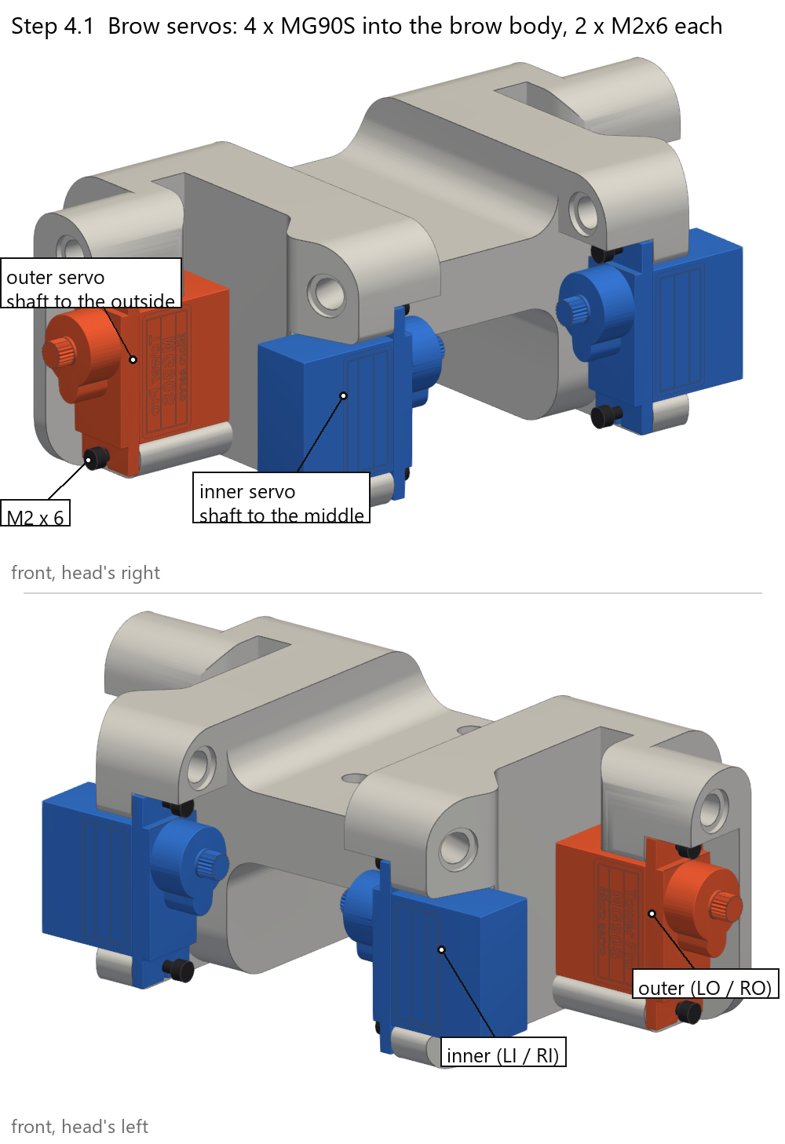
output/manual/s4_01_brow_servos.png
