LarsLangenbach/halloween-animatronic/output/manual/s4_02_brow_horns_idlers.png

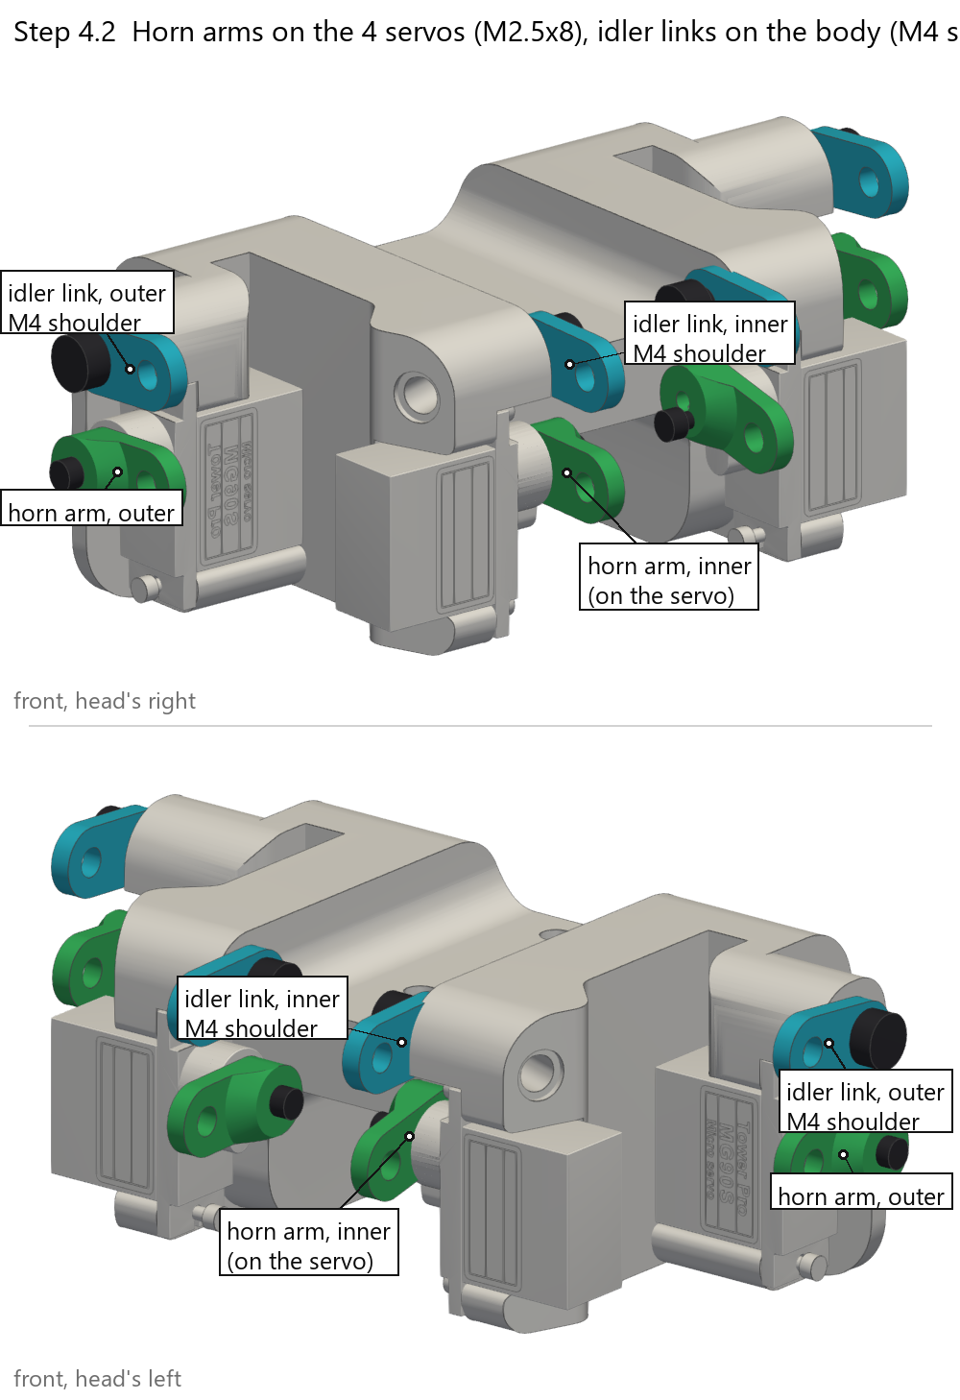
output/manual/s4_02_brow_horns_idlers.png
