LarsLangenbach/halloween-animatronic/output/manual/s4_03_brow_arms.png

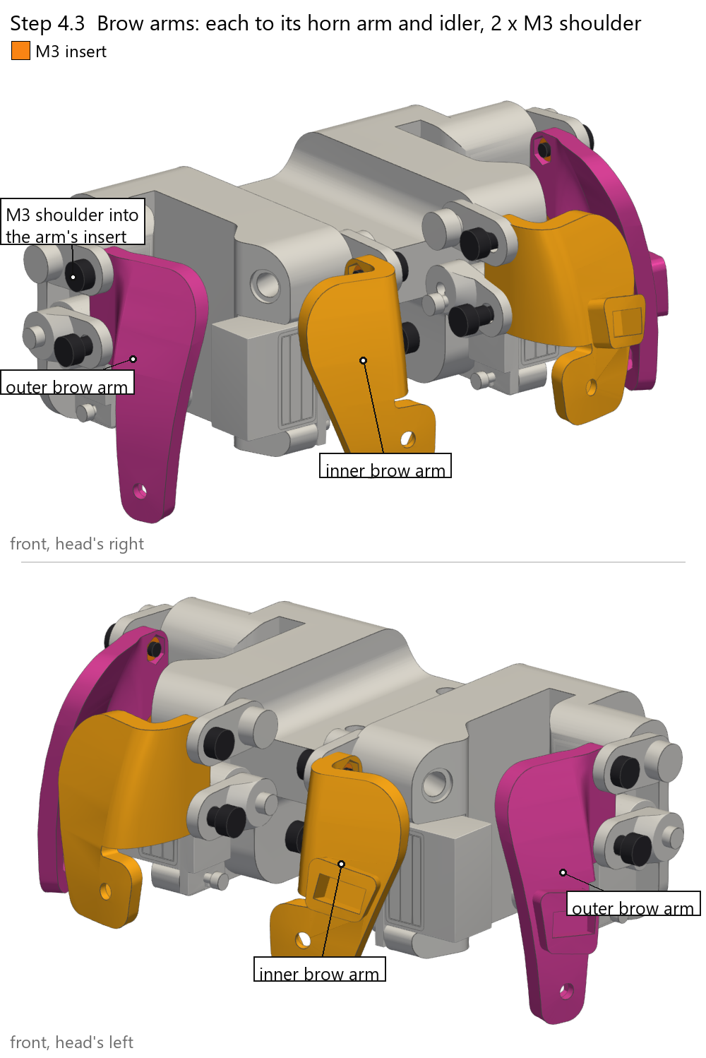
output/manual/s4_03_brow_arms.png
