LarsLangenbach/halloween-animatronic/output/manual/s4_04_brow_bars.png

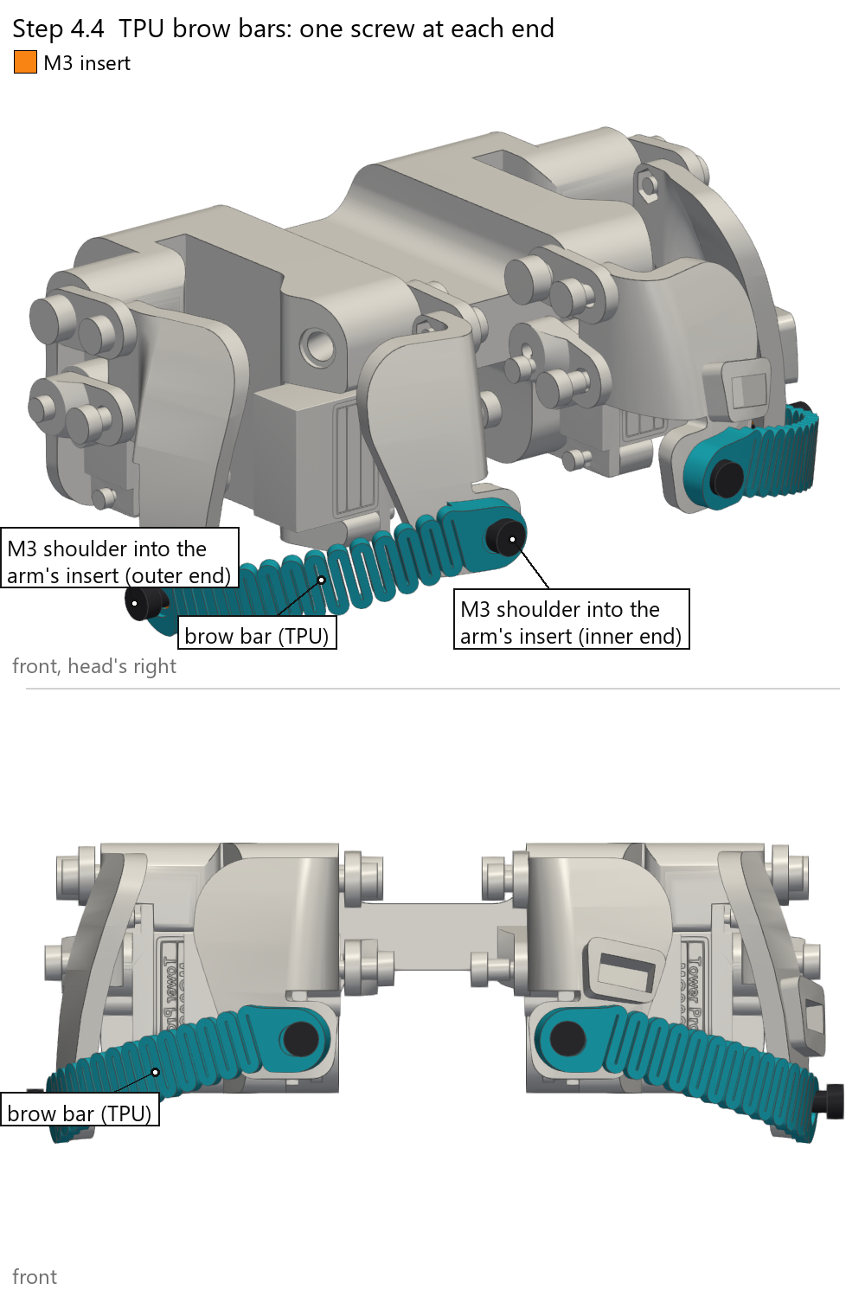
output/manual/s4_04_brow_bars.png
