LarsLangenbach/halloween-animatronic/output/manual/s5_01_mouth_in.png

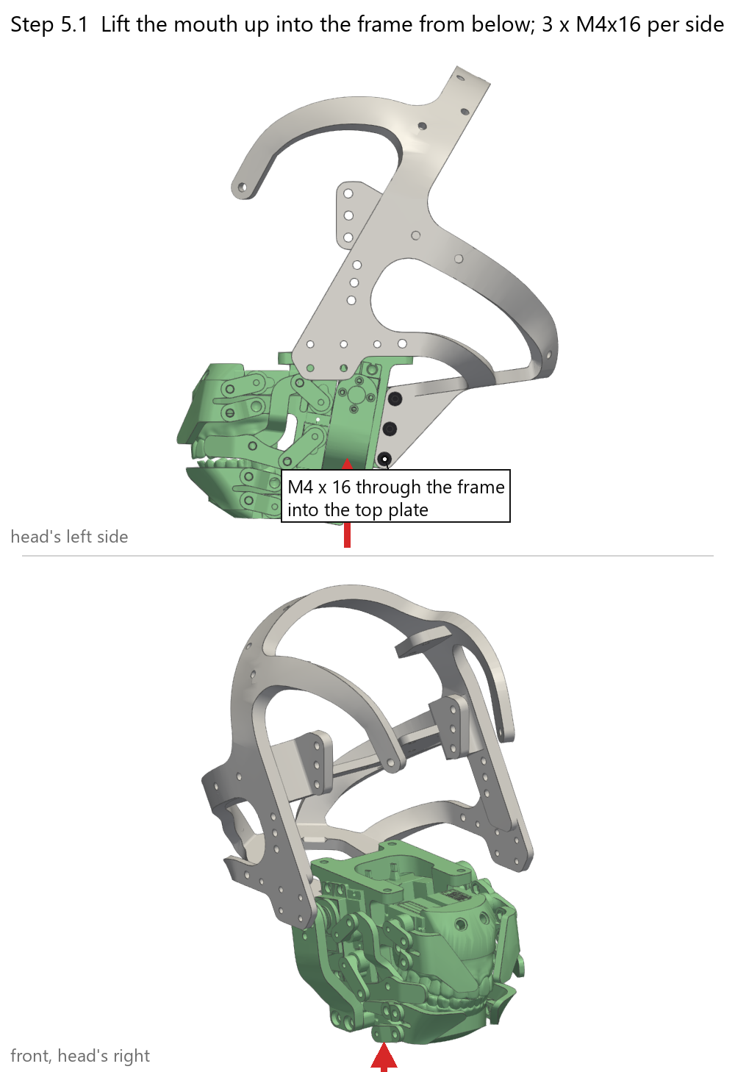
output/manual/s5_01_mouth_in.png
