LarsLangenbach/halloween-animatronic/output/manual/s5_02_cheek_bone.png

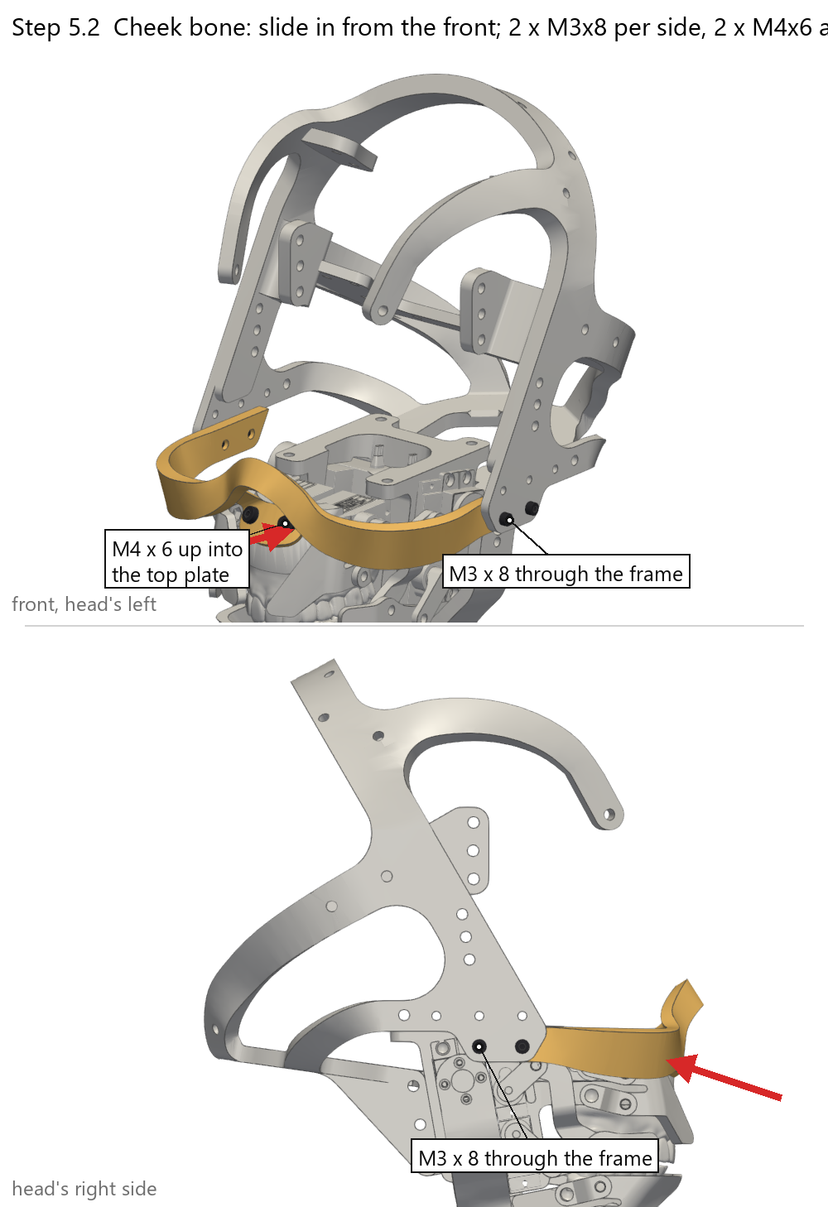
output/manual/s5_02_cheek_bone.png
