LarsLangenbach/halloween-animatronic/output/manual/s5_03_eyes_in.png

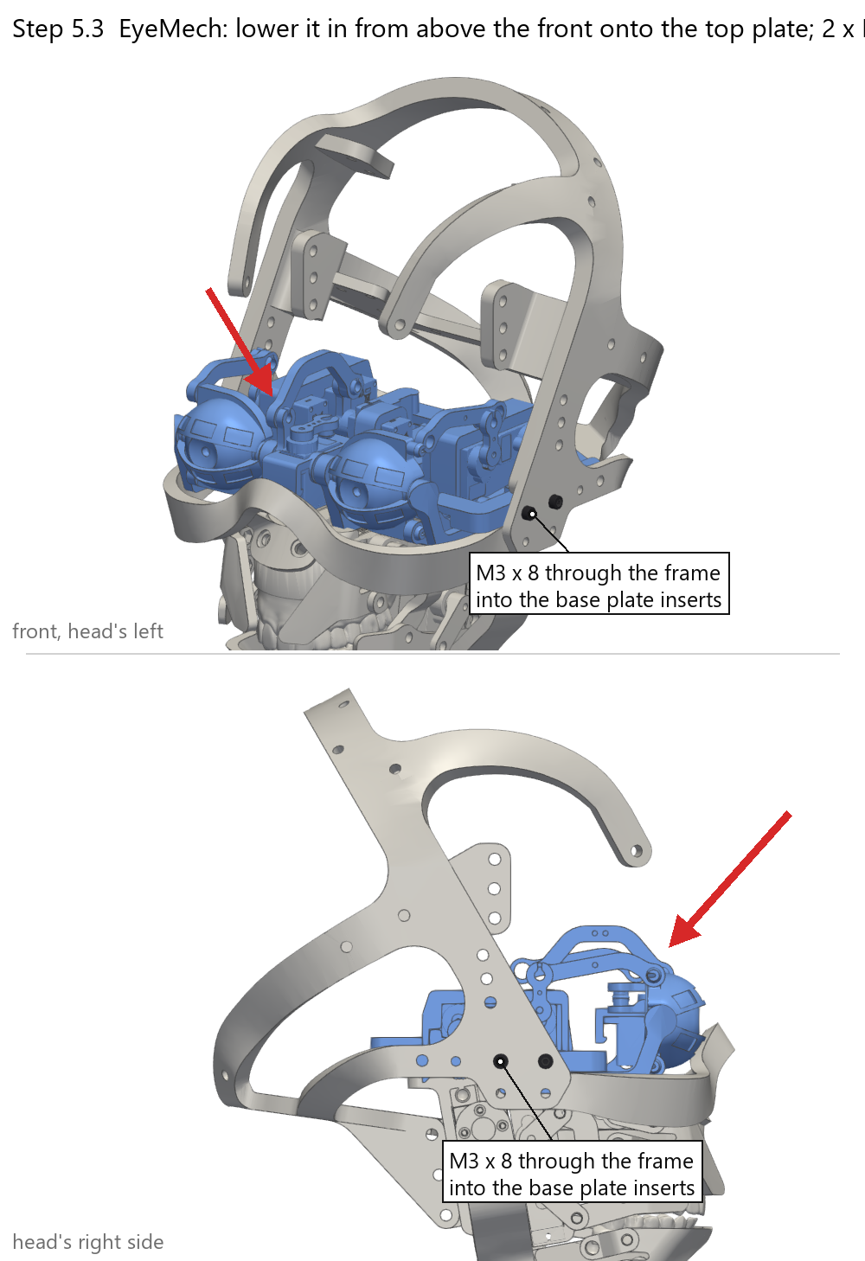
output/manual/s5_03_eyes_in.png
