LarsLangenbach/halloween-animatronic/output/manual/s5_04_brows_in.png

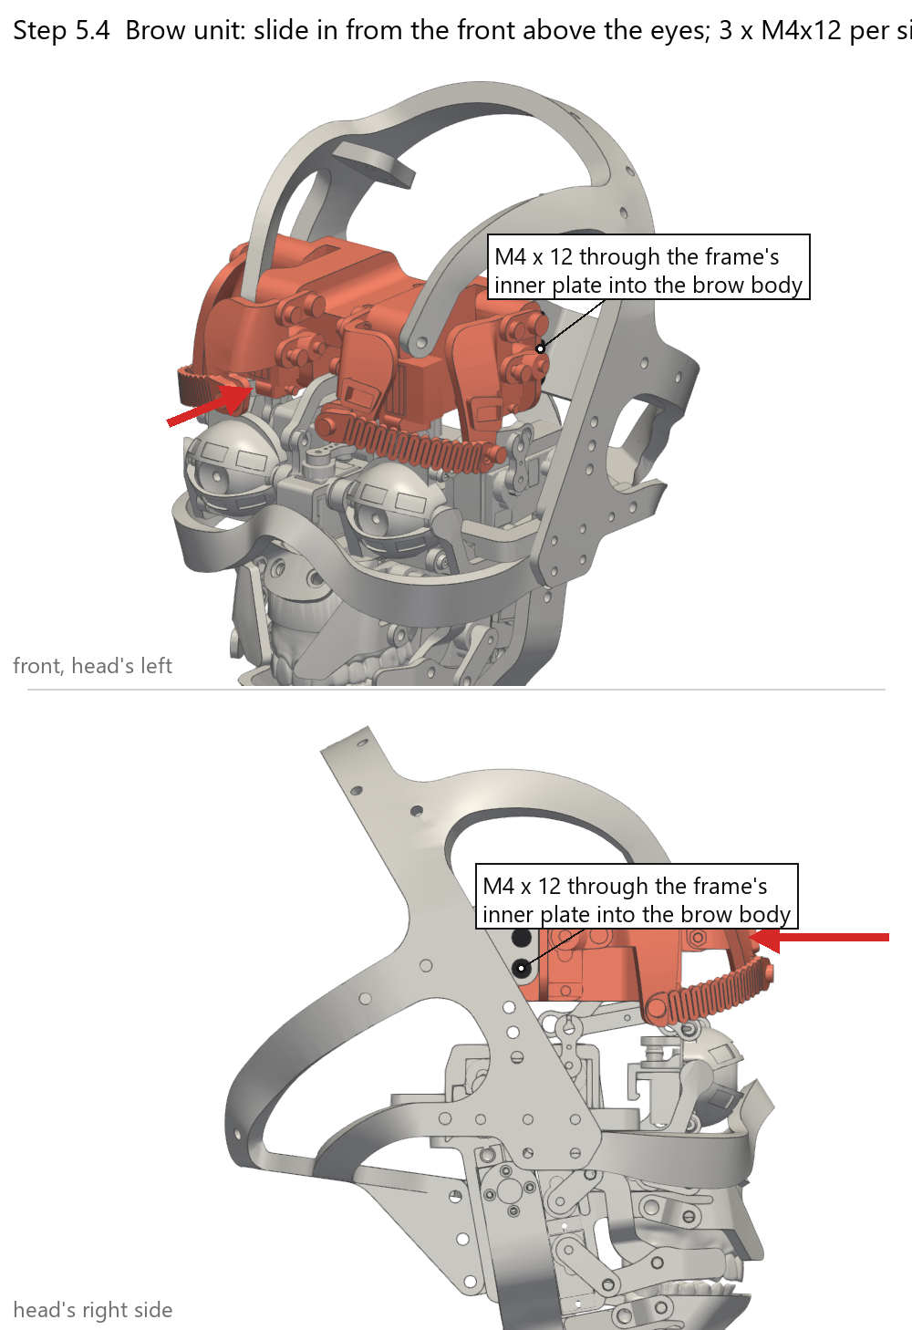
output/manual/s5_04_brows_in.png
