LarsLangenbach/halloween-animatronic/output/manual/s5_05_fan_bracket.png

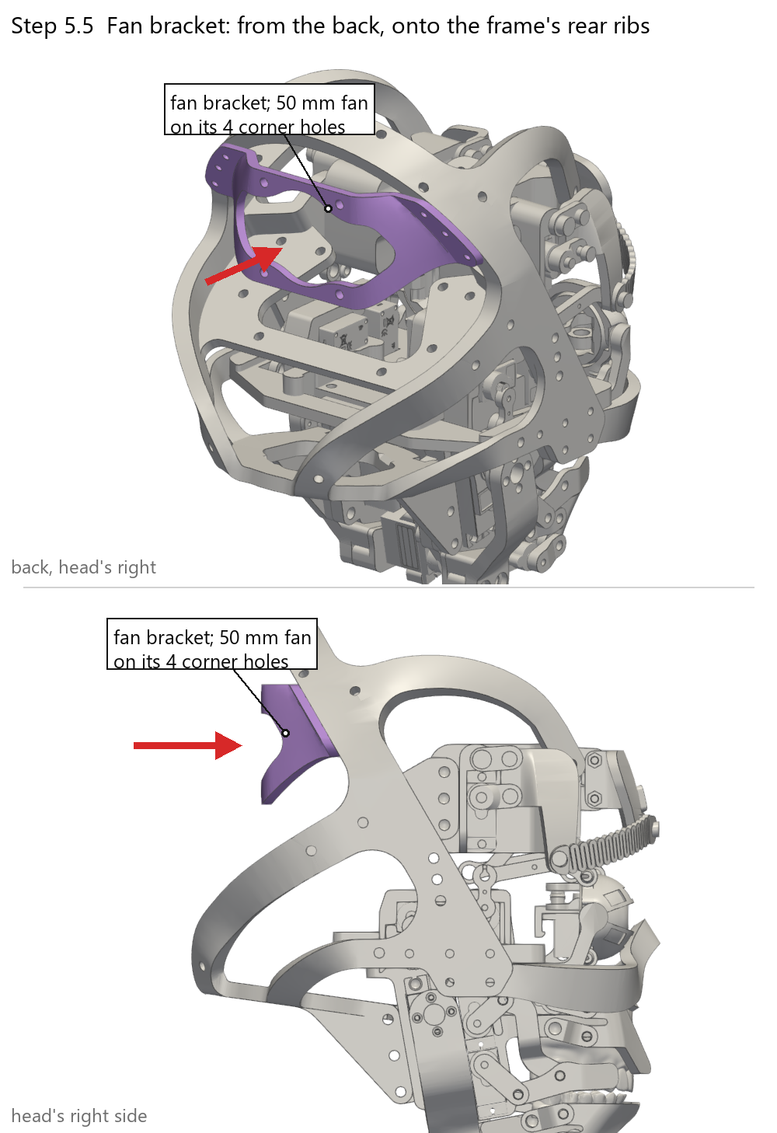
output/manual/s5_05_fan_bracket.png
