LarsLangenbach/halloween-animatronic/(list of files, drawings)

Other design files:
inputs/reference/head_a2.0.33/electronics/ProDoc_Eyes_Brow_Neck_2025-04-16.epro
inputs/reference/head_a2.0.33/electronics/ProDoc_Mouth Board_2025-04-16.epro
