LarsLangenbach/halloween-animatronic/firmware/eyes_mouthboard.py

"""
Cogley Robot Head a2.0.33 eyes.py, adapted to run on his MOUTH board instead of the
Eyes/Brow/Neck board (the team has mouth boards only; PLAN D18). Changes from his file:
  - mode switch on GP28 (the mouth board's switch) instead of GP1: GP1 is not wired on the
    mouth board, and with its pull-up it read 1 = calibration mode, so the eyes sat at 90
  - no `enable` input on GP6 (unused; GP6 is a servo output on the mouth board)
  - no `picozero` import (unused)
Everything else is his. Servo outputs GP8-GP13 are mouth-board outputs as they are. The
mouth board running MouthMaster.py drives GP16/GP17 here through the link cable.
Needs his `servo` MicroPython library on the Pico.
"""

import time
from machine import Pin, ADC
from servo import Servo
import random

# Set up the switches and potentiometers
mode = Pin(28, Pin.IN, Pin.PULL_UP)   # the mouth board's switch (his Eyes board: GP1)
SDA = Pin(16, Pin.IN)
SCL = Pin(17, Pin.IN)


# Define servos
servos = {
    "LR": Servo(pin_id=8),
    "UD": Servo(pin_id=9),
    "TL": Servo(pin_id=13),
    "BL": Servo(pin_id=12),
    "TR": Servo(pin_id=11),
    "BR": Servo(pin_id=10),
}

servo_limits = {
    "LR": (40, 140),   # Min, Max
    "UD": (60, 140),
    "TL": (90, 160),
    "BL": (90, 30),
    "TR": (90, 30),
    "BR": (90, 140),
}

def calibrate():
    for name, servo in servos.items():
#         print("neutral position")  # Debug output
        servo.write(90)

def neutral():
    eyes = list(servos.keys())[2:]  # Get last 4 servo names
    for name, servo in servos.items():
        servo.write(90)
    lids = list(servos.keys())[-4:]  # Get last 4 servo names
    for servo in lids:
        max_angle = servo_limits[servo][1]  # Get min angle
        servos[servo].write(max_angle)  # Move to min      
        
def move_servo_random(servo):
    """Moves the servo to a random position within its defined range."""
    min_angle, max_angle = servo_limits[servo]  # Get range from dictionary
    random_angle = random.randint(min_angle, max_angle)  # Get random value
    servos[servo].write(random_angle)
    print(f"Moved {servo} to {random_angle}°")  # Debug output
#     move_servo_random("LR")

def move_servo_extremes(servo, delay): # Moves the servo between its min and max values
    min_angle, max_angle = servo_limits[servo]
    servos[servo].write(min_angle)  # Move to min position
    print(min_angle)
    time.sleep_ms(delay)
    servos[servo].write(max_angle)  # Move to max position
    print(max_angle)
    time.sleep_ms(delay)
    
def blink():
    lids = list(servos.keys())[-4:]  # Get last 4 servo names
    for servo in lids:
        min_angle = servo_limits[servo][0]  # Get min angle
        servos[servo].write(min_angle)  # Move to min
        
def control_ud_and_lids(ud_angle): # Moves UD servo and makes TL/TR follow instantly based on UD's position
    # Get limits
    ud_min, ud_max = servo_limits["UD"]
    tl_min, tl_max = servo_limits["TL"]
    tr_min, tr_max = servo_limits["TR"]
    bl_min, bl_max = servo_limits["BL"]
    br_min, br_max = servo_limits["BR"]

    # Normalize UD position to a 0-1 range
    ud_progress = (ud_angle - ud_min) / (ud_max - ud_min)  # 0 (min) → 1 (max)
    
    # Find target positions
    tl_target = tl_max - ((tl_max - tl_min)*(0.8*(1-ud_progress)))
    tr_target = tr_max + ((tr_min - tr_max)*(0.8*(1-ud_progress)))
    bl_target = bl_max + ((bl_min - bl_max)*(0.4*(ud_progress)))
    br_target = br_max - ((br_max - br_min)*(0.4*(ud_progress)))
   
# Move all servos instantly
    servos["UD"].write(ud_angle)
    servos["TL"].write(tl_target)
    servos["TR"].write(tr_target)
    servos["BL"].write(bl_target)
    servos["BR"].write(br_target)

def scale_potentiometer(pot_value, servo, reverse=False):
    # Scale potentiometer value to UD range (50 to 130)
    in_min = 300
    in_max = 65300
    min_limit = servo_limits[servo][0]
    max_limit = servo_limits[servo][1]
    
    # Scale the potentiometer input to the servo range
    scaled_value = min_limit + (pot_value - in_min) * (max_limit - min_limit) / (in_max - in_min)
    if reverse:
       scaled_value = max_limit - (scaled_value - min_limit)
    return scaled_value

def update_eyelid_limits(trim_value):
    # Define the trim value range
    trim_min = 7000
    trim_max = 14500
    
    # Target max ranges for each eyelid servo
    TL_max_range = (130, 170)  # from most closed to most open
    BR_max_range = (130, 170)
    BL_max_range = (50, 10)    # reversed range
    TR_max_range = (50, 10)
    
    # Scale trim_value to target max ranges
    trim_progress = (trim_value - trim_min) / (trim_max - trim_min)  # 0 (closed) to 1 (open)
    trim_progress = max(0, min(1, trim_progress))  # Clamp to [0, 1] range

    # Update servo limits
    servo_limits["TL"] = (90, TL_max_range[0] + (TL_max_range[1] - TL_max_range[0]) * trim_progress)
    servo_limits["BR"] = (90, BR_max_range[0] + (BR_max_range[1] - BR_max_range[0]) * trim_progress)
    servo_limits["BL"] = (90, BL_max_range[0] + (BL_max_range[1] - BL_max_range[0]) * trim_progress)
    servo_limits["TR"] = (90, TR_max_range[0] + (TR_max_range[1] - TR_max_range[0]) * trim_progress)

#     print("Updated servo limits:")
#     print(servo_limits)
        
        
while True:
    mode_state = mode.value()
    if mode_state == 1: # Enter calibration mode when switch is in hold position
        calibrate()
        time.sleep_ms(500)
    else:
        if SDA.value() == 0 and SCL.value() == 0: # Closed Eye
            calibrate()
        if SDA.value() == 1 and SCL.value() == 0: # Open Eye
            neutral()
        if SDA.value() == 1 and SCL.value() == 1: # Auto mode
            command = random.randint(0,2)
            if command == 0:
                blink()
                time.sleep_ms(50)
            elif command == 1:
                blink()
                time.sleep_ms(60)
                control_ud_and_lids(random.randint(servo_limits["UD"][0],servo_limits["UD"][1]))
                servos["LR"].write(random.randint(servo_limits["LR"][0],servo_limits["LR"][1]))
                time.sleep_ms(random.randint(600,1000))
            elif command == 2:
                control_ud_and_lids(random.randint(servo_limits["UD"][0],servo_limits["UD"][1]))
                servos["LR"].write(random.randint(servo_limits["LR"][0],servo_limits["LR"][1]))
                time.sleep_ms(random.randint(400,400))
                
        

        
