LarsLangenbach/halloween-animatronic/cad/params.py

"""
Every tunable number of the Frankenstein head lives here, and only here.

Units: millimetres and degrees. Frame (docs/PLAN.md section 4, decision D2):
  x = 0  the facial midline (symmetry plane). +x is the CHARACTER'S LEFT, the
         viewer's right when looking at the face. Parts are named by the
         character's side: brow_L sits at +x.
  y = 0  the plane through both eyeball centres at rest. +y points out of the face.
  z = 0  the underside of the neck/base interface. +z is up.

Tags in comments (keep them honest; they tell the human what to measure):
  DATASHEET  - a published size; replace with a caliper measurement.
  ASSUMPTION - a decision nobody has confirmed yet.
  MEASURED   - calipered on the real part, or taken from a manufacturer model.
Derived values are computed here, never typed twice; the comment gives the
result so a reader can see it without running anything.
"""

# ---------------------------------------------------------------------------
# Printer and fits (2 x Bambu Lab P2S, 0.4 nozzle, 0.2 layers, PLA/PETG)
# ---------------------------------------------------------------------------
NOZZLE = 0.4
MIN_WALL = 2 * NOZZLE          # 0.8: thinnest wall that prints solid
SLIDE = 0.2                    # per side, parts slid together by hand (class 0.15..0.35)
CLEAR = 0.4                    # per side, printed parts that must never touch
EF_CHAMFER = 0.4               # elephant's foot: chamfer the bed-side edge and mating mouths

# ---------------------------------------------------------------------------
# Fasteners: M2.5 socket head screws into heat-set inserts. Kept for the
# calibration coupon until decision D6 picks the skull screw (PLAN Q7).
# ---------------------------------------------------------------------------
M25_CLEAR = 3.0                # clearance hole; prints ~0.1-0.2 small, still passes M2.5
M25_HEAD = (4.5, 2.5)          # socket head dia, height -- ASSUMPTION: the screws on hand
M25_CBORE = (5.5, 2.7)         # counterbore for that head
INSERT_HOLE_D = 4.0            # ruthex M2.5 x 5.7: hole diameter (coupon picks 3.9/4.0/4.1)
INSERT_L = 5.7
INSERT_HOLE_DEPTH = INSERT_L + 1.0   # 6.7: blind, 1 mm extra for melt overflow
INSERT_WALL = 1.6              # minimum plastic around the hole
INSERT_BOSS_D = INSERT_HOLE_D + 2 * INSERT_WALL   # 7.2

# ---------------------------------------------------------------------------
# Head size (decision D4)
# ---------------------------------------------------------------------------
# The proxy head below is an average adult at scale 1.0. The Cogley modules
# are real parts and never scale; the head scales around them.
HEAD_SCALE = 1.2               # ASSUMPTION (D4): EyeMech eye spacing 75.0 / adult 63 = 1.19
HEAD_SCALES_COMPARED = (1.0, 1.1, 1.2, 1.3)   # layout_check reports each, for D4

# ---------------------------------------------------------------------------
# Proxy head (stands in for the sculpt until M5)
# ---------------------------------------------------------------------------
# Horizontal sections at scale 1.0, z measured from the eye line (eye centres
# at z = 0 here). Each row: (z, half_width, y_front, y_widest, y_back, n_front)
#   half_width  half the width at its widest
#   y_front     the front of the face at the midline (no nose: the sculpt adds it)
#   y_widest    where the section is widest
#   y_back      the back of the head (or of the neck, below the skull). The nape and
#               neck are deliberately thick (neck ~144 x 128 at 1.2x): the open jaw swings
#               back toward them and the cable channel runs down between (2026-10-15)
#   n_front     superellipse exponent of the front half; > 2 = a flatter face,
#               < 2 = a pointed front (the chin in front of the neck)
# ASSUMPTION: rough adult male averages (head breadth ~156, glabella to back
# ~207 with skin, chin to crown ~237), to be replaced by the sculpt.
HEAD_SHAPE = "boxy_temples"   # ASSUMPTION (D4), 2026-10-15; was "average"
HEAD_SHAPES = {
    "average": (
        (+120.0, 20.0, -45.0, -75.0, -105.0, 2.0),   # crown cap
        (+110.0, 48.0, -20.0, -80.0, -140.0, 2.2),
        (+90.0, 66.0, +5.0, -85.0, -168.0, 2.3),
        (+60.0, 76.0, +18.0, -88.0, -182.0, 2.4),    # forehead
        (+30.0, 78.0, +24.0, -90.0, -183.0, 2.5),    # widest (head breadth 156)
        (+10.0, 74.0, +27.0, -90.0, -176.0, 2.6),    # brow ridge
        (0.0, 72.0, +24.0, -88.0, -170.0, 2.6),      # eye line (nose bridge at the midline)
        (-20.0, 70.0, +24.0, -80.0, -158.0, 2.6),    # cheekbones
        (-45.0, 62.0, +24.0, -72.0, -138.0, 2.5),    # nose base; the back is the skull base
        (-68.0, 55.0, +27.0, -60.0, -126.0, 2.4),    # mouth
        (-92.0, 52.0, +22.0, -62.0, -120.0, 2.0),    # jaw: the section runs back to the neck
        (-112.0, 56.0, +16.0, -66.0, -117.0, 1.5),    # chin: neck-wide behind, pointed in front
        (-130.0, 60.0, -10.0, -62.0, -117.0, 2.0),   # neck, just under the jaw
    ),
    # Frankenstein variant: the same heights and depths, with a flatter, wider
    # front half from the forehead to the cheekbones (higher n_front), so the
    # temples clear the EyeMech's side plates.
    "boxy_temples": (
        (+120.0, 20.0, -45.0, -75.0, -105.0, 2.0),
        (+110.0, 48.0, -20.0, -80.0, -140.0, 2.2),
        (+90.0, 66.0, +5.0, -85.0, -168.0, 2.4),
        (+60.0, 76.0, +18.0, -88.0, -182.0, 2.8),
        (+30.0, 78.0, +24.0, -90.0, -183.0, 3.2),
        (+10.0, 75.0, +27.0, -90.0, -176.0, 3.4),
        (0.0, 74.0, +24.0, -88.0, -170.0, 3.4),    # temples: +2 on average
        (-20.0, 72.0, +24.0, -80.0, -158.0, 3.0),
        (-45.0, 62.0, +24.0, -72.0, -138.0, 2.6),
        (-68.0, 55.0, +27.0, -60.0, -126.0, 2.4),
        (-92.0, 52.0, +22.0, -62.0, -120.0, 2.0),
        (-112.0, 56.0, +16.0, -66.0, -117.0, 1.5),
        (-130.0, 60.0, -10.0, -62.0, -117.0, 2.0),
    ),
}
HEAD_SECTIONS_1X = HEAD_SHAPES[HEAD_SHAPE]
NECK_BELOW_CHIN_1X = 60.0      # ASSUMPTION: neck stub from the chin (z -117) down to the base
CHIN_Z_1X = -117.0             # ASSUMPTION: chin bottom below the eye line
NECK_BASE_Z_1X = CHIN_Z_1X - NECK_BELOW_CHIN_1X   # -177: the base interface, z = 0 in the frame
assert HEAD_SECTIONS_1X[-1][0] > NECK_BASE_Z_1X, "the neck section must sit above the base"
EYE_Z = -NECK_BASE_Z_1X * HEAD_SCALE              # 212.4: eye line above the base at HEAD_SCALE
STOMION_DZ_1X = -70.5          # ASSUMPTION (D4), 2026-10-15; was -68.0 (adult ~65-70). The extra
                               # 3 mm at 1.2x opens the eye-to-mouth gap from 2.5 to 5.5, room for a skull shelf

# Skin and skull (decision D7 and Q11 refine these into zones)
SKIN_T = 5.0                   # ASSUMPTION: silicone thickness over the skull, one value for M1
LIP_SKIN_T = 8.0               # ASSUMPTION: silicone in front of the Cogley lip plates
SKULL_WALL = 2.4               # skull shell: 6 perimeters at 0.4

# ---------------------------------------------------------------------------
# Will Cogley modules (inputs/reference), placed whole: one rotation and one
# translation each. Source-frame values are MEASURED from the STEP files.
# ---------------------------------------------------------------------------
EYEMECH_FILE = "reference/eyemech/EyeMech_e3.1.step"
EYEMECH_ROT_Z = 180.0          # the file faces -y; ours faces +y
EYEMECH_EYE_SRC = (37.5, 0.0, 0.0)   # MEASURED: lid sphere centres (+-37.5, 0, 0), R 16.5 / 18.1
EYEMECH_EYE_R = (16.5, 18.1)   # MEASURED: the lids' inner and outer sphere radii
EYE_SPACING = 2 * EYEMECH_EYE_SRC[0]  # 75.0: centre to centre (adult ~63)
EYE_R = 16.0                   # MEASURED: eyeball part 32.0 across
# Keyed lids (D27, lid_keyed.py): his lids perforated so the brushed silicone (D21) locks on.
# PLA gives platinum silicone no bond; each hole fills from the outside and cures into a rivet
# whose head sits in a counterbore flush with the inner face (the eyeball is 0.5 behind it).
LID_KEY_NECK_D = 2.2           # ASSUMPTION: through-hole from the outer face (prints ~2.0; 1 mm holes don't fill with brushed silicone)
LID_KEY_HEAD_D = 3.4           # ASSUMPTION: counterbore on the inner face (the rivet head; the shoulder is the undercut)
LID_KEY_HEAD_H = 0.7           # ASSUMPTION: counterbore depth; the neck is the rest of the 1.6 wall
LID_KEY_PITCH = 5.0            # ASSUMPTION: hole spacing over the shell (4.8 left 0.82 between counterbores, two 0.42 lines need 0.84)
LID_KEY_MARGIN = 1.1           # ASSUMPTION: plain wall kept round every counterbore, to the lash edge, bosses and lever bore
EYE_SOCKET_FRONT = 8.0         # MEASURED: the eyeball's socket (the pivot's cavity) reaches this far in front of its centre
EYEBALL_FILL_FROM = 8.5        # the smooth eyeball (studies/cogley_eyeball.py): his front, iris dish and pupil hole,
                               # is filled out to EYE_R from this far in front of the centre

MOUTH_FILE = "reference/mouth/MouthAssembly.step"
MOUTH_ROT_Z = 180.0            # the file faces -y
MOUTH_STOMION_SRC = (0.0, -92.6, -71.2)  # MEASURED: lip plates' front y; midway between the
                                         # upper plate bottom (z -65.2) and lower plate top (-77.2)
MOUTH_JAW_AXIS_SRC = (-2.4, -40.7)       # MEASURED: (y, z) of the jaw pivot (x axis): JawLink
                                         # bore R4.5/10.5 on the MG996R output spline
MOUTH_TOP_SRC_Z = -19.25                 # MEASURED: the mouth's top plate (TopBase), its highest point

# ---------------------------------------------------------------------------
# Motion (M1 pose sweeps). Joint angles in degrees from the pose the STEP
# files are modelled in (jaw closed, lids closed, eyes straight ahead).
# ASSUMPTION until Cogley's firmware limits and a bench test confirm them.
# ---------------------------------------------------------------------------
JAW_OPEN_DEG = 25.0            # ASSUMPTION: full open (shout); speech uses less
UPPER_LIP_PLATES = ("UpperLeftLip", "Part_34")   # Part_34: the mirrored upper plate
LOWER_LIP_PLATES = ("LowerLeftLip", "Part_37")   # Part_37: the mirrored lower plate
JAW_OVERTRAVEL_DEG = 10.0      # swept past the limit to learn the real margin
JAW_GROUP_CORE = ("JawBase", "JawLink", "Part_33", "Part_22")   # jaw base, both jaw links, and the
                               # tongue (Part_22: its servo sits on the jaw base)
JAW_HORN_R = 14.0              # MG996R output parts (horn, spline, horn screws) centred this close
JAW_HORN_X_MIN = 44.0          # to the jaw axis and outboard of the servo bodies (|x| 3..43) turn with it
JAW_GROUP_BELOW_AXIS = 30.0    # candidates: mouth solids centred this far below the jaw axis; each
                               # joins the jaw if it sits closer to the jaw's parts than the frame's
# EyeMech ranges: DATASHEET = Cogley's firmware servo limits (Code/NewFaceFollower.py,
# 2026-10-15): LR and UD 40..140, lids 90..170 / 90..10 / 90..160. Servo degrees, swept
# here as if the linkages were 1:1, which can only overstate the motion (a safe upper bound).
EYE_PAN_DEG = 50.0             # DATASHEET (upper bound): +- left/right
EYE_TILT_DEG = 50.0            # DATASHEET (upper bound): +- up/down
LID_TOP_OPEN_DEG = 80.0        # DATASHEET (upper bound): top lids, closed (as modelled) to open
LID_BOTTOM_OPEN_DEG = 80.0     # DATASHEET (upper bound): bottom lids
SWEEP_STEP_DEG = 5.0
MOTION_CLEAR_MIN = 1.0         # mm: least gap between a moving part and anything else, any pose
# Clashes the team accepts on bench evidence: ((moving label, static label), max mm3, why).
# Reported as info, not as a failure; anything larger, or any other pair, still fails.
ACCEPTED_CONTACTS = (
    (("Part_22", "MG90s_servo_FIX_v1_Mirror_"), 10.0,
     "D12: tongue corner vs a mouth servo (up to 8.6 mm3 in CAD); the team's printed mouth "
     "runs without trouble (2026-10-15)"),
)

# ---------------------------------------------------------------------------
# Reserved space: placeholders the later milestones design inside
# (absolute mm in the head frame at HEAD_SCALE)
# ---------------------------------------------------------------------------
# Brow mechanism, per side (M2): a servo bay above the EyeMech and a carrier
# band in front of it reaching down to the brow line, both trimmed by the
# skin's inner surface. Heights are mm above the eye line.
BROW_X = (14.0, 62.0)          # ASSUMPTION: |x| range, each side
BROW_BAY_Y = (-40.0, 60.0)     # front is trimmed by the skin
BROW_BAY_Z = (38.0, 75.0)      # ASSUMPTION: clear of the EyeMech's central pivot (top at +35.7)
BROW_BAND_Y_MIN = 8.0          # ASSUMPTION: the carrier band stays in front of the EyeMech pivots (front y +5)
BROW_BAND_Z = (20.0, 40.0)     # ASSUMPTION: eyebrow line ~24-30 above the eye centre at 1.2x
# Cable channel for every servo lead to the neck (M3 designs the real route)
CABLE_D = 25.0                 # ASSUMPTION: 19 three-wire leads with connectors and slack
CABLE_PATH = ((0.0, -140.0, 205.0), (0.0, -120.0, 140.0), (0.0, -114.0, 80.0),
              (0.0, -90.0, 25.0), (0.0, -90.0, 0.0))   # ASSUMPTION: behind the EyeMech, behind the mouth
                                   # and the open jaw, down the back of the neck, out square through the base
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
