LarsLangenbach/halloween-animatronic/cad/brow_check.py

"""
M2 eyebrow check: the brow mechanism (brow.py) in place, at rest and through
its whole travel, for both sides.

  moving   carrier (turns THETA_LOWER..THETA_RAISE about the pivot, plus
           OVERTRAVEL_DEG either way), servo horn (turns the matching crank
           angle about the servo shaft), pushrod (between the two balls)
  against  the EyeMech (every part at rest, plus the swept eyes and lids from
           pose_sweep), the brackets and servos, the other brow
  skin     the pad faces' push / pull against the skin over the travel
           (limits BROW_PUSH_MAX / BROW_PULL_MAX), and every fixed brow part
           inside the skull's inner surface (pads: inside the skin's inner surface)
  drive    servo angle range and the worst pushrod transmission angle
  stops    the two hard-stop set screws: no contact with the horn inside the
           travel, contact within OVERTRAVEL_DEG past each end
  rig      the bench rig (brow_rig.py, left brow): every moving part clear of it

Designed contacts (hub on its shoulder screw, horn on its spline, pushrod in its
ball links, servo tabs on the bracket plate) are allowed to overlap as much as
they do at rest, but not more.

Run:  python cad/brow_check.py      (after modules.py and brow.py)
  -> <out>/brow/brow.md, brow.png (+ tiles)
Final line: BROW OK, or BROW: n issue(s), each listed as a WARN line.
"""
import math
import os
import sys
import warnings

import numpy as np
import trimesh
from scipy.spatial import cKDTree
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
