LarsLangenbach/halloween-animatronic/(commit log)

2026-10-16 Frankenstein head: layout, motion, eyebrows v1.1, skull v0 with joints
    Code-CAD project for the conversational Frankenstein animatronic head
    (build123d + manifold, checked by cad/check.py).
    - M1 layout: Cogley EyeMech and mouth placed in a 1.2x proxy head with
    boxy temples (D4 = A2); layout, pose sweeps (jaw, eyes, lids) and
    reserved brow bays and cable channel all pass.
    - M2 eyebrows v1.1: two snap pads per brow on one skewed pivot, MG90S
    2:1 pushrod drive, adjustable hard stops, bench rig; brow_check passes.
    - M3 skull v0: wall on true-offset envelopes, normal-walled openings,
    four printable pieces plus shelf, brow mount plates and 24 screwed
    seam joints; skull_check passes.
    - D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
    [EyeMech_e3.1.step, MouthAssembly.step, adafruit_1143_micro_servo.step, brow_bracket_L.stl, brow_bracket_R.stl, brow_carrier_L.stl, brow_carrier_R.stl, brow_rig.stl]
2026-10-16 Skull: EyeMech cradle and retaining strap; print plates
    - Shelf becomes the EyeMech's cradle: pads under its four feet, a rear
    stop for eye-depth shims, extended forward under the side plates,
    bolted to four ledges on the side walls.
    - New skull_eye_strap 0.4 over the back of the EyeMech base plate,
    bolted to two ledges on the back upper piece.
    - make_plates.py and output/plates: eyebrow plate and the EyeMech
    e3.2 MG90s-A plate for printing.
    - skull_check: feet-on-pads designed contact, 0.02 rounding tolerance.
    check: PASS (0 hard failure(s), 0 warning(s))
    [skull_back_lower.stl, skull_back_upper.stl, skull_eye_strap.stl, skull_front_lower.stl, skull_front_upper.stl, skull_shelf.stl]
2026-10-16 Skull: neck base plate and rear access panel
    The neck plate closes the bottom of the neck with a collar screwed through
    the wall (6 x M3), 4 x M4 holes for the stand and the cable exit. The rear
    access panel is cut from the back upper piece and rests on a narrow lip
    with a pad and insert behind each side's midpoint (4 x M3 countersunk).
    The skull render gains a back view and a panel-off view.
    [skull_access_panel.stl, skull_back_lower.stl, skull_back_upper.stl, skull_front_lower.stl, skull_neck_plate.stl]
2026-10-16 Print guide: EyeMech supports on; add Cogley's original 3MF
    His project file enables tree (auto) supports at a 30 degree threshold for
    every part; opening it carries those settings.
    [eyemech_e3.2_MG90s_A_cogley.3mf]
2026-10-16 Sculpt base v1; service paths and service_check
    Sculpt base (M5, started early, D13): the whole head as a solid, the
    skull's outside raised by 3 mm so the skin is never carved thinner; eye
    sockets inside the skull's eye openings with the lids' sphere at the true
    eye positions; grooves for the midline, brow windows, mouth opening and lip
    line. Split at z 186 into two pieces joined by dowels, on a base plate with
    mold registration keys. sculpt_check confirms the skull sits inside it and
    the eyes sit on the EyeMech's eyeballs.
    Service: the back upper piece lifts off up and back; the EyeMech and both
    brows then slide out together. Tabs on that piece's seams are placed per
    tab by its way out, an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
    [sculpt_lower.stl, sculpt_plate.stl, sculpt_upper.stl, skull_back_lower.stl, skull_back_upper.stl, skull_eye_strap.stl, skull_front_upper.stl, skull_shelf.stl]
2026-10-16 Sculpt base: M4 x 12 plate screws, deeper dowel holes
    From review: an M4 x 16 bottoms out in the 10 mm insert holes before the
    plate is clamped, and 12 + 12 mm holes left no spare length for a 24 mm
    dowel. Holes now 13 deep a side; one stale plan line on the rear stop.
    [sculpt_lower.stl, sculpt_upper.stl]
2026-10-16 Re-base on Cogley's Robot Head a2.0.33 (D14): import and fit study
    His whole head (Patreon download) goes under inputs/reference/head_a2.0.33
    with ASCII names. cogley_head.py imports his reference assembly into our
    frame, eyes on ours, grouped frame / extras / shell / eyes / mouth / brows /
    hardware; read3mf.py reads Bambu 3MFs without lxml. The study
    cogley_fit.py fits it inside our head: his EyeMech lands within 1.7 mm of
    ours, his mouth sits 13.4 mm higher, and his mouth's top plate is the eye
    shelf (Q14). Plan v2: D14-D16 (his head, his brows, keep the printed eye
    set), Q16-Q18, R12, and the re-base work list. OBJ and EasyEDA files go
    through LFS.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
    [AllComponents.stl, BambuPrintfile.3mf, ProDoc_Eyes_Brow_Neck_2025-04-16.epro, ProDoc_Mouth Board_2025-04-16.epro, reference_assembly.obj]
2026-10-16 Docs: SG90 vs MG90S, servo count for Cogley's head, build log
    The head needs 19 MG90S (mouth 9, eyes 6, his brows 4) and 2 MG996R; the
    team's 3 plastic-gear SG90s are for bench tests. BOM gains a datasheet
    comparison (same footprint and spline size; metal gears, ball bearing and a
    tapped shaft on the MG90S, which sits about 1.5 mm deeper) and how to spot
    fake MG90S. Q4 updated; build log entry for the re-base.
2026-10-16 Q18: no TPU on hand; brow bars need TPU 95A, not PLA
    Cogley's brow bar is a pleated strip that stretches and bends whenever its
    two servos differ; PLA would load the servos and crack at the pleats.
2026-10-16 D17: Cogley's complete head is the face's base; Q16 keep his mouth
    The placeholder face looked nothing like a human. The sculpt base and the
    skin now follow his head, outer shell included; his frame, frame extras
    and shell are cleared to print as designed. Our skull pieces and sculpt
    base v1 retire.
2026-10-16 Assembly: how the printed eye mechanism mounts in Cogley's frame
    It rests on the mouth's top plate between the frame's side walls; two M3
    screws per side go through the frame into inserts in the base plate's end
    holes, which the printed plate already has; the cheek bone sits under its
    edges. The MG90S servos clear the top plate by 2.7 mm.
2026-10-16 D18 (proposed): the second mouth board drives the eyes and the brows
    Cogley's mouth board (Pico, 12 servo outputs) is the master and signals
    two Eyes/Brow/Neck boards over 2 wires each; eyes 6 + brows 4 fit one
    mouth board with a combined program.
2026-10-16 Firmware: Cogley's eye and brow programs on mouth boards (D18)
    The team has mouth boards only. His eyes.py and Brows.py use servo pins
    the mouth board has; only the mode switch moves to GP28. Wiring, link
    cables and flashing in firmware/README.md.
2026-10-17 Face mask (D19): a man's face shell on the mechanism
    The sculptor works on a thin face mask instead of a sculpt base: the
    MakeHuman base mesh's face (CC0), scaled and warped so its eyes sit on the
    eye mechanism and its lips on Cogley's lips, given a man's jaw and brow,
    moved clear of his head (6.9 mm at the closest), trimmed to a mask and
    thickened 3 mm. Also the sculpt base v2 (a wrap of his head, wrap.py),
    whose wrap the mask is checked against.
    [base.obj, face_mask.stl, sculpt_lower.stl, sculpt_plate.stl, sculpt_upper.stl]
2026-10-17 Face mask v2: closed eyes, natural nose and mouth, smooth edge, onto the skull
    Team feedback on v1. The skin is now read as a radius over directions from
    inside the head, so openings fill smoothly (closed lids with a lash line,
    a lip line), the outline is a smooth egg reaching over the forehead, the
    nose and mouth are pinned at natural width, and pushes clear of Cogley's
    head use the sculpt base's tight wrap.
    [face_mask.stl]
2026-10-17 Face mask v3: smooth surface, ears, mouth designed on Cogley's lip plates
    Team feedback on v2: the head is smoothed before it is read and the skin
    after; the mouth's corners sit past the lip plates' ends and the lips 8 mm
    in front of them; natural closed eyes; the outline takes in the ears.
    [face_mask.stl]
2026-10-17 Face mask v4: open eyes marked on the eye axes; real lips on the lip plates
    Team feedback on v3. MakeHuman's own lips are kept, with the lip line on
    the gap between Cogley's lip plates and the corners just past their ends.
    Each eye is a designed open eye without holes: an almond opening, an
    eyeball just behind the lids, and an iris ring and pupil on the eye
    mechanism's axis.
    [face_mask.stl]
2026-10-17 Face mask v5: MakeHuman's own eyes and lips on the mechanism
    Team feedback on v4. The eyes are MakeHuman's eyelids with its own eyeball
    helpers filling the openings (open, no holes), centred on the eye
    mechanism. The lips are MakeHuman's own, scaled evenly so their corners
    reach just past the ends of Cogley's lip plates.
    [face_mask.stl]
2026-10-17 Face mask v6: eyes exactly on the eye axes, MakeHuman's real lips
    MakeHuman's eyeballs are placed rigidly on the eye mechanism's eye centres
    (0.000 mm off), and the iris and pupil marks are circles round the eye axis
    (they were about 8 mm outboard). The lip landmark found the crease under the
    lower lip; it now finds the gap between the lips and the real corners, so the
    lips scale x1.11 to Cogley's plates. The gap is closed with a clean line. The
    shell's inside is its own smooth surface and never crosses the skin.
    print_check gets a short-range wall test for meshes over 200 k faces.
    [face_mask.stl]
2026-10-17 Face mask v7: flat lips with the parting line and lip outlines; smaller iris rings
    The sculptor shapes the lips, so the mask's lips are flattened, with the long
    parting line where they meet and a line round each lip. The iris ring (R 6.5)
    ran onto the eyelids; it is now R 4.0.
    [face_mask.stl]
2026-10-17 Face mask v7b: mouth area completely flat, with the lip lines
    The lips' area is refilled as a smooth membrane from just under the nose to
    the crease above the chin; the smaller patch left the upper lip's bulge as a
    ledge.
    [face_mask.stl]
2026-10-17 Face mask v8: 2 mm shell; flat eyes with axis marks, low nose guide
    Saves filament (207 cm3, was 364). The eyes are flat with the iris ring and
    pupil on the eye axes; the nose is kept at 35 % of its height as a guide.
    [face_mask.stl]
2026-10-17 Face mask v9: almond eyelids back, eye openings filled flat
    The team wanted the eyelids kept and only the eyeball and its target marks
    removed: wherever an eyeball is the outermost surface, the opening is filled
    with a smooth membrane from the lids' edges.
    [face_mask.stl]
2026-10-17 Log: the printed mask's lip line is 5-7 mm low; image of where to sculpt it
2026-10-17 Process images: the printed mask see-through on Cogley's head
2026-10-26 Mold base, assembly manual, EyeMech plates and servo firmware; GitHub remote
    Commits the work since 5478003: the plaster-mold base and walls
    (mold_base.py, mold_check.py, PLASTER_MOLD.md, print files and plates),
    the assembly-manual study and its renders, the Cogley eyeball and
    EyeMech e3.2 plates, the Pico servo-control firmware, the budget sheet,
    process images 33-38 and the matching doc updates. CLAUDE.md now names
    the private GitHub remote and its one collaborator.
    [Halloween_Animatronic_Budget.xlsx, cogley_brow_bar_L.stl, cogley_brow_bar_R.stl, cogley_brow_bars_tpu_plate.stl, cogley_eyeball_smooth.stl, eyemech_B_horn_parts_plate.stl, eyemech_e3.2_MG90s_B_cogley.3mf, eyemech_e3.2_servo_sizing_plate_cogley.3mf]
2026-10-29 Enclosure concept: a printed canister round the head (plan M8, D23-D25)
    A concept study (cad/studies/enclosure_concept.py) drawn to scale round the
    sculpt wrap and the face mask: a base drum and top cap in four quadrants
    each, a rolled 1 mm PETG window in slits, a 120-degree opaque back column,
    a pedestal on the deck, and the proposed neck spine behind the jaw's swing
    into Cogley's frame. The base holds the power box and the two boards of the
    Head Power Wiring doc, the human's Sony SRS-XB12 behind a snap-out front
    grille, and a back hatch; the Logitech webcam sits in the cap's front band.
    Plan: M8 added; Q5, Q17, Q19, Q20, Q21 answered; D23, D24, D25 proposed.
    BOM: enclosure section. Build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
    [enclosure_concept.py]
2026-10-29 Enclosure and neck modelled, v0 (M8, D23-D25)
    cad/enclosure.py builds the canister round the head and the neck in the
    assembled pose: base wall and deck ring quadrants, tray, deck, pedestal, the
    grille and hatch panels, the back column in 2 x 2 pieces with forks for the
    sheet, the cap's slit ring, walls (with the webcam's flat front band) and
    top ring quadrants, the lid, and the neck (foot, tube, hollow spine notched
    for Cogley's ribs). 31 prints, all inside the 256 bed. cad/enclosure_check.py
    checks the head's clearance, the sheet against every part, the neck against
    all of Cogley's parts, the jaw swept to 35 degrees, the bay's contents and
    the bed, and renders a sheet. Numbers in params.py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
    [enc_base_B.stl, enc_base_F.stl, enc_base_L.stl, enc_base_R.stl, enc_cap_B.stl, enc_cap_F.stl, enc_cap_L.stl, enc_cap_R.stl]
2026-10-29 Enclosure v1: eleven thin prints plus two PETG sheets, for a one-day build (M8, D26)
    Two printers and under 24 hours: v0's 31 prints (about 130 printer-hours)
    become eleven thin prints (about 27 hours) and two 1 mm PETG sheets. The
    window is one clear tube with the back see-through; the base's wall is a
    painted PETG band between two printed rims. Prints: cap halves, deck halves,
    bottom ring halves (all turned 45 degrees on the bed), the tray, a D 90
    pedestal tube, the two panels and the neck. The webcam hangs inside the
    window and looks out through it.
    cad/enclosure.py rewritten; enclosure_check.py checks the band too and
    tests the bed in the print pose; the 24 superseded v0 print files rem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
    [enc_base_B.stl, enc_base_F.stl, enc_base_L.stl, enc_base_R.stl, enc_bottom_B.stl, enc_bottom_F.stl, enc_cap_B.stl, enc_cap_F.stl]
2026-10-29 Enclosure v1 checked (PASS), attachment renders, plate file; lid sliders to the servos' ends
    Full check on the v1 enclosure: PASS, 0 hard failures (the six fits_bed
    warnings on the halves are measured before their 45-degree print turn).
    Snapshot 51 with the enclosure sheet, views, print check and a new study,
    cad/studies/neck_mount.py: how the head attaches to the base, cut at the
    midline with every screw. make_plates.py lays the pedestal and the two
    panels out on one bed for tonight's printing.
    Firmware, at the human's request tonight: the four lid sliders run -9..189
    and the Pico program (pico_servo_ctl.py) stretches the pulses to 400..2600 us;
    EYES OPEN and LIDS WIDER +10 buttons; the SH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
    [eye_anim.py, make_plates.py, neck_mount.py, pico_servo_ctl.py, servo_controls.py]
2026-10-29 Panels print lying flat, inside face down, with supports (the slicer could not support them standing)
2026-10-29 Enclosure v1 print files (slicer-ready) and tonight's print folder
    [enc_bottom_B.stl, enc_bottom_F.stl, enc_cap_B.stl, enc_cap_F.stl, enc_grille.stl, enc_hatch.stl, enc_pedestal.stl, enc_top_B.stl]
2026-10-31 Keyed lids (D27), UART link between the Picos (D28), lids blink again, Frank mouth driver
    - cad/lid_keyed.py and cad/cogley_plate.py: Cogley's lid sets with silicone key holes, plate STLs and renders in output/plates
    - firmware: cogley_mouth_main.py (mouth board, with the link), pico_servo_ctl.py forwards `e <pin> <angle>` over UART0, share_port.py, brow_anim.py, servo_controls.py --link, restored 2026-10-27 lid poses
    - frank/mouth.py drives the mouth board and reaches the eye board through the link
    - docs: build log entries for 2026-10-29 and 2026-10-30, plan, print guide, firmware README; process_images 52-54
    [cogley_lids_keyed_plate.stl, cogley_lids_plate.stl]
2026-10-31 Frank: eyes alive inside Frank (gaze.py), strangers remembered on the name (D29), go_quiet tool, pause-on-interrupt, voice watchdog
    - frank/gaze.py runs eye_anim through the mouth board link while Frank speaks; /eyes pause and /eyes alive
    - Strangers are greeted, asked who they are and remembered in the same reply (D29); memory notes on return
    - go_quiet tool: silent until his name is said or the time is up
    - Interruptions: pause his voice on a loud microphone, stop on two new words, resume otherwise
    - voice.py: watchdog recovers a stalled sound-card write, filler piece fixed, dead player restarted
    - start.sh gains pyserial for --mouth auto; docs, plan and build log updated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
    [brain.py, chat.py, ears.py, eyes.py, faces.py, gaze.py, mouth.py, voice.py]
2026-10-31 Face performance engine v1 (frank/engine) for NightHack
    An orchestrator, an emotion synthesiser and an animator drive Frank's eyes,
    lids and brows, plus the emotion part of the mouth, at 50 Hz. Claude picks
    the expression tags; the engine decides how and when the face shows them.
    - orchestrator.py: eight states from the chat loop's events and the vision,
    tags fired when their words play, a 1.2 s minimum hold between tags, gaze
    on whoever is talking, and an eye hold behind /eyes pause | alive
    - synth.py: a PAD mood resting at Frank's dry home, plus one transient per
    tag (attack, overshoot, hold, decay), blended region by region
    - animator.py: blinks per state, engaged saccades, gaze av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
    [chat.py, mouth.py]
2026-10-31 Face preview: the page comes up even when the head can't be opened; no gaze.py beside the engine
    preview.py --head crashed before serving when the mouth board couldn't be
    opened (pyserial missing, no board, port busy), so localhost had nothing to
    answer. It now prints why and carries on drawing only. It also opened the
    mouth with gaze.py's eyes running, which would have fought the engine for
    the eye servos: now Mouth(eyes=False), as chat.start_face does.
2026-10-31 Face editor live on Frank's session, with the 3D body twin as the hero view
    chat.py and web.py now start the face editor (frank/engine/preview.py's page)
    on 127.0.0.1:8820 with Frank's own engine, so every value on it follows the
    real conversation: state, mood, tag weights, joints, the chart, and a new
    Live session card (who is in view, what he hears and says, his tags, and the
    engine's decisions as they happen). --editor-port moves it, 0 turns it off.
    The editor and web.py's "His face" card show the 3D body twin
    (perform/body.py, http://127.0.0.1:8810/?hero=1) in place of the 2D sketch
    whenever the body server is up, moved by the same servo lines the engine
    sends (--mouth socket://127.0.0.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
2026-10-31 Frank: explains how he works to anyone who asks, knows he's at NightHack SF, talks x1.5 faster
    - system_prompt.md: "How you actually work" replaces the deflect-to-makers rule; true facts
    about the skull, skin, servos, Picos, hearing, brain, voice, vision and memory for him to
    draw on, answered at the asker's level.
    - He knows the venue (NightHack, Founders Inc., San Francisco) and that he slept through the flight.
    - voice.py / audio.py: pitch-preserving x1.5 time-stretch in the voice player.
    - Build log entries for all three, CHARACTER.md and README updated.
    [audio.py, chat.py, scenarios.py, voice.py, web.py]
2026-10-31 Face engine: emotion map to steer his feeling by hand
    The editor's new first card is an emotion map: pleasure left to right,
    arousal bottom to top, the ten tags at their map positions and a dominance
    slider. Dragging a point makes his face the mix of the tags near it (a
    Gaussian of the PAD distance through the synthesiser's region blending),
    plus the map's own axes so the calm half reads; the 3D twin and the head
    follow. Release hands the face back to Claude's tags. Engine.steer /
    release, POST /steer, meta.map, snapshot.steered.
    preview.py now shares its routes through an Api class that web.py serves
    under /engine/ (halloween-animatronic-f9), and reads a POST's body before
    refusing it, whi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
2026-10-31 Frank's all-in-one page: tabs, the live face with its emotion map, keys bar
    web.html rewritten as one retro green-terminal page with tabs; the Face
    tab holds the 3D body twin, the engine's readouts and the emotion map
    (POST /engine/steer). web.py serves the face editor's routes under
    /engine/ from chat.face_api (engine/preview.py's Api), which
    chat.start_face now creates. Built by halloween-animatronic-f9.
2026-10-31 Body twin (D32): the CAD head moves with the real one
    perform/body.py is the body server: the one program that holds the
    mouth board's port (or simulates the boards with --sim), so Frank, the
    face engine and the slider windows all talk to the head through
    socket://127.0.0.1:8811, and the twin page (http://127.0.0.1:8810,
    ?hero=1 for the hero view) moves Cogley's head through its linkages from
    the same lines. cad/twin_export.py writes the GLB (LFS) and its rig;
    robots/frank/robot.json holds the calibration. The slider windows open
    socket:// URLs. Built by halloween-animatronic-1f. Cogley's CAD: private
    remote only.
2026-10-31 Statechart editor for the face engine's conversation states
    frank/statechart: a chart format and runtime, ChartedEngine (the face
    engine with its states read from charts/frank.json, reloaded on save) and
    an editor on port 8830. Not switched on: chat.start_face still uses the
    hand-written Engine. Tests check both engines agree. With two research
    notes on animation state machines and servo limits and power. Built by
    halloween-animatronic-bb.
2026-10-31 Research: lifelike animatronic face design, applied to Frank
    DOF priorities, skin engineering, mechanisms and actuators, professional
    character craft, and an audit of the current design. Written by
    halloween-animatronic-fa.
2026-10-31 Enclosure v1: the neck clamps his frame (D30), the band printed (D31), build manual pictures
    The neck now clamps Cogley's nape ring between a saddle, a collar in its
    hexagonal hole and two plates with 4 x M4, so nothing is drilled in his
    parts (D30); the base's wall is a band printed in two halves with nut
    slots for the panels instead of a PETG sheet (D31). Print files rebuilt,
    the neck plate, the pedestal's hand-cut lead door, and one picture per
    step of the enclosure build manual. These two decisions were written as
    D27 and D28 before Anushhka's keyed lids and Pico link took those numbers;
    renumbered to D30 and D31 everywhere (D32 is the body twin).
    Also the shared docs from tonight's ses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
    [enc_band_B.stl, enc_band_F.stl, enc_grille.stl, enc_hatch.stl, neck.stl, neck_clamp_L.stl, neck_clamp_R.stl, neck_plate.stl]
2026-10-31 Handover to the Mac for NightHack, and tonight's build log
    docs/HANDOVER_2026-10-30.md: what's new tonight, getting it onto the Mac
    (git lfs pull), the checks before the doors open (servo extremes, the jaw,
    the body server first, the face's sides and directions in the editor, the
    twin's calibration), running the show (frank --mouth socket://...), the
    pages and keys, what to do when something goes wrong, what hasn't run on
    the head, and what's built but off (statechart, Frank online), with notes
    from every session. BUILD_LOG: the live editor, the twin as the hero, the
    emotion map, the merges and the D30/D31 renumbering.
2026-10-31 Prompt to face animation; the statechart editor's routes without a server
    frank/engine/animate.py: a written prompt becomes a short timed
    performance written by Claude (Opus 5.5, low effort, structured JSON,
    refusal fallback) in the engine's vocabulary (expression tags,
    emotion-map glides, blinks and flinches, where the eyes look), cleaned
    and clamped, then played on the live engine by Player, which hands the
    face back at the end. Engine.look_at holds the eyes; synth.steer(...,
    tags=True) lets a performance's tags show over the map. A Prompt to
    animation box in the editor and in Frank's page's Face tab; routes
    /animate (needs a key: laptop only), /play, /stop.
    frank/statechart/api.py: the n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
2026-10-31 Frank off the laptop: password-gated gateway, Cloudflare tunnel, frank-live.vercel.app (D33)
    frank/public.py: an aiohttp gateway on 8801 in front of web.py (8800) and the body
    server's twin (8810). A password once (?key= becomes a cookie), requests sent on with
    Host localhost:8800 so web.py's local-only check holds, the twin under /twin/ with its
    absolute paths rewritten, the page's 127.0.0.1 links rewritten, the face editor kept
    private, and event streams padded so Cloudflare doesn't hold Frank's slow stream back.
    Nothing in web.py or body.py changes.
    frank/live/: the Vercel project frank-live (Anushhka's account, no Git connection), a
    redirect to the quick tunnel's address; point.sh re-po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
    [public.py]
2026-10-31 Frank online: 3D twin, State machine tab, prompt-to-animation examples
    The public face demo (https://frank-face.vercel.app) now carries:
    - the 3D twin: perform/twin fed by perform/body.py's board models in
    Pyodide, driven through a thread-free mouth.Mouth exactly as the real
    boards are (twin_shim.js replaces the twin's /events stream);
    - a State machine tab: frank/statechart/editor.html with its /api routed
    to statechart.api.handle over a FileStore in Pyodide's file system; the
    face runs as ChartedEngine and follows the chart saved last; each
    visitor's charts stay in their own localStorage (statechart_shim.js,
    which also applies the site's retro palette and says vibe-coding is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
2026-10-31 Studio: one app for model, constraints, animation and a simple state machine
    studio/app.py (http://localhost:8840) puts the pieces in four steps: pick
    Frank's CAD or upload your own (perform/onboard, mounted at /onboard/); the
    constraints read from the robot's files (servos, what each moves in the CAD
    rig, shared bodies, firmware and soft limits, speeds; the engine's channels
    with range, rest, smoothing, speed cap and travel), editable and applied to
    the running engine at once; the animation studio (emotion map, tags, events,
    recording, prompt to animation, a saved library); and a node-based state
    machine where each state holds several animations and arrows fire when done,
    after N seconds or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
2026-10-31 Studio online: the same app in the browser (Pyodide), deployed to frank-studio.vercel.app
    studio/routes.py holds the studio's routes without a server, so app.py serves
    them over HTTP and studio/online/web.py runs them in Pyodide with Frank's engine
    (frank/online/browser.py, as frank-face does). studio/online/build.py writes
    output/frank-studio/ for its own Vercel project (Git disconnected; deploy only
    that folder). Online the pre-written examples play (no key) and CAD upload says
    it needs the laptop app; each visitor's saves stay in their browser.
2026-10-31 Studio: starts without perform/onboard (Frank works; CAD upload says what's missing)
    [app.py]
2026-10-31 Studio --head: drive the real head through perform/body.py, soft limits applied
    studio/app.py --head socket://127.0.0.1:8811 sends every line the studio's
    mouth writes to body.py's socket as well as to the in-process board models, so
    the real head and the twin move together. Servo angles are clamped to their
    soft limits on the way out (set NAME deg, e PIN deg); the try sliders move the
    real servo too; the top bar shows whether body.py is connected. A reset that
    changes nothing no longer rewrites robot.json.
    [app.py, constraints.py, routes.py, runtime.py]
