LarsLangenbach/halloween-animatronic/(notices)

Notices in the files:
cad/params.py:
mesh (CC0), warped so its features sit on the mechanism, clear of Cogley's head. Its skin is
